afpineda/OpenSourceSimWheelESP32/doc/hardware/subsystems/BatteryMonitor/BatteryMonitor_en.md

# Battery monitor subsystem

This subsystem is for **battery-operated** systems, only.

> [!CAUTION]
> This subsystem is designed to work with batteries below 5 volts.
> Higher voltages may damage your DevKit board.

## Purpose

The purpose of this subsystem is to provide an estimation
of how much battery charge is left,
so the user knows when to plug the charging cable in.
The battery level is a percentage of charge left in the range 0% to 100%
(also known as "state of charge" or "SoC").
Battery level is known to the hosting PC through Bluetooth Low Energy.

There are several (exclusive) **alternate implementations** to choose from:

- *Simple voltage divider*: can be found in some ESP32 DevKit boards
  as a built-in feature.
- *Battery monitor*: avoids battery drainage
  thanks to additional on/off circuitry.
- *"Fuel gauge" chip*: provides state-of-the-art SoC estimation.

The firmware will read the battery level every few minutes
and it takes only a few milliseconds long.

## Simple voltage divider or battery monitor

### Limitations

**Accurate battery SoC cannot be achieved** in this project
(or in most home-made electronics) using these implementations.
SoC estimation is harder than you may think.
For SoC, consumer electronics use a combination of complex circuitry,
factory measurements and software (even Artificial Intelligence).
This is out of scope for a home-made project.

For further reading, look at this article:
[Battery Management System (BMS): Effective Ways to Measure State-of-Charge and State-of-Health](https://www.integrasources.com/blog/battery-management-system-bms-state-charge-and-state-health/)

### Working principles

A battery monitor needs to read the output voltage of the battery
(*not* the powerboost output voltage), this is,
the voltage at the positive terminal
(the negative terminal is wired to ground - `GND`).
As the battery gets discharged, that voltage will go down.
The output voltage of a LiPo battery is in this range (more or less):

- 4.0V to 5.0V when the powerboost module is charging the battery.
- 3.7V when the battery is fully charged.
- Over 2.4V or less when the battery is discharged.
  The powerboost module will cut power to avoid over discharge.

In some way, this output voltage should be read through an ADC pin,
however, there are two restrictions:

- The output voltage of the battery exceeds 3.3V
  and would damage the DevKit board,
  so that voltage has to drop down to a suitable range.
- Reading the output voltage could discharge the battery itself,
  so the battery monitor should not draw any relevant current.

### Battery monitor

This circuit is switched on and off by the means of an NPN-PNP pair.
It will not draw any relevant current
except for a few milliseconds every few minutes.

This circuit uses the following terminals:

- **Battery (+)** (battery positive terminal):
  a wire has to be soldered to that terminal at the powerboost module.
- **battEN** pin: enables or disables the circuit.
  Attached to an output-capable GPIO pin at the DevKit board.
- **battREAD** pin: provides the current battery level.
  Attached to an ADC-capable GPIO pin at the DevKit board.

`GND` pin is shared with the main circuit,
wired to `GND` at the powerboost module.

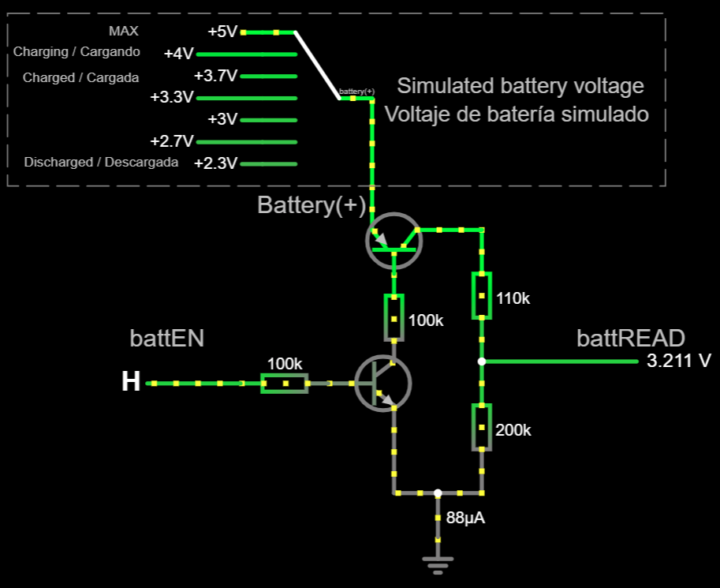
[picture p27: doc/hardware/subsystems/BatteryMonitor/BatteryMonitor_falstad.png]
Battery monitor circuit


[This simulation at falstad.com](https://falstad.com/circuit/circuitjs.html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)
shows how it works, but note that the rectangle is not part of the circuit.

Needed parts:

- 100K-ohms resistor (x2)
- 110K-ohms resistor (x1), **1% tolerance**.
- 200K-ohms resistors (x1), **1% tolerance**.
- A bipolar junction transistor (x1), NPN type: any kind should work
  (for example: [BC637](https://www.onsemi.com/pdf/datasheet/bc637-d.pdf)).
- A bipolar junction transistor (x1), PNP type: any kind should work
  (for example: [BC640](https://www.onsemi.com/pdf/datasheet/bc640-d.pdf)).

In fact, any impedance will work as long as `battREAD`
is below 3.3 volts at all times (assuming `battery(+)` is always below 5 volts).
However, the higher the voltage drop,
the less the accuracy in battery levels (state of charge).

Pay attention to the pin-out of your transistors.
It *may not match* the one shown here.

Look at this [layout design](./BatteryMonitor.diy) using
[DIY Layout Creator](https://github.com/bancika/diy-layout-creator).

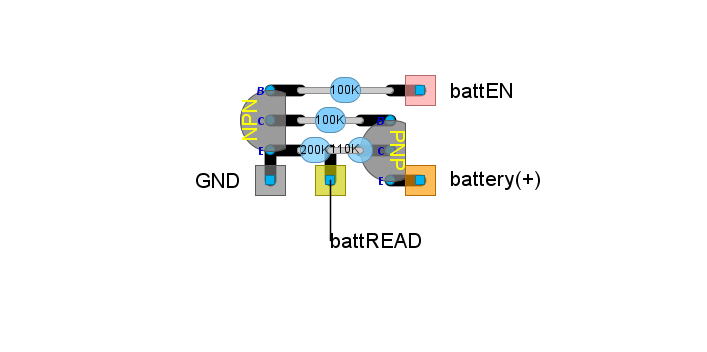
[picture p28: doc/hardware/subsystems/BatteryMonitor/BatteryMonitor_diy.png]
Board design


### Simple voltage divider

This kind of circuit is built into some ESP32 boards.
In such a case, there is no need to build this subsystem.
However, we also provide the design in case
you are short of available GPIO pins for the previous alternative.
The circuit uses the same terminals, except for `BattEN`, which is not needed.

- **Battery (+)** pin (battery positive terminal).
  Usually not exposed in the alluded boards.
- **battREAD** pin: provides the current battery voltage.
  May be exposed or not in the alluded boards.
  If not exposed, it will be wired internally to a certain GPIO.
  If exposed (with another tag, for sure),
  you must wire it externally to an ADC-capable GPIO. Check the datasheet.

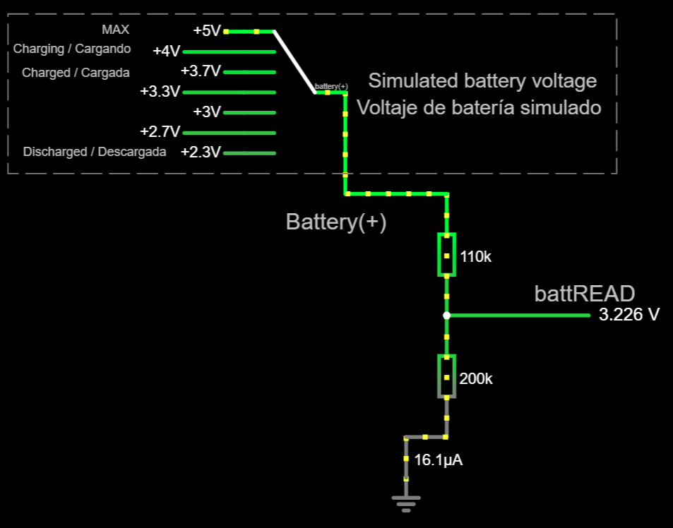
[picture p29: doc/hardware/subsystems/BatteryMonitor/BatteryDivider_falstad.png]
Voltage divider for the battery monitor


[This simulation at falstad.com](https://falstad.com/circuit/circuitjs.html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) shows how it works, but note that the rectangle is not part of the circuit.

Needed parts:

- 110K-ohms resistor (x1), 1% tolerance.
- 200K-ohms resistor (x1), 1% tolerance.

In fact, any impedance above 100K-ohms will work as long as `battREAD`
is below 3.3 volts at all times.
Do not use lower impedance or this circuit will drain your battery quicker
than the DevKit board itself.
The higher the voltage drop,
the less the accuracy in battery levels (state of charge).

This alternative will deplete your battery very slowly,
even when the system is in a deep sleep state or not powered.
An [external power latch circuit](../PowerLatch/PowerLatch_en.md)
will **not prevent** this.

An incomplete list of DevKits featuring a built-in voltage divider follows,
along with their internal wiring:

| DevKit | battREAD |
| --- | --- |
| [Tinypico](https://www.tinypico.com/) | GPIO #35 |
| [TinyS3](https://esp32s3.com/tinys3.html) | GPIO #10 |
| [Adafruit Feather 32u4 Bluefruit LE](https://www.adafruit.com/product/2829) | GPIO #9  |
| [Wemos D32](https://www.wemos.cc/en/latest/d32/d32.html) | GPIO #35 |
| [LilyGo T7S3](https://www.lilygo.cc/products/t7-s3) | GPIO #2  |

## Fuel gauge

A "fuel gauge" (not to be taken literally) is a specialized chip
for accurate state of charge measurement.

This project supports the popular
[MAX1704x](https://www.analog.com/en/search.html?query=max1704)
family of fuel gauges made by Maxim/Analog Devices.
As long as those chips accept the same set of commands over the I2C connection,
the firmware will work with them.

Note that those chips are not sold in through-hole packaging,
so **you should buy a pre-made module** instead,
or a DevKit featuring a compatible built-in fuel gauge.
Make sure the chosen module is **compatible with 3.3V boards**,
otherwise it will damage your board.

**There is no reverse polarity protection**.
Make sure the battery is properly wired.
Otherwise, the chip may get damaged.

The chip requires some time to start reporting meaningful battery levels,
especially if you plug a new battery.

There are, at least, two modules in the market and plenty of cheap clones.

### Sparkfun TOL-20680 and clones

Don`t get fooled by the scale of the picture. This module is very small.

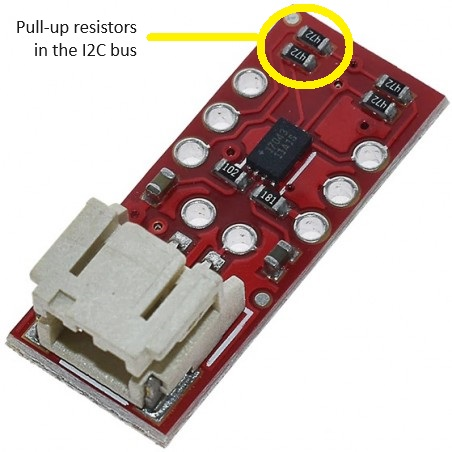
[picture p30: doc/hardware/subsystems/BatteryMonitor/TOL-20680_front.jpg]
TOL-20680 front side


There are two hardware revisions of this module: V1.1 and V1.2 (or later).
They share the same pinout:

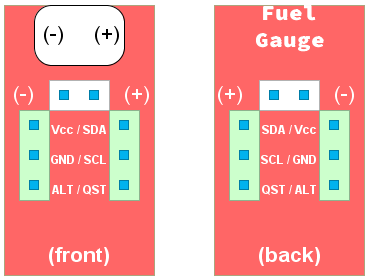
[picture p31: doc/hardware/subsystems/BatteryMonitor/TOL-20680_pinout.png]
TOL-20680 pinout


#### TOL-20680 V1.1

This version of the module is inappropriate and **will harm your board**.
There is a **workaround** to utilize them, though:
[take out](https://www.youtube.com/watch?v=8JM4oCpWnjU)
 the pull-up resistors shown in the image above.

Use a low-cost multimeter in short-circuit detection mode
to determine whether your module is V1.1.
You have version 1.1 if there is an electrical connection
between pins `(+)` and `Vcc`. Most low-cost copies are V1.1.

There is no circuit involved here, just wiring:

| Pin tag in "hacked" TOL-20680 V1.1 | Wired to |
| --- | --- |
| `SDA` | `SDA` (DevKit) |
| `SCL` | `SCL` (DevKit) |
| `GND` | `GND`(DevKit or satellite circuit) |
| `Vcc` | (**Not connected**) |
| `(-)` | Negative pole of the battery |
| `(+)` | Positive pole of the battery |
| `ALT` | (Not connected) |
| `QST` | (Not connected) |

Do not attach any other pin to your DevKit, or it will get damaged.
The module gets power from the battery itself. No need to wire a power source.

#### TOL-20680 V1.2

This version is safe. There is no circuit involved here, just wiring:

| Pin tag in TOL-20680 V1.2 | Wired to |
| --- | --- |
| `SDA` | `SDA` (DevKit) |
| `SCL` | `SCL` (DevKit) |
| `GND` | `GND` (DevKit or satellite circuit) |
| `Vcc` | `3V3` (DevKit or satellite circuit) |
| `(-)` | Negative pole of the battery |
| `(+)` | Positive pole of the battery |
| `ALT` | (Not connected) |
| `QST` | (Not connected) |

### Adafruit MAX17048 LiPoly / LiIon Fuel Gauge and Battery Monitor by Liz Clark (and clones)

Don`t get fooled by the scale of the picture. This module is small.

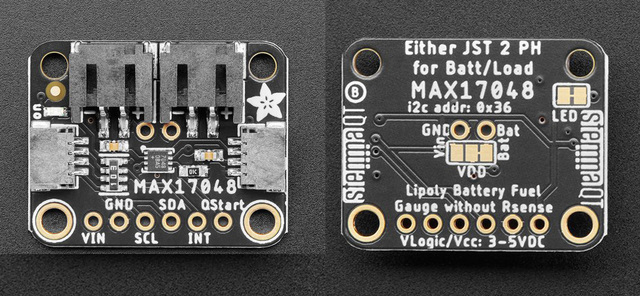
[picture p32: doc/hardware/subsystems/BatteryMonitor/Adafruit_MAX17048_module.jpg]
Sparkfun MAX17048


You can see the pin-out in the picture.
There is no circuit involved here, just wiring:

| Pin tag in Adafruit MAX17048 | Wired to |
| --- | --- |
| `SDA` | `SDA` (DevKit) |
| `SCL` | `SCL` (DevKit) |
| `GND` | `GND` (DevKit or satellite circuit) |
| `VIN` | `3V3` (DevKit or satellite circuit) |
| `(-)` or `GND` | Negative pole of the battery |
| `(+)` or `Bat` | Positive pole of the battery |
| `INT` | (Not connected) |
| `QStart` | (Not connected) |

You may use the StemmaQT and JST connectors instead.

### Other wiring

Wiring to a powerboost or DevKit board with built-in battery support:

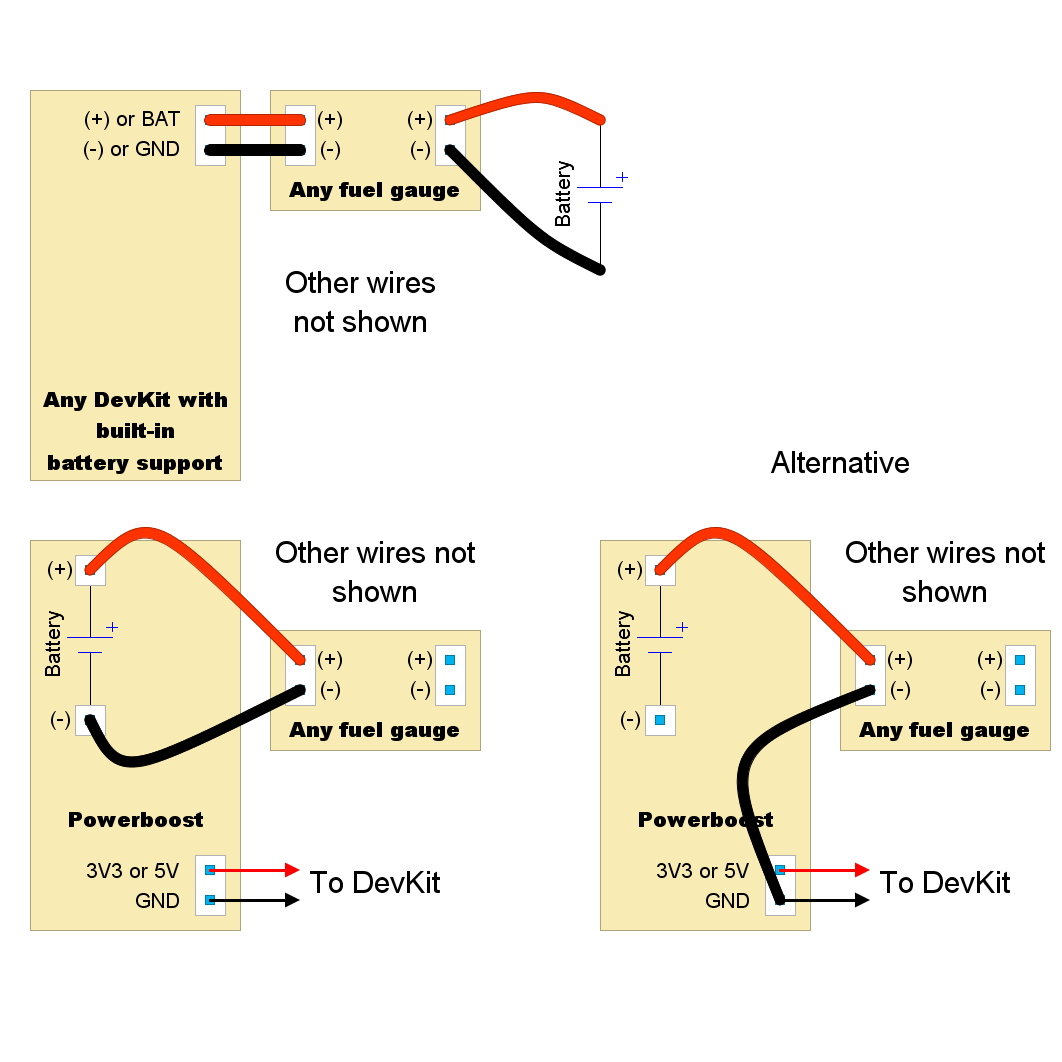
[picture p33: doc/hardware/subsystems/BatteryMonitor/FuelGauge_wiring.png]
Fuel gauge wiring


## Firmware customization (simple voltage divider or battery monitor)

Only a rough estimation of battery charge can be provided out of the box.
Battery level will be unreliable until the battery
is fully charged for the first time.

For better results, a battery calibration procedure must be followed,
which is extensively documented
[here](../../../../src/Firmware/BatteryTools/BatteryCalibration/README.md)
along with the required Arduino sketch.
**This is not mandatory but highly recommended**.

Customization takes place at file
[CustomSetup.ino](../../../../src/Firmware/CustomSetup/CustomSetup.ino).
Ensure the following line of code is in place:

```c
#define ENABLE_BATTERY_MONITOR
```

### Battery monitor (design 1)

Locate the line `#define BATTERY_ENABLE_READ_GPIO`
and write a GPIO number to the right,
where `battEN` is attached to. Locate the line `#define BATTERY_READ_GPIO`
and write a GPIO number to the right,
where `battREAD` is attached to. For example:

```c
#define BATTERY_ENABLE_READ_GPIO 0
#define BATTERY_READ_GPIO 36
```

### Simple voltage divider (design 2)

Locate the line `#define BATTERY_READ_GPIO`
and write a GPIO number to the right,
where `battREAD` is attached to. Set `BATTERY_ENABLE_READ_GPIO` as shown below:

```c
#define BATTERY_ENABLE_READ_GPIO -1
#define BATTERY_READ_GPIO 36
```

## Firmware customization (fuel gauge)

In file [CustomSetup.ino](../../../../src/Firmware/CustomSetup/CustomSetup.ino)
just uncomment the following line:

```c++
#define ENABLE_FUEL_GAUGE
```

Or just call `batteryMonitor::configure()` with no parameters.
However, if your chip uses a non-standard I2C address,
you must provide the proper 7-bit address as the first parameter.
The expected (standard) 7-bit address is 36 (hexadecimal).

Your chip/module will share the I2C bus with
[GPIO expanders](../Switches/Switches_en.md#gpio-expanders),
if any.

> [!NOTE]
> If the chip/module is not powered or not found in the I2C bus,
> the system will boot normally.

## Further firmware customization

Regardless of the implementation you choose,
you may set the following parameters (not mandatory).

### Polling interval

Place a call to `batteryMonitor::setPeriod()`.
The first parameter is a time interval in seconds.
By default, this is set to 180 seconds (3 minutes).
It sets the time interval between measurements.

### Shutdown on critical battery levels

Place a call to `batteryMonitor::setPowerOffSoC()`.
The first parameter is a percentage of battery charge (0% to 100%).
If the measured state of charge is below the given parameter,
the system will go into deep sleep or power off before it stops working.
This prevents the system from depleting the battery even
if there is not enough power to keep it working.
Do not set too high.

Call `batteryMonitor::setPowerOffSoC(0)` to disable this feature,
which is the default.

*Advice*:
Do not enable this feature if your battery monitor is not reasonably accurate.

### Charging witness

If your DevKit board features a battery charger and a charging witness signal,
the firmware can take advantage of it.
Place a call to `batteryMonitor::setChargingWitness()` with the following
parameters:

1. Input pin number where the witness signal is attached to.
2. `true` if the witness signal is low when charging
   and high when not charging (negative logic), `false` otherwise.
3. `true` to enable an internal pull resistor, `false` otherwise.

If the witness signal works in open drain mode,
you should call `batteryMonitor::setChargingWitness(<pin>,true,true);`.

## Unknown state of charge

The firmware will be unable to compute a proper
state of charge in the following situations:

- The battery is not properly wired to the battery monitor,
  voltage divider or fuel gauge.
- The actual I2C address of the fuel gauge is not what this firmware expects.
- The fuel gauge is not compatible with this firmware.
- **The battery is being charged**.

In those cases, you will get a constant state of charge at the host computer:

- 66% if the battery is being charged.
  The firmware is unable to get a reliable value in this case.
- 0% otherwise.
