afpineda/OpenSourceSimWheelESP32/doc/hardware/ui/PCF8574RevLights/PCF8574RevLights_en.md

# PCF8574-driven "rev lights"

This telemetry indicator consists of eight single-color LEDs
arranged from left to right.
It displays the current engine RPM and flashes when the RPM limiter is reached.

One I2C bus is required and the secondary bus is recommended.

## Hardware design

Edit [this design](./PCF8574RevLights.diy) using DIY Layout Creator.

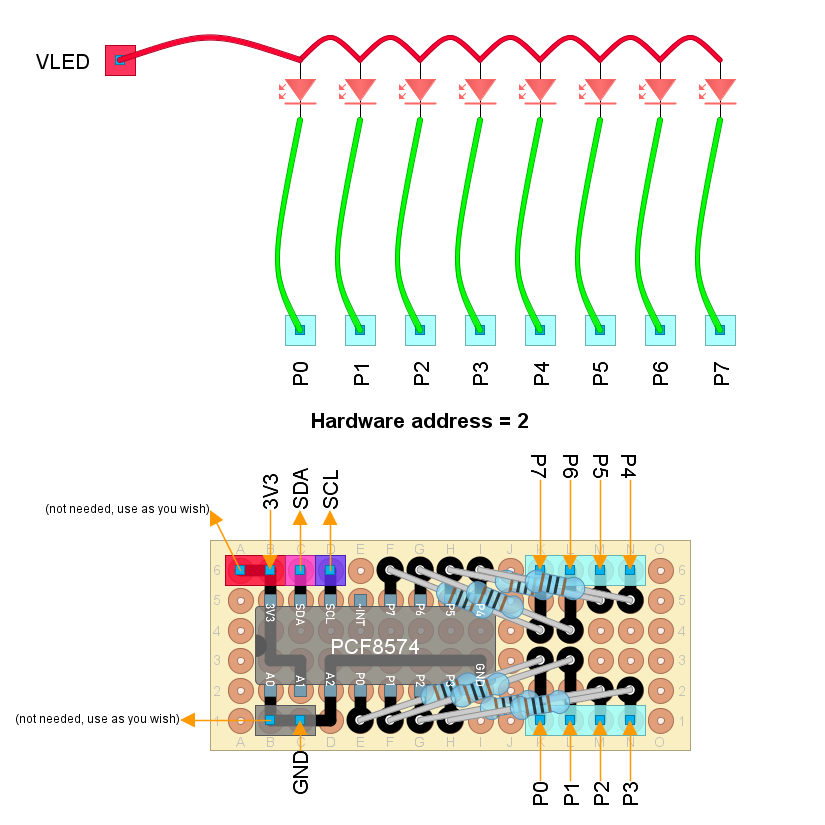
[picture p39: doc/hardware/ui/PCF8574RevLights/PCF8574RevLights.png]
Circuit design


Components required:

- Single color LEDs (x8).
  Forward voltage ( $V_F$ ) must not exceed 3.2 volts
  if you are wiring `VLED` to `3V3`.
  Red color is recommended ( $V_F=1.6$ ).
- 1 K-ohm resistors (x8).
- [PCF8574](../../esp32reference/PCF8574_datasheet.pdf) GPIO expander.
- Wires.

External wiring:

- `VLED` is wired to the power source.
  Both `3V3` and `5V` will work in this case.
- Attach `SCL` and `SCA` to the corresponding pins at the DevKit board.
  You may configure any output-capable pin as
  `SCL`/`SDA` to work as a secondary I2C bus.

## Firmware customization

The involved class is `PCF8574RevLights`.
Constructor parameters are:

1. I2C *hardware* address (3 bits),
   as configured using pins `A0`, `A1` and `A2`.
   Pass `2` (decimal) when using the above design.
2. I2C bus. Optional (default is `I2CBus::SECONDARY`).
3. *factory-defined* I2C address (7 bits).
   Defaults to `20` (hexadecimal) as stated in the data sheet.
   However, the data sheet does not seem to be respected.
   Use the [I2C probe](../../../../src/Firmware/I2C_probe/I2C_probe.ino) to learn
   the actual I2C address.
   I found some chips using address `38` (hexadecimal).
4. Display mode (left to right, right to left, center to edges, or edges to center).
   A constant in the `RevLightsMode` enumeration.
   Default is left to right.

For example:

```c++
 ui::add<PCF8574RevLights>(
    2,
    I2CBus::SECONDARY,
    0x38,
    RevLightsMode::LEFT_TO_RIGHT);
```

If you are using the secondary I2C bus,
you **must** first initialize it to the desired `SDA` and `SCL` pins.
See [Overview of telemetry](../../../telemetry_en.md).

See the corresponding
[integration test](../../../../src/QualityControl/IntegrationTests/TelemetryIntegrationTest/TelemetryIntegrationTest.ino)
for an example.

## Notifications

- On startup:

  The length of the LED bar will show the battery charge for one and a half seconds.
  If there is no battery all LEDs will light up.

- On connection:

  All LEDs will flash twice.

- On bite point:

  The length of the LED bar will show the bite point for a short moment.

- On low battery

  The LEDs will glow alternately in a momentary animation.

- On save settings

  Two lights will move from the ends to the centre.
