afpineda/OpenSourceSimWheelESP32/doc/skills_en.md

# Required skills and tools

## Software tools (and external dependencies)

Indispensable:

- [Arduino IDE](https://www.arduino.cc/en/software).
  Choose a stable release and follow instructions.
  This project has been successfully compiled with **version 2.3.10**.

- Official [Arduino-ESP32 support package](https://docs.espressif.com/projects/arduino-esp32/en/latest/getting_started.html).
  Follow
  [this link](https://docs.espressif.com/projects/arduino-esp32/en/latest/installing.html)
  for installation instructions.
  This project has been successfully tested with **version 3.3.12**.
  Any versión prior to 3.3.0 will not work.

May be needed:

- [Powershell](https://docs.microsoft.com/en-us/powershell/scripting/install/installing-powershell?view=powershell-7.2).
  Already installed in Windows. Not strictly needed in Linux or Mac.

- [ESP32 drivers](http://esp32.net/usb-uart/) on Windows.
  A tutorial: [Installing drivers for the ESP32](https://www.bromleysat.com/installing-drivers-for-the-esp32/).
  Depending on what DevKit board you choose, a different driver may be needed.
  Check all information available from the manufacturer.

- [Arduino libraries](https://docs.arduino.cc/software/ide-v1/tutorials/installing-libraries):

  - [h2zero/NimBLE-Arduino](https://www.arduino.cc/reference/en/libraries/nimble-arduino/).
    This project has been successfully tested with **version 2.5.2**.
    Any version prior to version 2.2.0 will not work.
    **Required only for "pure" ESP32 DevKit boards**.

  - [Adafruit GFX](https://docs.arduino.cc/libraries/adafruit-gfx-library/).
    This project has been successfully tested with **version 1.12.5**.
    **Required only for telemetry display via OLED hardware**.

> [!WARNING]
> This project is not guaranteed to work with untested versions
> of these dependencies.
> When troubleshooting, check this first.
>

Recommended:

- [DIY layout creator](https://bancika.github.io/diy-layout-creator/).
  [Alternate link](https://github.com/bancika/diy-layout-creator/releases).
  This is a design tool for the physical layout of hand made circuit boards.

- Any joystick test application able to display 128 buttons:

  - [Planet pointy's joystick test application](http://www.planetpointy.co.uk/joystick-test-application/)
    (for Windows 10). **Does not work in Windows 11**.

  - [pygame-joystick-test](https://github.com/denilsonsa/pygame-joystick-test).
    Works in any operating system, but requires Python.

  - [Multi-joystick tester](https://github.com/EDDiscovery/MultiJoyStickTest/releases/tag/Release_1_2_0).
    Works in Windows 11.
    Best choice for now, but be aware
    that this app may miss some rotation events from rotary encoders
    due to its own polling interval (not a firmware's fault).

- [Visual Studio Code](https://code.visualstudio.com/),
  as an alternative to Arduino IDE.
  Requires [Arduino Community Edition for VSCode](https://marketplace.visualstudio.com/items?itemName=vscode-arduino.vscode-arduino-community).
  Installable from VSCode itself.
  **Note**: The official Arduino extension was deprecated.

- SimpleHIDWrite.exe: available at
  [http://janaxelson.com/hidpage.htm](http://janaxelson.com/hidpage.htm).
  There is a modern clone here:
  [benbaker76/SimpleHIDWrite](https://github.com/benbaker76/SimpleHIDWrite/tree/master/BIN).
  This tool is used in this project to test custom HID reports.

- PCB design tools:

  - [EasyEDA Pro](https://pro.easyeda.com/editor).
    This is a free tool and very easy to learn.
    You can install it locally or run it online
    (a free account may be required).
    From this tool, you can order a PCB (and optional assembly)
    to [JLCPCB](https://jlcpcb.com/).

  - [KiCAD](https://www.kicad.org/).
    Free and open source.

## Hardware tools

Indispensable:

- [Soldering iron](https://en.wikipedia.org/wiki/Soldering_iron) for electronics
- Thin welding tin with flux
- Cutting pliers

Recommended:

- A ["third hand"](https://en.wikipedia.org/wiki/Helping_hand_(tool))
- A soldering stand
- A cheap [multimeter](https://en.wikipedia.org/wiki/Multimeter)
- A [protoboard](https://en.wikipedia.org/wiki/Breadboard)
- A kit of Dupond wires for protoboards

## Skills

There are lots of resources out in the Internet to learn those skills.
Just use your favorite search engine.

Indispensable:

- Basic soldering for electronics.
- Compile, upload and run Arduino's *sketches* using *Arduino IDE*.
- Run powershell scripts (for Windows users only).

Recommended:

- [Ohm's law](https://en.wikipedia.org/wiki/Ohm%27s_law).
- Basics of switches, resistors, diodes and transistors.
- Role of [pull-up](https://en.wikipedia.org/wiki/Pull-up_resistor)
  and pull-down resistors.
- Basics of C and C++ programming languages.
- [How to order a custom PCB](https://duckduckgo.com/?q=how+to+order+a+custom+pcb&ia=web)
