afpineda/OpenSourceSimWheelESP32/doc/firmware/HID_notes.md

# Notes on Human Interface Device (HID) implementation

This project implements a HID device (sorry for the redundancy)
which may be used both through the USB and Bluetooth GATT protocol stacks.
Most relevant implementation details can be found at file
[HID_definitions.h](../../src/include/HID_definitions.hpp)

This document does not intent to explain HID devices.
A good source is [Jan Axelson's Lakeview Research](http://www.janaxelson.com/hidpage.htm).

## License and copyright concerns

### USB

Any HID device requires a vendor identifier ("VID" from now on) in order to work.
Those identifiers are assigned to individual vendors through a license managed by
["The USB Implementers Forum"](https://www.usb.org/about), aka "USB-IF".
That license is not open-source-friendly and the $6000 fee discourages any home-made project attempt.

More information at [Open source Hardware Association](https://oshwa.org/resources/open-source-hardware-faq/).

This project features an USB implementation using the existing PID (product identifier)
and VID from your DevKit manufacturer, which you should not change.

As a result, you are not allowed to use this project outside of your personal sphere.
You are not allowed to exhibit the USB logo nor any other licensed material from the USB-IF.

### Bluetooth

When using the Bluetooth stack, HID devices may use VIDs from different "sources".
As seen at the
[Device Information Service Specification](https://www.bluetooth.org/docman/handlers/downloaddoc.ashx?doc_id=244369):

| Vendor ID source | Description |
| :---: | --- |
| 0x01 | Bluetooth SIG-assigned Device ID Vendor ID value from the Assigned Numbers document |
| 0x02 | USB Implementer’s Forum assigned Vendor ID value |
| other | Reserved for future use |

I don't know what is the legal situation when a reserved VID source is used.
At least, there is a way to avoid the USB-IF's licenses.

## HID reports

This project make use of a number of HID reports:

| Report ID |  Type | Purpose |
| :---: | :-----: | --- |
| 1 |  Input  | Buttons, clutch, POV and the like |
| 2 | Feature | Wheel capabilities |
| 3 | Feature | Wheel configuration |
| 4 | Feature | User-defined buttons map |
| 5 | Feature | Custom hardware ID |
| 20 | Output  | Telemetry data / Powertrain |
| 21 | Output  | Telemetry data / ECU |
| 22 | Output  | Telemetry data / Race control |
| 23 | Output  | Telemetry data / Gauges |
| 24 | Output  | Telemetry data / Wheels |
| 30 | Output  | Pixel control |

Note that feature reports are both read and write.

## Data format of report ID 1 (input)

| Field | Bits size | Byte index |
| --- | :---: | :---: |
| Buttons state | 128 | 0 |
| Rz axis | 8 | 16 |
| Ry axis | 8 | 17 |
| Rx axis | 8 | 18 |
| POV (D-PAD) | 4 | 19 |
| Feature notification | 4 | 19 |

- Buttons state: one bit per button (1=pressed, 0=non-pressed).
  The least significant bit is the first button.
- Axes: an unsigned byte in the range 0 to 254.
  - Rz: F1-Style clutch (combined input from left and right clutch paddles)
  - Ry: Left clutch paddle
  - Rx: Right clutch paddle
- POV (D-PAD): 4 least significant bits of byte index 19. Range: 0 to 8.
- Feature notification: 4 most significant bits of byte index 19.
  Valid values: 0 (nothing to notify) or 3 (wheel configuration has changed).

## Data format of report ID 2 (wheel capabilities)

Write attempts will be ignored, so this report is read-only.

| Byte index | Size (Bytes) | Purpose (field) | Note | Since data version |
| :---: | :---: | --- | --- | --- |
| 0 | 2 | Magic number | Always set to BF51 (hexadecimal) | 1.0 |
| 2 | 2 | Major Version | Version of this specification | 1.0 |
| 4 | 2 | Minor Version | Version of this specification | 1.0 |
| 6 | 2 | Flags | Device capabilities | 1.0 |
| 8 | 8 | ID | Chip identifier | 1.1 |
| 16 | 1 | Max FPS | Maximum frames per second | 1.3 |
| 17 | 1 | Pixel count | In the "telemetry leds" group | 1.4 |
| 18 | 1 | Pixel count | In the "Buttons lighting" group  | 1.4 |
| 19 | 1 | Pixel count | In the "Individual LEDs" group | 1.4 |

Report ID 1 (input) is not affected by versioning.

### Magic number

The purpose of such a field is to enable device detection and recognition,
without the need to rely on a particular VID or product ID.

### Major and minor version

Two different major versions means incompatible data formats.
A greater minor version means a backwards-compatible data format.
Host-side software should check for version compatibility.
Some examples:

| Device version | Supported version at host | Result |
| :---: | :---: | :---: |
| 1.5 | 2.0 | Incompatible |
| 2.0 | 1.1 | Incompatible |
| 1.6 | 1.1 | Incompatible |
| 2.3 | 2.7 |  Compatible  |

However, host-side software may support several data versions at the same time.

Current data version is 1.6.

### Flags

The "flags" field is a set of 1-bit flags.
Flags are indexed starting from the least significant bit.
Non indexed bits are reserved for future use.
Current flags are enumerated in `DeviceCapability` at file [SimWheelTypes.hpp][def]
This is a summary:

- Digital clutch paddles
- Analog clutch paddles
- "ALT" buttons
- DPAD
- Battery
- Calibration data for the battery
- Display for powertrain telemetry
- Display for ECU telemetry
- Display for race control telemetry
- Display for gauges telemetry
- Rotary encoders

### ID

This is the internal chip identifier as reported by
[esp_efuse_mac_get_default()](https://docs.espressif.com/projects/esp-idf/en/latest/esp32/api-reference/system/misc_system_api.html).
Useful to distinguish one device from another.

### Max FPS

This is the maximum display rate (in frames per second) supported by the device's user interface.
Zero will be read if there is no user interface.
When sending telemetry data (output reports),
the host computer should adapt its data rate to this display rate.

### Pixel count fields

The number of RGB pixels available for pixel control (see report ID 30).
There are three groups of pixels.
Zero means that pixel control is not available in that group.

## Data format of report ID 3 (wheel configuration)

While writing, any value outside of the valid range will be ignored,
so they me be used to mask which fields to modify or not.

| Byte index | Size (bytes) | Purpose (field) | Since data version |
| :---: | :---: | --- | --- |
| 0 | 1 | Working mode of clutch paddles | 1.0 |
| 1 | 1 | Working mode of ALT buttons | 1.0 |
| 2 | 1 | Current bite point | 1.0 |
| 3 | 1 | Simple command / Current battery level | 1.0 |
| 4 | 1 | Working mode of DPAD inputs | 1.1 |
| 5 | 1 | Security lock | 1.2 |
| 6 | 1 | Pulse width multiplier for rotary encoders | 1.5 |

### Working mode of clutch paddles

Read/write (unless locked).
Valid values are enumerated in `ClutchWorkingMode` at file [SimWheelTypes.hpp][def].
Write FF (hexadecimal) to ignore this field.

### Working mode of ALT buttons

Read/write (unless locked).
Non zero means "ALT mode". Zero means "regular buttons".
Write FF (hexadecimal) to ignore this field.

### Current bite point

Read/write (unless locked).
Write FF (hexadecimal) to ignore this field.

### Simple command / Current battery level

At read:

- Retrieve current battery level. Non meaningful if there is no battery. Check capabilities.

At write (unless locked):

- Send a simple command. Valid commands are enumerated in `SimpleCommand` at file [SimWheelTypes.hpp][def].
  This is a summary:

  | Simple command (decimal) | Description                                                                        |
  | ------------------------ | ---------------------------------------------------------------------------------- |
  | 1                        | Recalibrate analog clutch paddles (if any).                                        |
  | 2                        | Restart battery auto-calibration. Ignored if the battery was "factory-calibrated". |
  | 3                        | Reset user-defined button mapping to factory defaults.                             |
  | 4                        | Save all user settings at once (including button mapping).                         |
  | 5                        | Reverse left clutch paddle polarity (analog only if any).                          |
  | 6                        | Reverse right clutch paddle polarity (analog only if any).                         |
  | 7                        | Show all pixels in all groups at once                                              |
  | 8                        | Turn off all pixels in all groups                                                  |

- Write FF (hexadecimal) to ignore this field.

### Working mode of DPAD inputs

Read/write (unless locked).
Non zero means "navigation controls". Zero means "regular buttons".
Write FF (hexadecimal) to ignore this field.

### Security lock

**Read-only**.

When zero, write is allowed. Otherwise, write is forbidden.

For security concerns, the user can lock or unlock all writing attempts to HID reports by using just hardware inputs.
This is a security precaution to stop unauthorized configuration modifications caused by rogue programs.

### Pulse width multiplier for rotary encoders

Read/write (unless locked).
Write FF (hexadecimal) to ignore this field.

Valid values are in the range from `1` to `16` (inclusive).
Invalid values are ignored.
Valid values are saved to flash memory without delay.

## Data format of report ID 4 (user-defined buttons map)

| Byte index | Size (bytes) | Purpose (field) | Since data version |
| :---: | :---: | --- | --- |
| 0 | 1 | Selected firmware-defined button number | 1.1 |
| 1 | 1 | User-defined button number when ALT mode is disengaged | 1.1 |
| 2 | 1 | User-defined button number when ALT mode is engaged | 1.1 |

**Important note**: any change in the user-defined map is **not** automatically saved to flash memory.
In order to save, you must issue the corresponding *simple command* using report ID 3.

### Firmware-defined button number

At read:

- A selected button number in the range from 0 to 63, which identifies a firmware-defined button.
- Any value outside of the previous range may be read, which means no button number is selected.

In order to select another button number, write to this field first.

At write (unless locked):

- Select a firmware-defined button number. Any value outside the valid range will be ignored.
- You should read after a write in order to known the user-defined map for the selected button number.
  Note that another application may also write this field,
  so don't assume the button you select is the button you will read next.

### User-defined map (bytes at index 1 and 2)

At read:

- The current user-defined button number for the selected firmware-defined button number.
- A value of FF (hexadecimal) means the selected button is not available.

At write (unless locked):

- Any value in the range from 0 to 127:
  set a user-defined button number for the selected firmware-defined button number.
- Any value outside of the previous range: just select another firmware-defined button number,
  but do not overwrite current map.

Examples (pseudo-code):

- To list all available inputs and current map:

  ```c++
  for (uint8_t i = 0; i < 64; i++) {
     report4.write(i,0xFF,0xFF);
     report4.read(j,map,mapAlt);
     if (i != j)
        another_app_is_interfering();
     else if ((map > 127) || (mapAlt > 127))
        input_number_not_available(i);
     else
        show_map(i,map,mapAlt);
  }
  ```

- To map button number 13 to button numbers 16 (ALT disengaged) and 112 (ALT engaged):

  ```c++
  report4.write(13,16,112);
  ```

- To map button number 17 as it was in factory defaults:

  ```c++
  report4.write(17,17,17+64);
  ```

- To save current map to flash memory:

  ```c++
  report3.write(0xFF,0xFF,0xFF,4);
  ```

- To revert user-defined map to factory defaults (and save):

  ```c++
  report3.write(0xFF,0xFF,0xFF,3);
  report3.write(0xFF,0xFF,0xFF,4);
  ```

## Data format of report ID 5 (custom hardware ID)

| Byte index | Size (bytes) | Purpose (field) | Since data version |
| :---: | :---: | --- | --- |
| 0 | 2 | Custom vendor ID  | 1.2 |
| 2 | 2 | Custom product ID | 1.2 |
| 4 | 2 | Control code | 1.2 |

### Custom vendor ID (VID) and product ID (PID)

Those fields enable the user to set a custom VID and PID for BLE devices only.
Changes will be available after a reset or power-off.

At read:

The VID and PID configured for the subsequent reboot will be retrieved.
Note that the custom VID will be ignored in boards having USB-OTG,
unless BLE-only connectivity is hard coded.

At write (unless locked):

- If both VID and PID are set to 0000,
  the hardware ID will return to factory defaults after the next reboot.
- Otherwise, the device will save the given VID and PID in flash memory
  and use them after the next reboot.

### Control code

This field prevents accidental changes.

At read:

- No meaning

At write (unless locked):

- Ignored in USB devices.
- If either VID or PID (or both) is set to 0000, this field must match AA96 (hexadecimal).
- Otherwise, this field must match $(VID*PID)\mod{65536}$.

  For example, if $VID=7504$ and $PID=303$, then this control code must match
  $(7504*303)\mod{65536}=2273712\mod{65536}=45488$

**No changes are made if there is no match.**

[def]: ../../src/include/SimWheelTypes.hpp

## Telemetry (output) reports

The host computer should look at device capabilities first (report 2 - "flags"),
then it should avoid writing to non-used output reports,
thus reducing bandwidth usage.

The nature of telemetry data is near real-time.
So the device may be unable to keep the pace of the host computer.
For this reason, the host computer should match the output rate
to the value in the "Max FPS" field in report 2.

The display hardware is not synced with the reception of telemetry data.
Some data may go unnoticed.

### Data format of report ID 20 (Telemetry / Powertrain)

| Byte index | Size  | Field | Data type | Data version | Related SimHub property (DataCorePlugin.GameData) |
| :---: | :---: | --- | --- | --- | --- |
| 0 | 1 | Gear | char | 1.3 | Gear |
| 1 | 2 | RPM | uint16 | 1.3 | Rpms |
| 3 | 1 | RPM percent | uint8 | 1.3 | CarSettings_CurrentDisplayedRPMPercent |
| 4 | 1 | Shift light 1  | uint8 | 1.3 | CarSettings_RPMShiftLight1 |
| 5 | 1 | Shift light 2  | uint8 | 1.3 | CarSettings_RPMShiftLight2 |
| 6 | 1 | Rev limiter | boolean | 1.3 | CarSettings_RedLineRPM |
| 7 | 1 | Engine started | boolean | 1.3 | EngineStarted |
| 8 | 2 | Speed | uint16 | 1.3 | SpeedLocal |

- **Gear**: a single ASCII character, typically "R", "N", "1", "2", etc.
- **RPM**: absolute revolutions per minute.
- **RPM percent**: relative revolutions per minute as a percentage for display.
- **Shift light 1**: Non-zero when the engine has reached maximum torque.
- **Shift light 2**: Non-zero when the engine has reached maximum power.
- **Rev limiter**: true when the engine has reached maximum RPM.
- **Engine started**: true if the engine is running.
- **Speed**: car speed in user-selected units. Do not assume Kph nor Mph.

### Data format of report ID 21 (Telemetry / ECU)

| Byte index | Size  | Field | Data type | Data version | Related SimHub property (DataCorePlugin.GameData) |
| :---: | :---: | --- | --- | --- | --- |
| 0 | 1 | ABS engaged | boolean | 1.3 | ABSActive |
| 1 | 1 | TC engaged | boolean | 1.3 | TCActive |
| 2 | 1 | DRS engaged | boolean | 1.3 | DRSEnabled |
| 3 | 1 | Pit limiter | boolean | 1.3 | PitLimiterOn |
| 4 | 1 | Low fuel alert | boolean | 1.3 | CarSettings_FuelAlertActive |
| 5 | 1 | ABS level | uint8 | 1.3 | ABSLevel |
| 6 | 1 | TC Level | uint8 | 1.3 | TCLevel |
| 7 | 1 | TC Cut | uint8 | 1.3 | |
| 8 | 1 | Brake bias percent | uint8 | 1.3 | BrakeBias |

- **TC Level**: sometimes called "TC1".
- **TC Cut**: sometimes called "TC2".
- **Brake bias**: a percentage of braking force towards the front wheels, in the range 0-100.

### Data format of report ID 22 (Telemetry / Race control)

| Byte index | Size  | Field | Data type | Data version | Related SimHub property (DataCorePlugin.GameData) |
| :---: | :---: | --- | --- | --- | --- |
| 0 | 1 | Black flag | boolean | 1.3 | Flag_Black |
| 1 | 1 | Blue flag | boolean | 1.3 | Flag_Blue |
| 2 | 1 | Checkered flag | boolean | 1.3 | Flag_Checkered |
| 3 | 1 | Green flag | boolean | 1.3 | Flag_Green |
| 4 | 1 | Orange flag | boolean | 1.3 | Flag_Orange |
| 5 | 1 | White flag | boolean | 1.3 | Flag_White |
| 6 | 1 | Yellow flag | boolean | 1.3 | Flag_Yellow |
| 7 | 2 | Remaining session laps | uint16 | 1.3 | RemainingLaps |
| 9 | 2 | Remaining session time (minutes) | uint16 | 1.3 | SessionTimeLeft |

- *Remaining session laps* should be zero if the session is time-based.
- *Remaining session time* should be zero if the session is laps-based.

## Data format of report ID 23 (Telemetry / Gauges )

| Byte index | Size  | Field | Data type | Data version | Related SimHub property (DataCorePlugin.GameData) |
| :---: | :---: | --- | --- | --- | --- |
| 0 | 1 | Relative turbo pressure | uint8 | 1.3 | TurboPercent |
| 1 | 2 | Absolute turbo pressure | uint16 fixed point | 1.3 | Turbo |
| 3 | 2 | Water temperature | uint16 | 1.3 | WaterTemperature |
| 5 | 2 | Oil pressure | uint16 fixed point | 1.3 | OilPressure |
| 7 | 2 | Oil temperature | uint16 | 1.3 | OilTemperature |
| 9 | 1 | Relative remaining fuel | uint8 | 1.3 | FuelPercent |
| 10 | 2 | Absolute remaining fuel | uint16 | 1.3 | Fuel |

All absolute values are expressed in user-selected units.

The following fields should be in the range from 0 to 100:

- Relative turbo pressure.
- Relative remaining fuel.

The following fields will be interpreted as fixed-point numbers with two decimals:

- Absolute turbo pressure.
- Oil pressure.

For example, the value 113 in `oil pressure` means 1.13 pressure units.

## Data format of report ID 24 (Telemetry / Wheels )

| Byte index | Size  | Field | Data type | Data version | Related SimHub property (DataCorePlugin.GameData) |
| :---: | :---: | --- | --- | --- | --- |
| 0 | 2 | Front-left tire temp. | uint16 | 1.7 | TyreTemperatureFrontLeft |
| 2 | 2 | Front-right tire temp. | uint16 | 1.7 | TyreTemperatureFrontRight |
| 4 | 2 | Rear-left tire temp. | uint16 | 1.7 | TyreTemperatureRearLeft |
| 6 | 2 | Rear-right tire temp. | uint16 | 1.7 | TyreTemperatureRearRight |
| 8 | 2 | Front-left tire pressure | uint16 fixed point | 1.7 | TyrePressureFrontLeft |
| 10 | 2 | Front-right tire pressure | uint16 fixed point | 1.7 | TyrePressureFrontRight |
| 12 | 2 | Rear-left tire pressure | uint16 fixed point | 1.7 | TyrePressureRearLeft |
| 14 | 2 | Rear-right tire pressure | uint16 fixed point | 1.7 | TyrePressureRearRight |
| 16 | 2 | Front-left brake temp. | uint16 | 1.7 | BrakesTemperatureFrontLeft |
| 18 | 2 | Front-right brake temp. | uint16 | 1.7 | BrakesTemperatureFrontRight |
| 20 | 2 | Rear-left brake temp. | uint16 | 1.7 | BrakesTemperatureRearLeft |
| 22 | 2 | Rear-right brake temp. | uint16 | 1.7 | BrakesTemperatureRearRight |
| 24 | 1 | Front-left wear percentage  | uint8 | 1.7 | TyreWearFrontLeft |
| 25 | 1 | Front-right wear percentage | uint8 | 1.7 | TyreWearFrontRight |
| 26 | 1 | Rear-left wear percentage | uint8 | 1.7 | TyreWearRearLeft |
| 27 | 1 | Rear-right wear percentage  | uint8 | 1.7 | TyreWearRearRight |

All absolute values are expressed in user-selected units.
All percentages should be in the range [0,100].

Tire pressures will be interpreted as fixed-point numbers with two decimals.

> [!NOTE]
> This data is not time-critical.
> The host computer should send this data at a **very low rate**
> (less than 1 FPS) ignoring the "MaxFPS" parameter.
> For example, once each five seconds.

## Data format of report ID 30 (Pixel control)

| Byte index | Size  | Field | Data version |
| :---: | :---: | --- | --- |
| 0 | 1 | Pixel group / pixel command | 1.4 |
| 1 | 1 | Pixel index | 1.4 |
| 2 | 1 | Blue channel | 1.4 |
| 3 | 1 | Green channel | 1.4 |
| 4 | 1 | Red channel | 1.4 |
| 5 | 1 | Reserved | 1.4 |

This report will set the color of a single pixel,
but **does not display it immediately**.
You will need to issue the appropriate *simple command* (see report ID 3)
or a *pixel command* (see below) in order to display all the pixels at once.

Note: Invalid values will be ignored with no effect.

- *Pixel group*: the group in which the pixel is to be set or a *pixel command*
  (new in data version 1.6).
  One of the constants defined in the `PixelGroup` enumeration or one pixel command:
  - `0xFF`: show all pixels at once
  - `0xFE`: turn off all pixels in all groups

  If a pixel command is found, other fields are ignored.

- *Pixel index*: the index of the pixel to be set in the given group,
  starting with zero.
  The number of available pixels can be obtained from report ID 2.

- *Blue, Red and Green channels*: define the color of the given pixel.
- *Reserved*: this field is reserved for future use and is ignored for now.
  Any value is valid.

> [!TIP]
> "Pixel commands" overlap with "simple commands" for a reason.
> MS Window's
> [HidD_SetFeature()](https://learn.microsoft.com/en-us/windows-hardware/drivers/ddi/hidsdi/nf-hidsdi-hidd_setfeature)
> API call, used to send feature reports such as ID 3, has a big impact on performance.
> Output reports do not have this problem.
