afpineda/OpenSourceSimWheelESP32/doc/firmware/glossary_en.md

# Glossary of terms and definitions

- **ADC**: Analog to Digital Converter.

- **Alternate mode** (or "ALT mode"):
  a function for certain buttons and clutch paddles.
  When engaged, events associated with _firmware-defined input numbers_
  will be translated to _user-defined input numbers_ in an alternate way.
  Thus, the number of logical buttons can be greater than the number of
  physical buttons in the _system_.

- **Battery level**: a synonym of _state of charge_.

- **Bite point**:
  a certain value of the _clutch_ where the simulated car
  begins to transfer torque from the engine to the wheels.

- **BLE**: Bluetooth Low Energy.

- **BOM**: Bill of materials (for _PCB_ manufacturing orders).

- **Button**: a momentary switch.

- **Clutch**: a joystick/gamepad axis that simulates the position
  of a clutch pedal.

- **Daemon**: a perpetual task that runs an infinite loop
  in a background thread.

- **Detent**: haptic user feedback in a rotary encoder.

- **DPAD** (or **Directional pad**):
  any hardware able to send "up", "down", "left" and "right" _input events_.
  For example: 4 push buttons arranged in a cross
  or a single lever that can move in two axis.

- **Firmware-defined input number**:
  an _Input number_ in the range [0,127] assigned to input hardware.

- **Frame**: a graphic that fills the whole display.

- **Frame server**:
  a perpetual task that computes _frames_
  and then shows them in a display, in quick succession.

- **Fuel gauge**:
  a chip able to compute the _state of charge_ accurately.

- **GERBER**:
  an open file format for the manufacturing of a _PCB_.

- **HID**:
  Human Interface Device.

- **HID reports**:
  data sent to a computer (or received from) using the standard HID protocol.

- **I2C**:
  inter-integrated circuit, an standard serial bus.

- **Input**:
  any hardware able to generate _input events_ caused by user interactions.
  For example: momentary switches and rotary encoders.

- **Input bitmap**:
  a 128-bit word where each bit represents the state of an input.
  An input bitmap with a single bit set to 1 may be used
  to identify a single input.

- **Input bitmask**:
  a 128-bit word that represents ignored inputs in a bitmap.

- **Input event**:
  any user action that the _system_ must be aware of.
  For example: the press or release of a momentary switch
  or the rotation of a single _detent_ in a rotary encoder.

- **Input hub**:
  a _subsystem_ that knows the state of every input at all times.

- **Input map**:
  The relationship between _firmware-defined input numbers_ and
  _user-defined input numbers_.

- **Input number**:
  a non-negative number assigned to a physical or logical button.

- **LED strip**:
  a circuit composed by _pixel drivers_ connected in series
  and having a single control wire.

- **LiPo** (battery):
  Lithium-polymer battery.

- **Notification**:
  a condition or state change the user should be aware of,
  thanks to the _UI_ (if available).

- **Paddle**:
  a momentary switch or a potentiometer shaped as a lever.

- **PCB**:
  printed circuit board.

- **PISO**:
  Parallel-In Serial-Out (shift register).

- **Pixel**:
  a small dot that emits light of any color.

- **Pixel control**:
  the ability to adjust the color of individual pixels and
  display them all at once.

- **Pixel driver**:
  a very small device having a control chip and three LEDs
  (red, green and blue).

- **Pixel format**:
  the way pixel color data is organized for serial transmission.

- **Polling loop**:
  a perpetual task that reads the state of some inputs
  and generates input events from state changes.

- **Power latch**:
  a circuit able to turn the _system_ on or off automatically.

- **Quantum**:
  talking about battery charge,
  a counter of voltage samples that falls into a certain range.

- **Routed input number**:
  A _firmware-defined input number_ consumed by the _system_ itself,
  so it can not be translated to a _user-defined input number_.

- **Subsystem**:
  a piece of the _system_ that provides a certain behavior
  by grouping related functions.

- **System**:
  the combination of hardware and software subject of this project.

- **State of charge (SOC)**:
  an estimation of available battery charge in the range from 0% to 100%.

- **Telemetry data**:
  collection of measurements or other data
  from a simulated vehicle on the host computer.

- **UI**: User Interface.

- **User-defined input number**:
  an _Input number_ in the range [0,127] assigned to a logical button
  (in a HID gamepad).
