afpineda/OpenSourceSimWheelESP32/doc/hardware/esp32reference/LilyGo T-QT pinout.jpg

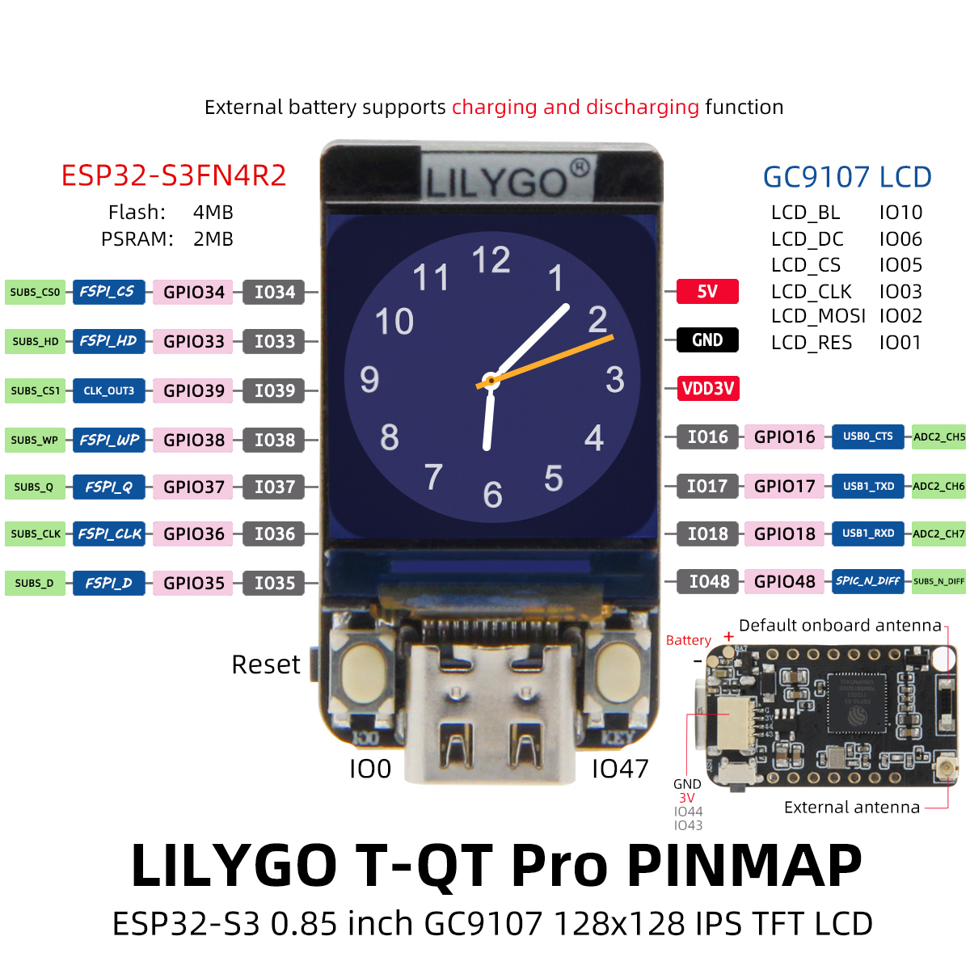
doc/hardware/esp32reference/LilyGo T-QT pinout.jpg
