afpineda/OpenSourceSimWheelESP32/doc/hardware/esp32reference/tinypico-pinout.jpg

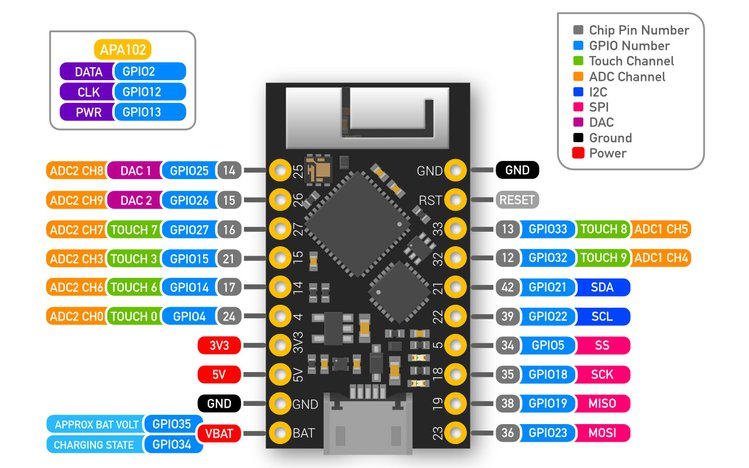
doc/hardware/esp32reference/tinypico-pinout.jpg
