afpineda/OpenSourceSimWheelESP32/doc/hardware/esp32reference/TOL-20680_v1_1_schema.png

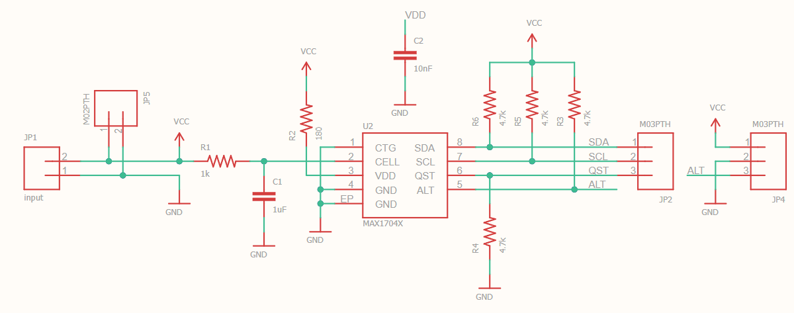
doc/hardware/esp32reference/TOL-20680_v1_1_schema.png
