afpineda/OpenSourceSimWheelESP32/doc/hardware/esp32reference/Wemos S3 Mini dimmensions.png

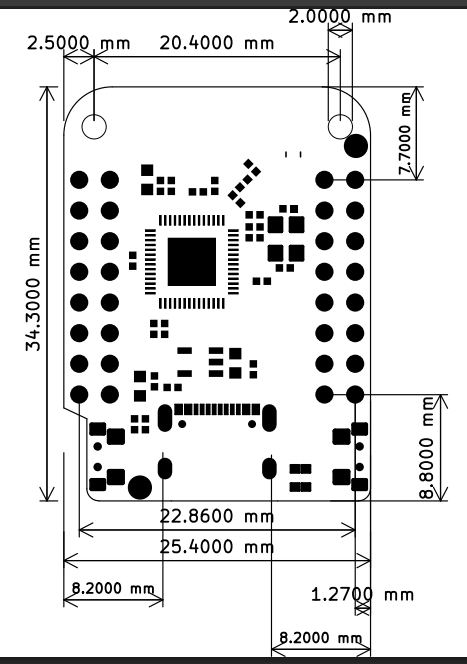
doc/hardware/esp32reference/Wemos S3 Mini dimmensions.png
