afpineda/OpenSourceSimWheelESP32/doc/hardware/esp32reference/Wemos S3 Mini pinout (v1_0_0_4).jpg

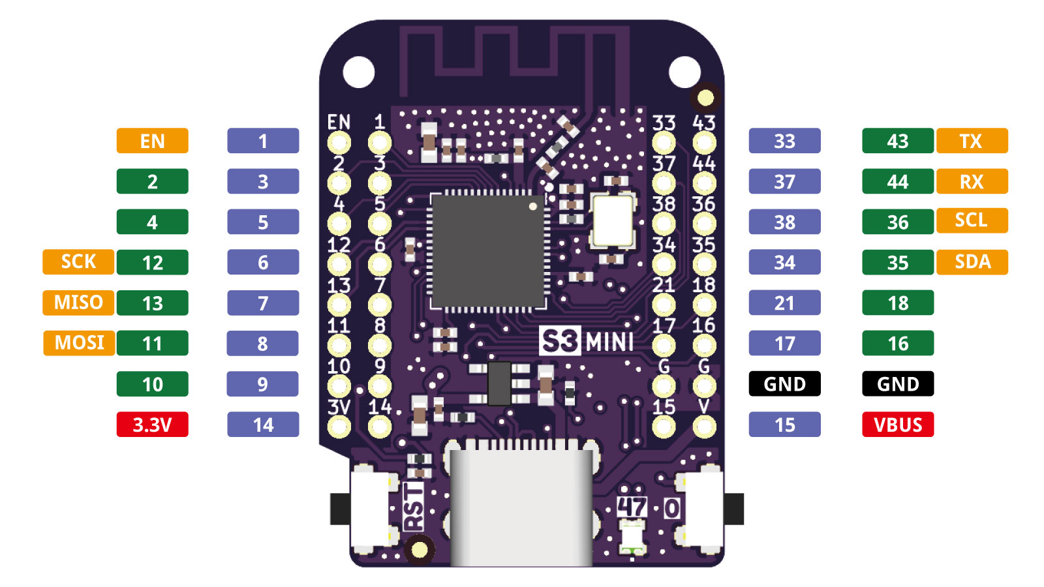
doc/hardware/esp32reference/Wemos S3 Mini pinout (v1_0_0_4).jpg
