afpineda/OpenSourceSimWheelESP32/doc/hardware/pictures/LevelShifterTransistors.png

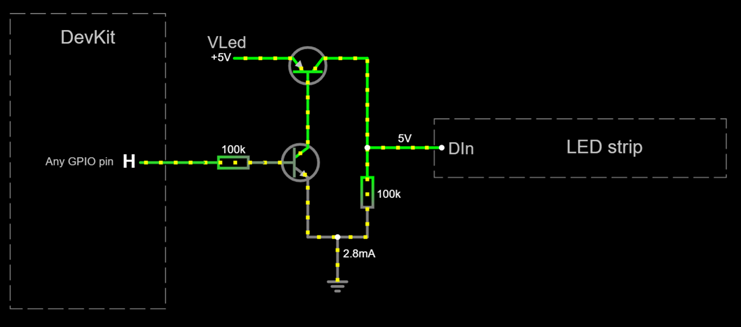
doc/hardware/pictures/LevelShifterTransistors.png
