afpineda/OpenSourceSimWheelESP32/doc/hardware/pictures/RKJXT1F4_mounting.png

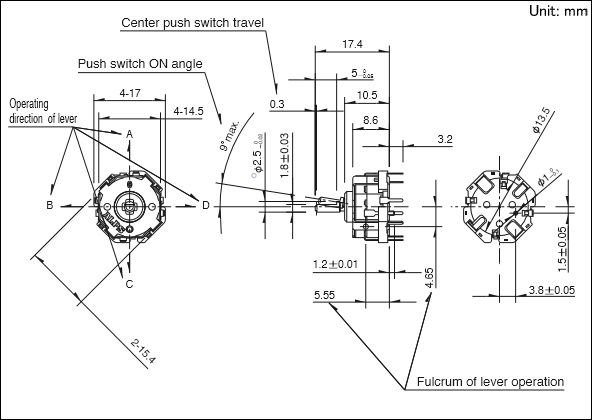
doc/hardware/pictures/RKJXT1F4_mounting.png
