afpineda/OpenSourceSimWheelESP32/doc/hardware/pictures/RKJXT1F4_terminals.png

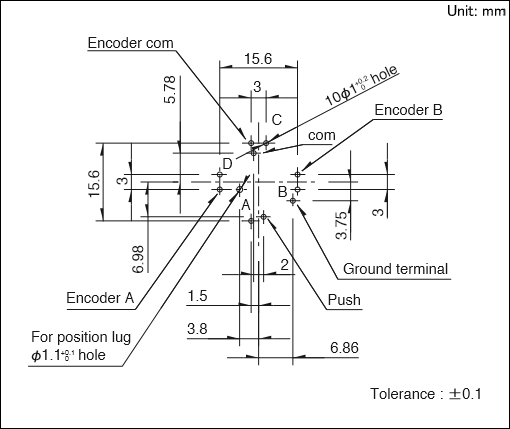
doc/hardware/pictures/RKJXT1F4_terminals.png
