afpineda/OpenSourceSimWheelESP32/doc/hardware/pictures/VDivider3buttons.png

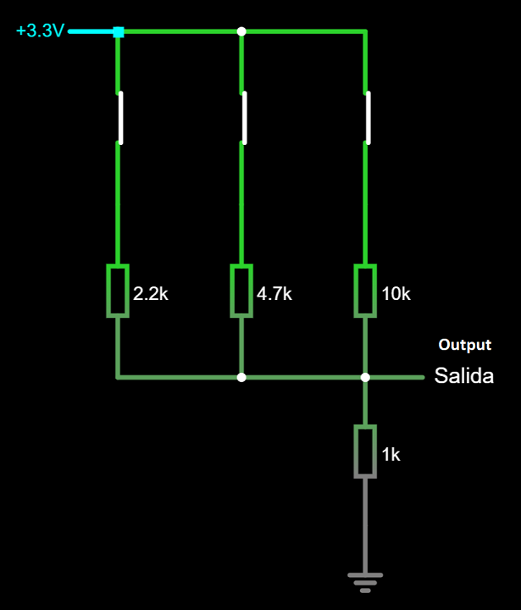
doc/hardware/pictures/VDivider3buttons.png
