afpineda/OpenSourceSimWheelESP32/doc/hardware/subsystems/PowerLatch/PowerLatch_circuit.png

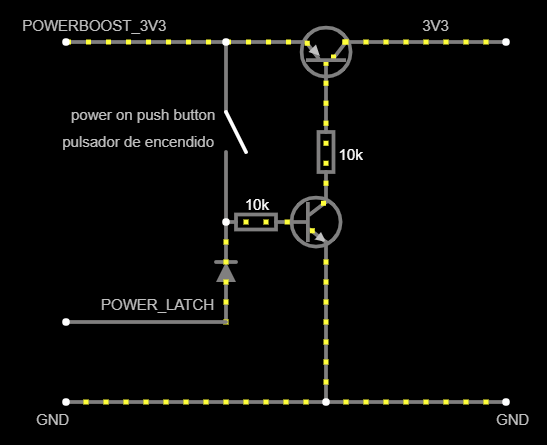
doc/hardware/subsystems/PowerLatch/PowerLatch_circuit.png
