afpineda/OpenSourceSimWheelESP32/doc/hardware/subsystems/PowerLatch/PowerLatch_diy.png

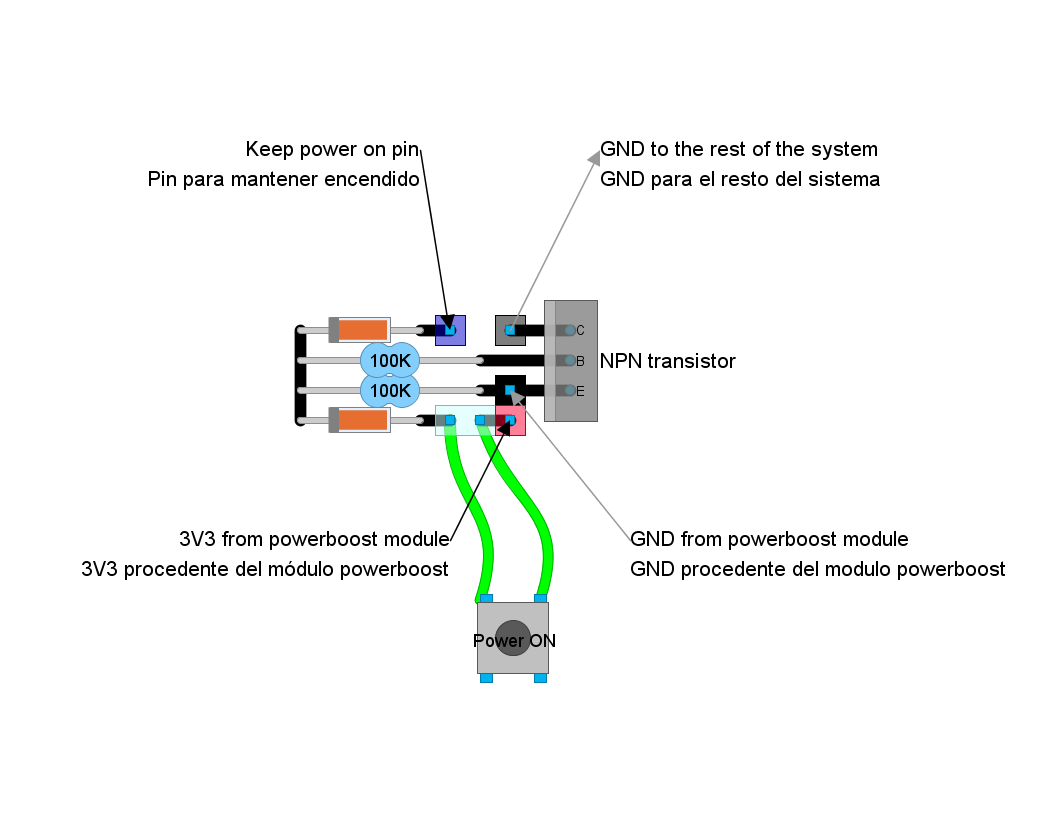
doc/hardware/subsystems/PowerLatch/PowerLatch_diy.png
