afpineda/OpenSourceSimWheelESP32/doc/hardware/subsystems/Switches/ShiftRegisterSimplified.png

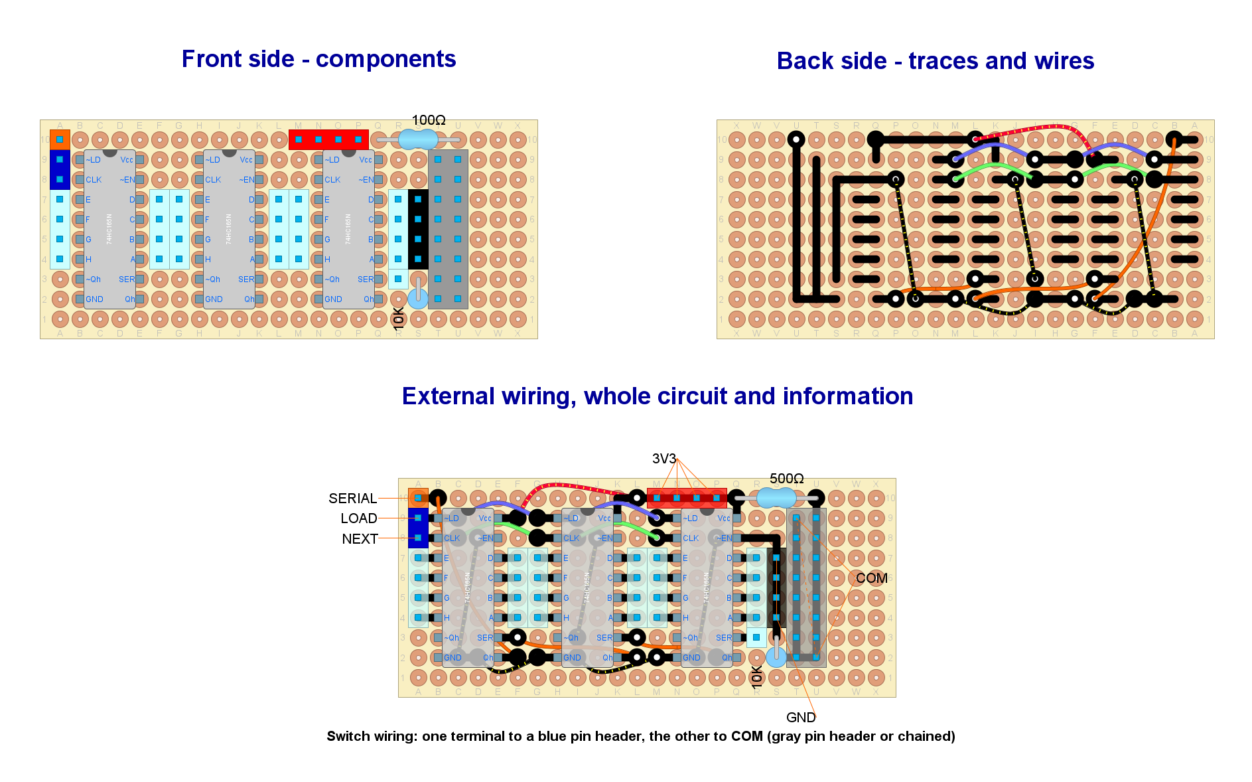
doc/hardware/subsystems/Switches/ShiftRegisterSimplified.png
