afpineda/OpenSourceSimWheelESP32/doc/pcb/CustomDevKit/CustomDevKit_3D.png

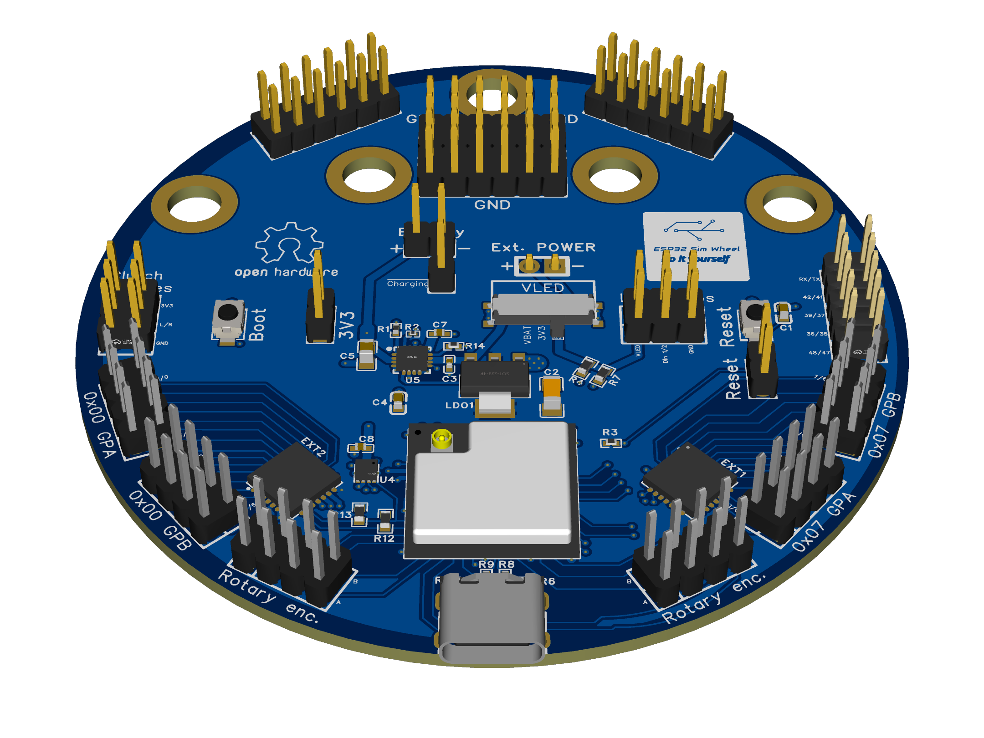
doc/pcb/CustomDevKit/CustomDevKit_3D.png
