afpineda/OpenSourceSimWheelESP32/doc/pcb/CustomDevKit/CustomDevKit_front.png

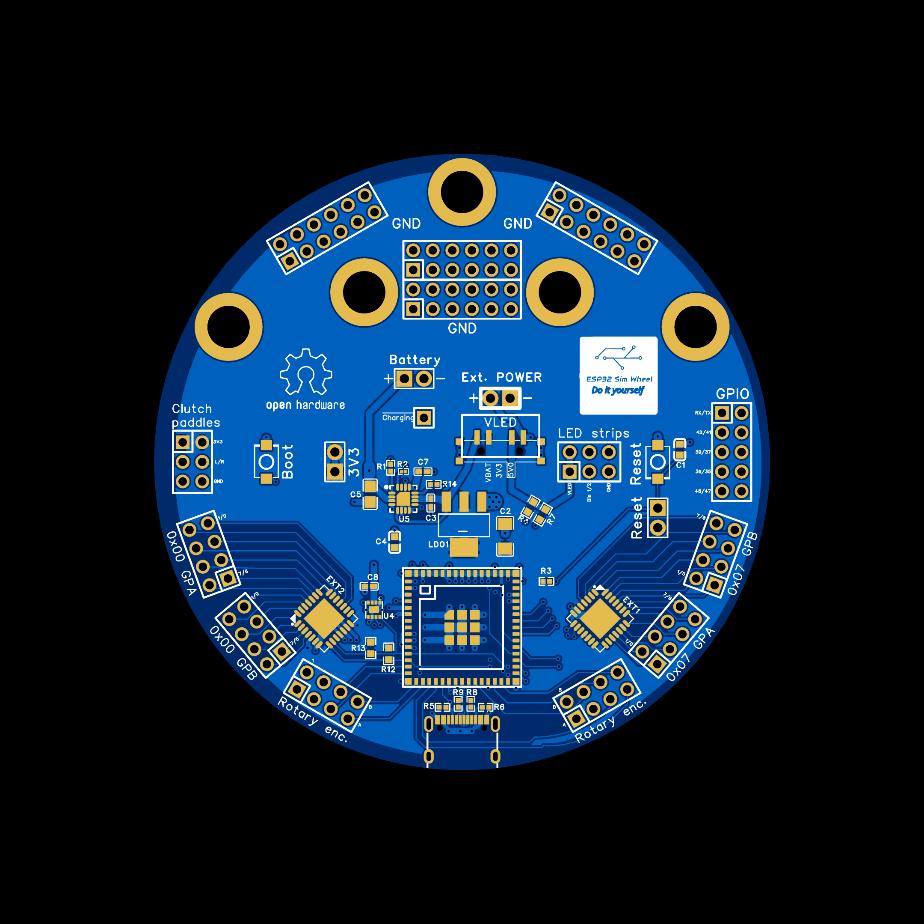
doc/pcb/CustomDevKit/CustomDevKit_front.png
