afpineda/OpenSourceSimWheelESP32/doc/pcb/Module24sw_TH/Module24Switches_TH_2025-front.png

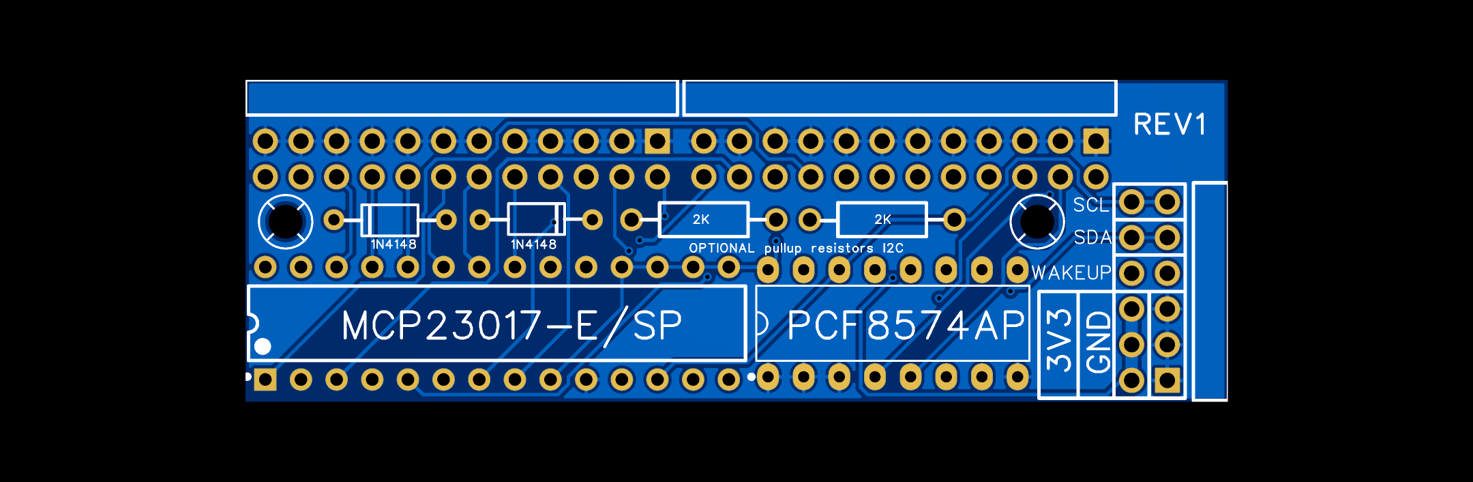
doc/pcb/Module24sw_TH/Module24Switches_TH_2025-front.png
