afpineda/OpenSourceSimWheelESP32/doc/pcb/ModuleBtnMatrix25sw/ModuleBtnMatrix25sw.jpg

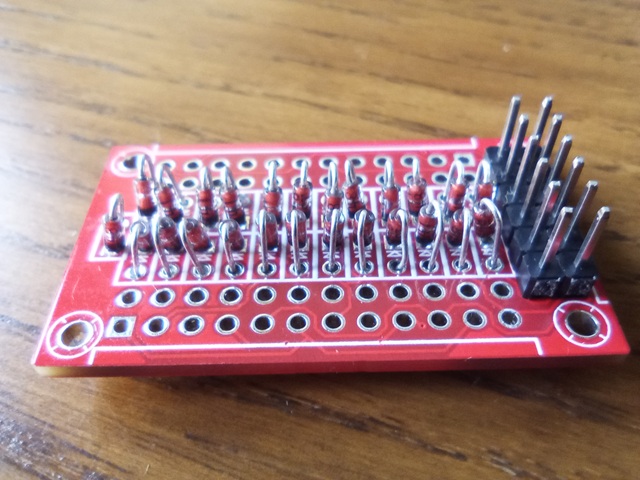
doc/pcb/ModuleBtnMatrix25sw/ModuleBtnMatrix25sw.jpg
