afpineda/OpenSourceSimWheelESP32/doc/pcb/CustomDevKit/CustomDevKit_BOM.csv

No. | Quantity | Comment | Designator | Footprint | Value | Manufacturer Part | Manufacturer | Supplier Part | Supplier | Primary Category | Secondary Category | Pin Count | Device | Name | Unique ID | Add into BOM
1 | 4 | PZ254V-11-02P | BATTH1,PWRH1,PWRH2,RESETH1 | HDR-TH_2P-P2.54-V-M |  | PZ254V-11-02P | XFCN(兴飞) | C492401 | LCSC |  |  | 2 | PZ254V-11-02P | PZ254V-11-02P | gge37,gge55,gge56,gge69_1 | no,yes
2 | 2 | 100nF | C1,C4 | C0603 | 100nF | CC0603KRX7R9BB104 | YAGEO(国巨) | C14663 | LCSC |  |  | 2 | CC0603KRX7R9BB104 | 100nF | gge7,gge26 | yes
3 | 1 | 10uF | C2 | C1206 | 10uF | CL31A106KBHNNNE | SAMSUNG(三星) | C13585 | LCSC |  |  | 2 | CL31A106KBHNNNE | 10uF | gge25 | yes
4 | 1 | 10uF | C3 | C0402 | 10uF | CL05A106MQ5NUNC | SAMSUNG(三星) | C15525 | LCSC |  |  | 2 | CL05A106MQ5NUNC | 10uF | gge24 | yes
5 | 1 | 4.7uF | C5 | C0805 | 4.7uF | CL21A475KAQNNNE | SAMSUNG(三星) | C1779 | LCSC |  |  | 2 | CL21A475KAQNNNE | 4.7uF | gge62_1 | yes
6 | 1 | 1uF | C7 | C0402 | 1uF | CL05A105KA5NQNC | SAMSUNG(三星) | C52923 | LCSC |  |  | 2 | CL05A105KA5NQNC | 1uF | gge64_4 | yes
7 | 1 | 100nF | C8 | C0402 | 100nF | CL05B104KO5NNNC | SAMSUNG(三星) | C1525 | LCSC |  |  | 2 | CL05B104KO5NNNC | 100nF | gge51_1 | yes
8 | 1 | PZ254V-11-01P | CHRGH1 | HDR-TH_1P-P2.54-V-M |  | PZ254V-11-01P | XFCN(兴飞) | C492400 | LCSC |  |  | 1 | PZ254V-11-01P | PZ254V-11-01P | gge68 | yes
9 | 2 | PZ254V-12-6P | CLH1,LEDH1 | HDR-TH_6P-P2.54-V-M-R2-C3-S2.54 |  | PZ254V-12-6P | XFCN(兴飞) | C492420 | LCSC |  |  | 6 | PZ254V-12-6P | PZ254V-12-6P | gge62,gge62_2 | no
10 | 2 | MCP23017T-E/ML | EXT1,EXT2 | QFN-28_L6.0-W6.0-P0.65-BL-EP3.7 |  | MCP23017T-E/ML | MICROCHIP(美国微芯) | C629439 | LCSC |  |  | 29 | MCP23017T-E/ML | MCP23017T-E/ML | gge1,gge1_1 | yes
11 | 4 | PZ254V-12-12P | GNDH1,GNDH2,GNDH3,GNDH4 | HDR-TH_12P-P2.54-V-M-R2-C6-S2.54 |  | PZ254V-12-12P | XFCN(兴飞) | C492423 | LCSC |  |  | 12 | PZ254V-12-12P | PZ254V-12-12P | gge64,gge64_1,gge64_2,gge64_3 | no
12 | 1 | PZ254V-12-10P | GPIOH1 | HDR-TH_10P-P2.54-V-M-R2-C5-S2.54 |  | PZ254V-12-10P | XFCN(兴飞) | C492422 | LCSC |  |  | 10 | PZ254V-12-10P | PZ254V-12-10P | gge63 | no
13 | 1 | AMS1117-3.3 | LDO1 | SOT-223-3_L6.5-W3.4-P2.30-LS7.0-BR |  | AMS1117-3.3 | AMS | C6186 | LCSC | Power Management (PMIC) | Voltage Regulators - Linear, Low Drop Out (LDO) Regulators | 4 | AMS1117-3.3_C6186 | AMS1117-3.3 | gge61_1 | yes
14 | 2 | 10kΩ | R1,R3 | R0402 | 10kΩ | 0402WGF1002TCE | UNI-ROYAL(厚声) | C25744 | LCSC |  |  | 2 | 0402WGF1002TCE | 10kΩ | gge6,gge66 | yes
15 | 1 | 3kΩ | R2 | R0201 | 3kΩ | 0201WMF3001TEE | UNI-ROYAL(厚声) | C473468 | LCSC |  |  | 2 | 0201WMF3001TEE | 3kΩ | gge67 | yes
16 | 2 | 1kΩ | R4,R7 | R0603 | 1kΩ | RC0603FR-071KL | YAGEO(国巨) | C22548 | LCSC |  |  | 2 | RC0603FR-071KL | 1kΩ | gge21,gge22 | yes
17 | 2 | 5.1kΩ | R5,R6 | R0402 | 5.1kΩ | 0402WGF5101TCE | UNI-ROYAL(厚声) | C25905 | LCSC |  |  | 2 | 0402WGF5101TCE | 5.1kΩ | gge12,gge13 | yes
18 | 2 | 23.2Ω | R8,R9 | R0402 | 23.2Ω | RC0402FR-0723R2L | YAGEO(国巨) | C477676 | LCSC | Resistors | Chip Resistor - Surface Mount | 2 | RC0402FR-0723R2L | 23.2Ω | gge59,gge60 | yes
19 | 2 | 3kΩ | R12,R13 | R0603 | 3kΩ | 0603WAF3001T5E | UNI-ROYAL(厚声) | C4211 | LCSC |  |  | 2 | 0603WAF3001T5E | 3kΩ | gge35_1,gge36_1 | yes
20 | 1 | 1.5kΩ | R14 | R0402 | 1.5kΩ | 0402WGF1501TCE | UNI-ROYAL(厚声) | C25867 | LCSC | Resistors | Chip Resistor - Surface Mount | 2 | 0402WGF1501TCE | 1.5kΩ | gge70 | yes
21 | 6 | PZ254V-12-8P | ROTH1,ROTH2,SWH1,SWH2,SWH3,SWH4 | HDR-TH_8P-P2.54-V-M-R2-C4-S2.54 |  | PZ254V-12-8P | XFCN(兴飞) | C492421 | LCSC |  |  | 8 | PZ254V-12-8P | PZ254V-12-8P | gge49,gge50,gge61,gge61_2,gge61_3,gge61_4 | no
22 | 2 | TS-1088-AR02016 | SW1,SW2 | SW-SMD_L3.9-W3.0-P4.45 |  | TS-1088-AR02016 | XUNPU(讯普) | C720477 | LCSC |  |  | 2 | TS-1088-AR02016 | TS-1088-AR02016 | gge10,gge10_1 | yes
23 | 1 | MSK13C02-SZ | SW3 | SW-SMD_MSK13C02-SZ |  | MSK13C02-SZ | SHOU HAN(首韩) | C2681569 | LCSC | Switches | Slide Switches | 8 | MSK13C02-SZ | MSK13C02-SZ | gge69 | yes
24 | 1 | 2.4GHz | U1 | BULETM-SMD_ESPRESSIF_ESP32-S3-MINI-1U-N8 | 2.4GHz | ESP32-S3-MINI-1U-N8 | ESPRESSIF(乐鑫) | C2980299 | LCSC | IoT/Communication Modules | WiFi Modules | 73 | ESP32-S3-MINI-1U-N8 | 2.4GHz | gge46 | yes
25 | 1 | MAX17048G+T10 | U4 | TDFN-8_L2.0-W2.0-P0.50-BL-EP1.2 |  | MAX17048G+T10 | ADI(亚德诺)/MAXIM(美信) | C2682616 | LCSC | Power Management (PMIC) | Battery Management | 9 | MAX17048G+T10 | MAX17048G+T10 | gge50_1 | yes
26 | 1 | BQ24074RGTR | U5 | QFN-16_L3.0-W3.0-P0.50-TL-EP1.7 |  | BQ24074RGTR | TI(德州仪器) | C54313 | LCSC | Power Management (PMIC) | Battery Management | 17 | BQ24074RGTR | BQ24074RGTR | gge65 | yes
27 | 1 | TYPE-C 16PIN 2MD(073) | USB1 | USB-C-SMD_TYPE-C-6PIN-2MD-073 |  | TYPE-C 16PIN 2MD(073) | SHOU HAN(首韩) | C2765186 | LCSC | Connectors | USB Connectors | 16 | TYPE-C 16PIN 2MD(073) | TYPE-C 16PIN 2MD(073) | gge11 | yes
