afpineda/OpenSourceSimWheelESP32/doc/pcb/Module24sw_TH/Module24Switches_TH_2025-BOM.csv

No. | Quantity | Comment | Designator | Footprint | Value | Manufacturer Part | Manufacturer | Supplier Part | Supplier | Primary Category | Secondary Category | Pin Count | Device | Name | Unique ID | Add into BOM
1 | 2 | 1N4148_C18195411 | D1,D2 | DO-35_BD2.2-L4.0-D0.50_1N4148 |  | 1N4148 | LJ(朗捷) | C18195411 | LCSC |  |  | 2 | 1N4148_C18195411 | 1N4148_C18195411 | gge2de22a2364db194e,gge2de22a2364db194e_1 | no
2 | 1 | 2541WR-2x06P | DEVKIT1 | HDR-TH_12P-P2.54-H-M-R2-C6-S2.54-N |  | 2541WR-2x06P | HanElectricity(瀚源) | C5383091 | LCSC | Connectors | Pin Headers | 12 | 2541WR-2x06P | 2541WR-2x06P | gge1 | yes
3 | 1 | MCP23017-E/SP | EXP1 | DIP-28_L34.6-W7.3-P2.54-LS10.2-BL |  | MCP23017-E/SP | MICROCHIP(美国微芯) | C647352 | LCSC |  |  | 28 | MCP23017-E/SP | MCP23017-E/SP | ggec41076a9bb7abb43 | no
4 | 1 | PCF8574AP | EXP2 | DIP-16_L19.2-W6.6-P2.54-LS7.6-BL |  | PCF8574AP | HGSEMI(华冠) | C398072 | LCSC |  |  | 16 | PCF8574AP | PCF8574AP | ggee06c0f04a39fd841 | no
5 | 2 | 2kΩ | PU1,PU2 | RES-TH_BD2.4-L6.3-P10.30-D0.6 | 2kΩ | RN1/4W2KFT/BA1 | Tyohm(幸亚电阻) | C410663 | LCSC |  |  | 2 | RN1/4W2KFT/BA1 | 2kΩ | ggefb3de6183458ea3f,ggefb3de6183458ea3f_1 | no
6 | 2 | Screw-Hole-M2 | SCREW1,SCREW2 | Screw-Hole-M2 |  |  |  |  |  |  |  | 1 | Screw-Hole-M2 |  | gge2,gge3 | no
7 | 2 | 2541WR-2x12P | SWHEADER1,SWHEADER2 | HDR-TH_24P-P2.54-H-M-R2-C12-S2.54-N |  | 2541WR-2x12P | HanElectricity(瀚源) | C5383094 | LCSC |  |  | 24 | 2541WR-2x12P | 2541WR-2x12P | ggee4a535c9ad6d6393,ggeefbeed70cd13a93e | no
