afpineda/OpenSourceSimWheelESP32/doc/pcb/ModulePlayAndCharge/ModulePlayAndCharge_BOM.csv

No. | Quantity | Comment | Designator | Footprint | Value | Manufacturer Part | Manufacturer | Supplier Part | Supplier | Primary Category | Secondary Category | Pin Count | Device | Name | Unique ID | Add into BOM
1 | 2 | PZ254R-11-02P | BATTH1,PWRH1 | HDR-TH_2P-P2.54-H-M-W10.4 |  | PZ254R-11-02P | XFCN(兴飞) | C492410 | LCSC | Connectors | Pin Headers | 2 | PZ254R-11-02P | PZ254R-11-02P | gge15,gge15_1 | no
2 | 2 | 10uF | C1,C3 | C0603 | 10uF | CL10A106MQ8NNNC | SAMSUNG(三星) | C1691 | LCSC |  |  | 2 | CL10A106MQ8NNNC | 10uF | gge44,gge47 | yes
3 | 1 | 4.7uF | C2 | C0402 | 4.7uF | CL05A475MP5NRNC | SAMSUNG(三星) | C23733 | LCSC |  |  | 2 | CL05A475MP5NRNC | 4.7uF | gge46 | yes
4 | 2 | 1uF | C4,C5 | C0603 | 1uF | CL10A105KB8NNNC | SAMSUNG(三星) | C15849 | LCSC |  |  | 2 | CL10A105KB8NNNC | 1uF | gge40,gge41 | yes
5 | 1 | 100nF | C7 | C0603 | 100nF | CC0603KRX7R9BB104 | YAGEO(国巨) | C14663 | LCSC |  |  | 2 | CC0603KRX7R9BB104 | 100nF | gge51_1 | yes
6 | 6 | PZ254R-12-8P | COMH1,IOH1,XH1,XH2,YH1,YH2 | HDR-TH_8P-P2.54-H-M-R2-C4-S2.54 |  | PZ254R-12-8P | XFCN(兴飞) | C492432 | LCSC | Connectors | Pin Headers | 8 | PZ254R-12-8P | PZ254R-12-8P | gge4,gge4_1,gge4_2,gge4_3,gge32_1,gge32_2 | yes
7 | 1 | BAT54A | D1 | SOT-23-3_L2.9-W1.3-P1.90-LS2.4-BR |  | BAT54A | TWGMC(台湾迪嘉) | C727124 | LCSC | Diodes | Schottky Diodes | 3 | BAT54A_C727124 | BAT54A | gge49 | yes
8 | 1 | MSK4010 | D2 | SOD-523_L1.2-W0.8-LS1.6-RD |  | MSK4010 | SHIKUES(时科) | C345958 | LCSC | Diodes | Schottky Diodes | 2 | MSK4010_C345958 | MSK4010 | gge45 | yes
9 | 2 | MCP23017T-E/ML | EXT1,EXT2 | QFN-28_L6.0-W6.0-P0.65-BL-EP3.7 |  | MCP23017T-E/ML | MICROCHIP(美国微芯) | C629439 | LCSC |  |  | 29 | MCP23017T-E/ML | MCP23017T-E/ML | gge1,gge1_1 | yes
10 | 1 | CJ3139K | Q1 | SOT-723_L1.2-W0.8-P0.40-LS1.2-BR |  | CJ3139K | CJ(江苏长电/长晶) | C70022 | LCSC | Transistors/Thyristors | MOSFETs | 3 | CJ3139K_C70022 | CJ3139K | gge42 | yes
11 | 2 | 100kΩ | R1,R3 | R0402 | 100kΩ | 0402WGF1003TCE | UNI-ROYAL(厚声) | C25741 | LCSC |  |  | 2 | 0402WGF1003TCE | 100kΩ | gge39,gge43 | yes
12 | 1 | 3kΩ | R2 | R0402 | 3kΩ | FRC0402F3001TS | FOJAN(富捷) | C2909355 | LCSC |  |  | 2 | FRC0402F3001TS | 3kΩ | gge48 | yes
13 | 2 | 10kΩ | R4,R5 | R0402 | 10kΩ | 0402WGF1002TCE | UNI-ROYAL(厚声) | C25744 | LCSC | Resistors | Chip Resistor - Surface Mount | 2 | 0402WGF1002TCE | 10kΩ | gge50,gge51 | yes
14 | 4 | Screw-Hole-M2 | SCREW1,SCREW2,SCREW3,SCREW4 | Screw-Hole-M2 |  |  |  |  |  |  |  | 1 | Screw-Hole-M2 |  | gge52,gge53,gge54,gge55 | no
15 | 1 | TP4054 | U2 | SOT-23-5_L2.9-W1.6-P0.95-LS2.8-BR |  | TP4054 | JSMSEMI(杰盛微) | C5381776 | LCSC | Power Management (PMIC) | Battery Management | 5 | TP4054_C5381776 | TP4054 | gge37 | yes
16 | 1 | NCP167BMX330TBG | U3 | XDFN-4_L1.0-W1.0-P0.65-BL-EP |  | NCP167BMX330TBG | onsemi(安森美) | C892227 | LCSC | Power Management (PMIC) | Voltage Regulators - Linear, Low Drop Out (LDO) Regulators | 5 | NCP167BMX330TBG | NCP167BMX330TBG | gge38 | yes
17 | 1 | MAX17048G+T10 | U4 | TDFN-8_L2.0-W2.0-P0.50-BL-EP1.2 |  | MAX17048G+T10 | ADI(亚德诺)/MAXIM(美信) | C2682616 | LCSC | Power Management (PMIC) | Battery Management | 9 | MAX17048G+T10 | MAX17048G+T10 | gge50_1 | yes
