afpineda/OpenSourceSimWheelESP32/doc/pcb/ModuleBtnMatrix25sw/ModuleBtnMatrix25sw_BOM.csv

No. | Quantity | Comment | Designator | Footprint | Value | Manufacturer Part | Manufacturer | Supplier Part | Supplier | Primary Category | Secondary Category | Pin Count | Device | Name | Unique ID | Add into BOM
1 | 25 | 1N4148 | D1,D14,D15,D16,D17,D18,D19,D20,D21,D22,D23,D24,D25,D26,D27,D28,D29,D30,D31,D32,D33,D34,D35,D36,D37 | DIODE_TH_2P |  | 1N4148 | LGE(鲁光) | C402212 | LCSC | Diodes | Switching Diodes | 2 | 1N4148_C402212 | 1N4148 | gge1,gge1_1,gge1_2,gge1_3,gge1_4,gge1_5,gge1_6,gge1_7,gge1_8,gge1_9,gge1_10,gge1_11,gge1_12,gge1_13,gge1_14,gge1_15,gge1_16,gge1_17,gge1_18,gge1_19,gge1_20,gge1_21,gge1_22,gge1_23,gge1_24 | no
2 | 4 | Screw-Hole-M2 | SCREW1,SCREW2,SCREW3,SCREW4 | Screw-Hole-M2 |  |  |  |  |  |  |  | 1 | Screw-Hole-M2 |  | gge5,gge6,gge6_1,gge7 | no
3 | 2 | 2541WR-2x12P | U1,U2 | HDR-TH_24P-P2.54-H-M-R2-C12-S2.54-N |  | 2541WR-2x12P | HanElectricity(瀚源) | C5383094 | LCSC | Connectors | Pin Headers | 24 | 2541WR-2x12P | 2541WR-2x12P | gge2,gge2_1 | no
4 | 1 | 2541WR-2x06P | U4 | HDR-TH_12P-P2.54-H-M-R2-C6-S2.54-N |  | 2541WR-2x06P | HanElectricity(瀚源) | C5383091 | LCSC | Connectors | Pin Headers | 12 | 2541WR-2x06P | 2541WR-2x06P | gge4 | no
