afpineda/OpenSourceSimWheelESP32/doc/pcb/Module32sw_TH/Module32Switches_TH_BOM.csv

No. | Quantity | Comment | Designator | Footprint | Value | Manufacturer Part | Manufacturer | Supplier Part | Supplier | Primary Category | Secondary Category | Pin Count | Device | Name | Unique ID | Add into BOM
1 | 2 | 1N4148_C18195411 | D1,D2 | DO-35_BD2.2-L4.0-D0.50_1N4148 |  | 1N4148 | LJ(朗捷) | C18195411 | LCSC |  |  | 2 | 1N4148_C18195411 | 1N4148_C18195411 | gge2de22a2364db194e,gge2de22a2364db194e_1 | no
2 | 2 | MCP23017-E/SP | EXP1,EXP2 | DIP-28_L34.6-W7.3-P2.54-LS10.2-BL |  | MCP23017-E/SP | MICROCHIP(美国微芯) | C647352 | LCSC |  |  | 28 | MCP23017-E/SP | MCP23017-E/SP | ggec41076a9bb7abb43,ggec41076a9bb7abb43_1 | no
3 | 6 | PZ254R-11-08P | H1,H2,H3,H4,H5,H6 | HDR-TH_8P-P2.54-H-M-W10.4 |  | PZ254R-11-08P | XFCN(兴飞) | C492416 | LCSC | Connectors | Pin Headers | 8 | PZ254R-11-08P | PZ254R-11-08P | gge1,gge1_1,gge1_2,gge1_3,gge1_4,gge1_5 | no
4 | 2 | Screw-Hole-M2 | SCREW1,SCREW2 | Screw-Hole-M2 |  |  |  |  |  |  |  | 1 | Screw-Hole-M2 |  | gge2,gge3 | no
