afpineda/OpenSourceSimWheelESP32/CD_CI/UnitTests/VoltageDividerMonitorTest/build.txt

VoltageDividerMonitorTest.cpp
batteryMonitor.cpp
BatteryMonitorHardware.cpp
HAL_dummy.cpp
