afpineda/OpenSourceSimWheelESP32/CD_CI/IntegrationTests/BatteryMonitorIntgTest/build.txt

BatteryMonitorIntgTest.cpp
BatteryMonitorHardware.cpp
batteryMonitor.cpp
HAL_dummy.cpp
