afpineda/OpenSourceSimWheelESP32/CD_CI/UnitTests/BatteryCalibrationTest/build.txt

BatteryCalibrationTest.cpp
batteryCalibration.cpp
