afpineda/OpenSourceSimWheelESP32/CD_CI/UnitTests/HidServiceTest/build.txt

HidServiceTest.cpp
hidCommon.cpp
hid_dummy.cpp
pixels_dummy.cpp
telemetry.cpp
