afpineda/OpenSourceSimWheelESP32/CD_CI/IntegrationTests/Report2Test/build.txt

Report2Test.cpp
hidCommon.cpp
hid_dummy.cpp
telemetry.cpp
pixels_dummy.cpp
