afpineda/OpenSourceSimWheelESP32/CD_CI/IntegrationTests/Report3Test/build.txt

Report3Test.cpp
hidCommon.cpp
hid_dummy.cpp
telemetry.cpp
pixels_dummy.cpp
