afpineda/OpenSourceSimWheelESP32/CD_CI/IntegrationTests/Report4Test/build.txt

Report4Test.cpp
hidCommon.cpp
hid_dummy.cpp
telemetry.cpp
pixels_dummy.cpp
