afpineda/OpenSourceSimWheelESP32/CD_CI/IntegrationTests/Report5Test/build.txt

Report5Test.cpp
hidCommon.cpp
hid_dummy.cpp
telemetry.cpp
pixels_dummy.cpp
