afpineda/OpenSourceSimWheelESP32/CD_CI/IntegrationTests/ReportPixelControlTest/build.txt

ReportPixelControlTest.cpp
pixels_fake.cpp
hidCommon.cpp
hid_dummy.cpp
telemetry.cpp
