afpineda/OpenSourceSimWheelESP32/CD_CI/IntegrationTests/ReportTelemetryTest/build.txt

ReportTelemetryTest.cpp
hidCommon.cpp
hid_dummy.cpp
telemetry.cpp
pixels_dummy.cpp
