afpineda/OpenSourceSimWheelESP32/CD_CI/IntegrationTests/StorageIntgTest/build.txt

StorageIntgTest.cpp
storage.cpp
Preferences_fake.cpp
