afpineda/OpenSourceSimWheelESP32/CD_CI/UnitTests/FakePreferencesTest/build.txt

FakePreferencesTest.cpp
Preferences_fake.cpp
