afpineda/OpenSourceSimWheelESP32/CD_CI/UnitTests/InputSubsystemUnitTest/build.txt

InputSubsystemUnitTest.cpp
inputs.cpp
HAL_dummy.cpp
