afpineda/OpenSourceSimWheelESP32/src/QualityControl/IntegrationTests/README.md

# Manual integration test strategy

Ensure that all unit test have failed before proceeding to integration testing
(*YES, they have to fail, since their purpose is to reveal bugs, but they don't*).

- This is an incremental, bottom-up strategy.
- Just the subsystems being integrated are listed.
  In **bold text** we highlight the subsystems being added
  to the previous tests.
- Since there are automated integration tests in the CD/CI chain,
  this integration strategy is not a step-by-step incremental one.

Run order:

```mermaid
flowchart LR
    DigitalInputsTest --> InputHubTest
    DigitalInputsTest --> GenericCodedSwitchTest
    PixelControlTest --> Proto2
    InputHubTest --> Proto1
    GenericCodedSwitchTest --> Proto1
    Proto1 --> Proto2
    TelemetryIntegrationTest --> Proto2
```

Render this graph at
[mermaid.live](https://mermaid.live/view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)

## *Test name*: [TelemetryIntegrationTest](./TelemetryIntegrationTest/README.md)

- hid (NimBLE)
- telemetry
- ui:
  - SimpleShiftLight
  - PCF8574RevLights
  - OledTelemetry128x64

## *Test name*: [DigitalInputsTest](./DigitalInputsTest/README.md)

- DigitalInput:
  - RotaryEncoderInput
  - ButtonMatrixInput
  - DigitalButton
- inputs

## *Test name*: [PixelControlTest](./PixelControlTest/PixelControlTest.ino)

- hid (NimBLE)
- pixels
- ui:
  - PixelControlNotification

## *Test name*: [InputHubTest](./InputHubTest/README.md)

- DigitalInput
- **AnalogInput**
- inputs
- **inputMap**
- **inputHub**

## *Test name*: [GenericCodedSwitchTest](./GenericCodedSwitchTest/README.md)

- inputs
- **inputHub**
  (only binary coded switches)

## *Test name*: [Proto1](./Proto1/README.md)

- DigitalInput:
  - RotaryEncoderInput
  - ButtonMatrixInput
  - DigitalButton
- AnalogInput:
  - AnalogClutchInput
- inputs
- inputHub
- **storage**
- **firmware**
- **hid (NimBLE)**

> [!NOTE]
> This is a working prototype

## *Test name*: [Proto2](./Proto2/README.md)

- DigitalPolledInput:
  - RotaryEncoderInput
  - ButtonMatrixInput
  - DigitalButton
- inputs
- storage
- inputHub
- inputMap
- hid (NimBLE)
- firmware
- **power**
- **batteryMonitor**
- **batteryCalibration**
- **telemetry**
- **ui**
- **pixels**

> [!NOTE]
> This is a system test
