afpineda/OpenSourceSimWheelESP32/src/QualityControl/UnitTests/InputHardware/AnalogMultiplexerTest/README.md

# Unit test: Input from analog multiplexers

## Purpose and summary

To test correct identification of events caused by analog multiplexers.

## Hardware setup

Use this [test circuit](../../../Protoboards/MainTestBoard.diy):

Test circuit image

- We are using the multiplexed switches only.
- We are using "buttons" numbered 20 to 24.
  Since there are no physical buttons,
  drive each pin to `GND` to simulate a closed switch.
  For later reference, "buttons" are named "D1" to "D4",
  no matter which bitmap is assigned to them.

## Procedure and expected output

### Part 1: mask

1. Reset. Ignore output from the operating system itself.

2. Output must match:

   ```text
   -- READY --
   -- GO --
   ```

3. Wait for 30 seconds or so. There must be no further output.

### Part 2: single button identification

1. Press and release each button one at a time.
   A single bit should be set for each pair of output lines.
   For example (not to be taken literally):

   ```text
   0000000000000000000000000000000000000000000100000000000000000000
   0000000000000000000000000000000000000000000000000000000000000000
   ```

2. Check that a different bit was set for every button press.
   For example (not to be taken literally):

   ```text
   0000000000000000000000000000000000000000000100000000000000000000
   0000000000000000000000000000000000000000000000000000000000000000
   0000000000000000000000000000000000000000001000000000000000000000
   0000000000000000000000000000000000000000000000000000000000000000
   0000000000000000000000000000000000000000010000000000000000000000
   0000000000000000000000000000000000000000000000000000000000000000
   0000000000000000000000000000000000000000100000000000000000000000
   0000000000000000000000000000000000000000000000000000000000000000
   ```

3. Repeat for each button:

   - hit and release the button in quick succession, many times.
   - Check that one bit and only one bit is set each time. This is ok.
   - Check that the same bit is set in all button presses. This is ok.

### Part 2: input identification from many buttons

1. Press and hold every button one at a time, from "D1" to "D4".
   At each step, check that the number of bits set to 1 equals the number of pressed buttons.
   Last output line must match:

   ```text
   0000000000000000000000000000000000000000111100000000000000000000
   ```

2. Release every button one at a time, from "D1" to "D4".
   At each step, check that the number of bits set to 1 equals the number of pressed buttons.
   Last output line must match:

   ```text
   0000000000000000000000000000000000000000000000000000000000000000
   ```
