afpineda/OpenSourceSimWheelESP32/src/QualityControl/UnitTests/InputHardware/I2CExpanderTest/README.md

# Unit test: Input from GPIO expanders

## Purpose and summary

To test correct identification of events caused by GPIO expanders.

## Hardware setup

Use the following [test circuit](../../../Protoboards/MainTestBoard.diy).
Just the GPIO expanders are used.

Test circuit image

This test circuit does not have micro-switches
attached to the GPIO expanders due to its excessive number.
Two wires will replace them.
For future reference, those wires are called "probe1" and "probe2".
You have to manually wire/unwire them to/from the requested pin to close/open the circuit.

## Procedure and expected output

### Part 1: mask

1. Reset. Ignore output from the operating system itself.

2. The latest line of output must match:

   ```text
   -- GO --
   ```

3. Wait for 30 seconds or so. There must be no further output.

### Part 2: single button identification

1. One at a time, wire and unwire "probe1" to one *PCF8574's* GPIO, in the following order:
   P0, P1, P2, P3, P4, P5, P6, P7. Output must match:

   ```text
   0000000000000000000000000000000001000000000000000000000000000000
   0000000000000000000000000000000000000000000000000000000000000000
   0000000000000000000000000000000010000000000000000000000000000000
   0000000000000000000000000000000000000000000000000000000000000000
   0000000000000000000000000000000100000000000000000000000000000000
   0000000000000000000000000000000000000000000000000000000000000000
   0000000000000000000000000000001000000000000000000000000000000000
   0000000000000000000000000000000000000000000000000000000000000000
   0000000000000000000000000000010000000000000000000000000000000000
   0000000000000000000000000000000000000000000000000000000000000000
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
   0000000000000000000000000010000001000000000000000000000000000000
   ```

4. Unwire both "probe1" and "probe2". Ignore output.
5. Wire "probe1" to P1 and "probe2" to GPA1. Last output line must show:

   ```text
   0000000000000000000000000000000010000000000000000000100000000000
   ```
