afpineda/OpenSourceSimWheelESP32/src/QualityControl/UnitTests/InputHardware/ShiftRegistersTest/README.md

# Unit test: Input from PISO shift registers

## Purpose and summary

To test correct identification of events caused by shift registers.

## Hardware setup

Use the following [satellite circuit](../../../Protoboards/SRTestBoard.diy):

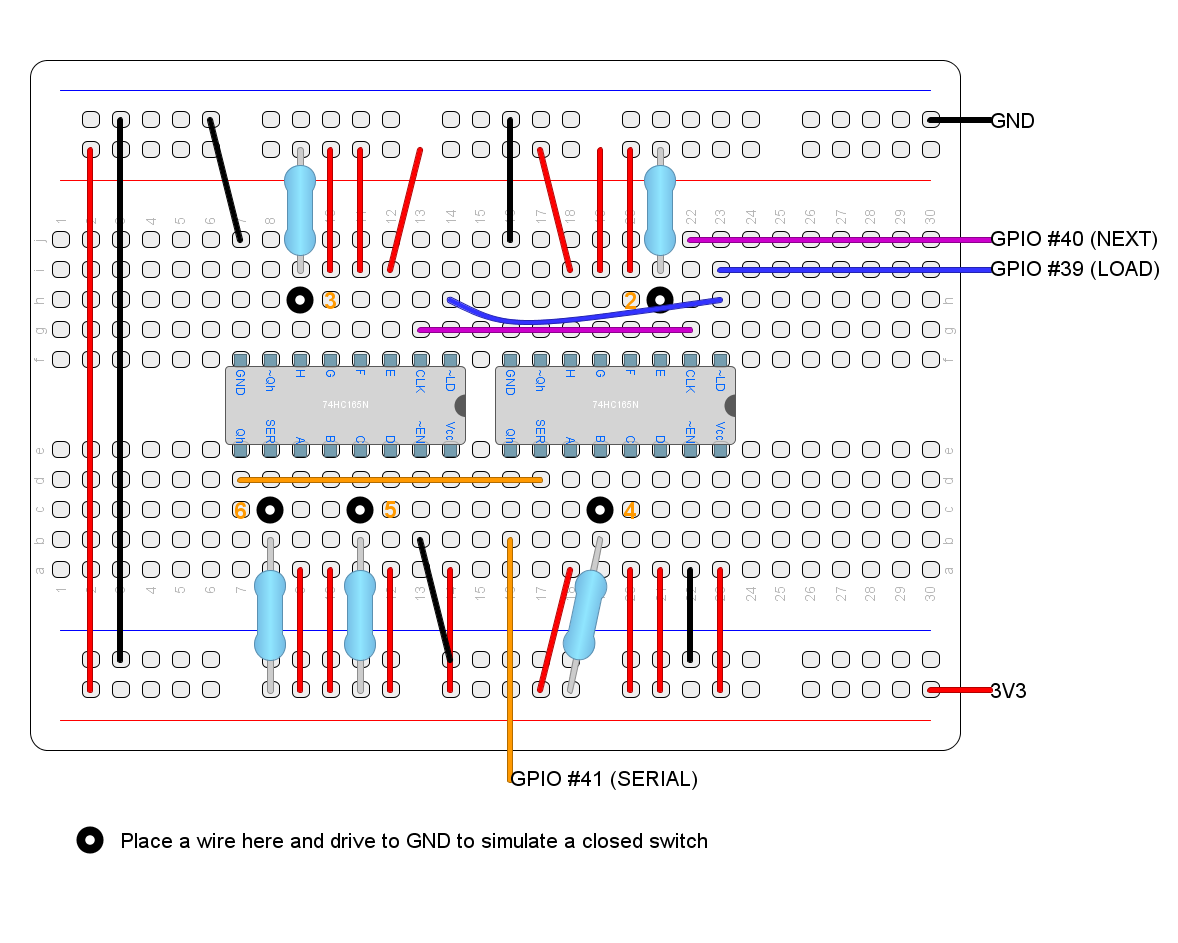
[picture p89: src/QualityControl/Protoboards/SRTestBoard.png]
Satellite circuit image


There are no physical buttons.
Just drive a wire to `GND` to simulate a closed switch.
For later reference, "buttons" are named "D1" to "D5",
no matter which bitmap is assigned to them.

## Procedure and expected output

### Part 1: mask

1. Reset. Ignore output from the operating system itself.

2. Output must match:

   ```text
   -- READY --
   -- GO --
   ```

3. Wait for 30 seconds or so. There must be no further output.

### Part 2: single button identification

1. Press and release each button one at a time.
   A single bit should be set for each pair of output lines.
   For example (not to be taken literally):

   ```text
   0000000000000000000000000000000000000000000000000000000000001000
   0000000000000000000000000000000000000000000000000000000000000000
   ```

2. Check that a different bit was set for every button press.
   For example (not to be taken literally):

   ```text
   0000000000000000000000000000000000000000000000000000000000000100
   0000000000000000000000000000000000000000000000000000000000000000
   0000000000000000000000000000000000000000000000000000000000001000
   0000000000000000000000000000000000000000000000000000000000000000
   0000000000000000000000000000000000000000000000000000000000010000
   0000000000000000000000000000000000000000000000000000000000000000
   0000000000000000000000000000000000000000000000000000000000100000
   0000000000000000000000000000000000000000000000000000000000000000
   0000000000000000000000000000000000000000000000000000000001000000
   0000000000000000000000000000000000000000000000000000000000000000
   ```

3. Repeat for each button:

   - Hit and release the button in quick succession, many times.
   - Check that one bit and only one bit is set each time. This is ok.
   - Check that the same bit is set in all button presses. This is ok.

### Part 2: input identification from many buttons

1. Press and hold every button one at a time, from "D1" to "D5".
   At each step, check that the number of bits set to 1 equals the number of pressed buttons.
   Last output line must match:

   ```text
   0000000000000000000000000000000000000000000000000000000001111100
   ```

2. Release every button one at a time, from "D1" to "D4".
   At each step, check that the number of bits set to 1 equals the number of pressed buttons.
   Last output line must match:

   ```text
   0000000000000000000000000000000000000000000000000000000000000000
   ```
