afpineda/OpenSourceSimWheelESP32/src/QualityControl/Protoboards/BatteryCalibrationData.txt

// ESP32
{ 0, 0, 0, 0, 0, 0, 0, 0, 0, 0, 0, 0, 0, 0, 3, 5, 35, 122, 103, 0, 0, 0, 0, 0, 0, 0, 0, 0, 0, 0, 0, 0 };
// ESP32-S3
{ 0, 0, 0, 0, 0, 0, 0, 0, 0, 0, 0, 0, 0, 1, 4, 9, 34, 117, 65, 0, 0, 0, 0, 0, 0, 0, 0, 0, 0, 0, 0, 0 };
// ESP32, 9600 mAh, 100K - 100K divider
{ 0, 0, 0, 0, 0, 0, 0, 0, 0, 0, 0, 0, 0, 0, 0, 152, 847, 2208, 1037, 0, 0, 0, 0, 0, 0, 0, 0, 0, 0, 0, 0, 0 };
