afpineda/OpenSourceSimWheelESP32/doc/firmware/LiPoBatteryCharacterization.ods

Sheet: Notes
Based on: Lipo Voltage Chart: Show the Relationship of Voltage and Capacity
https://blog.ampow.com/lipo-voltage-chart/

Sheet: 1S
Voltage chart |  | Theroetical reading | Approximation formula
milliVolts | Charge % | ADC 3.3V | Computed SOC | Error
4200 | 100 | 5213 | 100 | 0
4150 | 95 | 5151 | 94 | 1
4110 | 90 | 5101 | 89 | 1
4080 | 85 | 5064 | 85 | 0
4020 | 80 | 4990 | 78 | 2
3980 | 75 | 4940 | 73 | 2
3950 | 70 | 4903 | 70 | 0
3910 | 65 | 4853 | 65 | 0
3870 | 60 | 4803 | 60 | 0
3850 | 55 | 4779 | 55 | 0
3840 | 50 | 4766 | 52 | -2
3820 | 45 | 4741 | 46 | -1
3800 | 40 | 4717 | 41 | -1
3790 | 35 | 4704 | 38 | -3
3770 | 30 | 4679 | 32 | -2
3750 | 25 | 4655 | 27 | -2
3730 | 20 | 4630 | 21 | -1
3710 | 15 | 4605 | 16 | -1
3690 | 10 | 4580 | 10 | 0
3610 | 5 | 4481 | 8 | -3
3270 | 0 | 4059 | 0 | 0
Max ADC reading through voltage divider |  | 2600
Min ADC reading (computed) |  | 2024
Simulated ADC reading |  | 2440 | OK
 |  |  | SOC
Mapped ADC reading |  | 4892 | 69 |  | long map(long x, long in_min, long in_max, long out_min, long out_max) { return (x - in_min) * (out_max - out_min) / (in_max - in_min) + out_min; }
