afpineda/OpenSourceSimWheelESP32/(threads)

Thread 1 (2022-12-11):

None of the circuit designs will work with an external +5V power source (as of version 1.1.2)

afpineda, 2022-12-11:
**Describe the bug**

All circuit designs takes `GPIO #11` for `GND`, which is a mistake.
As a result, none of the circuits will work with an external +5V power source.

There is another related mistake: a capacitor is missing between `GND` and `5V` (or maybe `3V3`). This is required due to a current peak when turning radios on, which causes a reboot.

**To Reproduce**

This is a hardware design issue. Firmware is not affected.

**Expected behavior**

The board should boot up when powered from an external +5V power source.

**DevKit board:**

 - Manufacturer: Unknown, probably an Expressif's clone.
 - Model: ESP32-DevKitC-32UE
 - Revision (if any): Version 4

**Additional context**

A misleading printed tag in the devkit board led to this hardware bug.
Project version: 1.1.2

afpineda, 2022-12-11:
[**Workarround** (link to falstad.com)](https://falstad.com/circuit/circuitjs.html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)

Closed 2022-12-30.

Thread 2 (2023-09-08):

Power sleep states not supported by ESP32-C3

stuartlt, 2023-09-08:
**Describe the bug**
When using an ESP32-C3 (which works fine for setup1) the power states are not supported. This is similar to this issue (https://github.com/esphome/issues/issues/2575)

**To Reproduce**
Steps to reproduce the behavior:
1. Compile project (example Setup1) when using an ESP32-C3.

**Expected behavior**
Expect the code to support the C3 sleep states when selecting that as a target.

**Screenshots**
power.cpp: In function 'void power::begin(const gpio_num_t*, uint8_t, bool)':
power.cpp:62:7: error: 'rtc_gpio_deinit' was not declared in this scope
       rtc_gpio_deinit((gpio_num_t)p);
       ^~~~~~~~~~~~~~~
power.cpp:62:7: note: suggested alternative: 'rtc_gpio_mode_t'
       rtc_gpio_deinit((gpio_num_t)p);
       ^~~~~~~~~~~~~~~
       rtc_gpio_mode_t
power.cpp: In function 'void power::begin(gpio_num_t, bool)':
power.cpp:78:7: error: 'rtc_gpio_deinit' was not declared in this scope
       rtc_gpio_deinit((gpio_num_t)p);
       ^~~~~~~~~~~~~~~
power.cpp:78:7: note: suggested alternative: 'rtc_gpio_mode_t'
       rtc_gpio_deinit((gpio_num_t)p);
       ^~~~~~~~~~~~~~~
       rtc_gpio_mode_t
power.cpp: In function 'void enterDeepSleep()':
power.cpp:166:21: error: 'esp_sleep_enable_ext1_wakeup' was not declared in this scope
     ESP_ERROR_CHECK(esp_sleep_enable_ext1_wakeup(ext1_wakeup_sources, ext1_wakeup_mode));
esp_err.h:116:30: note: in definition of macro 'ESP_ERROR_CHECK'
         esp_err_t err_rc_ = (x);                                        \
                              ^
power.cpp:166:21: note: suggested alternative: 'esp_sleep_enable_wifi_wakeup'
     ESP_ERROR_CHECK(esp_sleep_enable_ext1_wakeup(ext1_wakeup_sources, ext1_wakeup_mode));
                     ^~~~~~~~~~~~~~~~~~~~~~~~~~~~
esp32\hardware\esp32\2.0.11/tools/sdk/esp32c3/include/esp_common/include/esp_err.h:116:30: note: in definition of macro 'ESP_ERROR_CHECK'
         esp_err_t err_rc_ = (x);                                        \

**DevKit board:**
 - Manufacturer: N/A
 - Model: ESP32-C3
 - Revision (if any): Super Mini

**Additional context**
I commented out the power sleep functions to bypass this, as I was hardwiring using USB. However anyone using battery or worried about power consumption will need to swap the sleep states to match those of the C3.

afpineda, 2023-09-24:
Sorry for the delay. I've been on holidays.
Will look into it, however, the issue seems related to the underlying ESP32 API. Maybe, I can provide a workaround, but not a complete solution.
Will take some time.

afpineda, 2023-09-26:
The file "power.cpp" has been updated (version 2.3.3) to make use of the different power management API that ESP32C3 boards exposes. However, I don't own an ESP32C3 devKit, so **the code can not be tested** right now.

The relevant test unit is "deepSleep.ino", but an slightly different test unit is needed, since the originial ESP32 devKit used for testing have a different pin-out.

If someone do the testing, please, leave a comment.

stuartlt, 2023-09-26:
Awesome thank you. I will test once my next esp32 c3 arrives, got 2 in the mail so should be within next week or so. Thanks for your help and great project.

afpineda, 2023-10-01:
If you switch to the _develpment_ branch, there is a new test unit for this: "DeepSleepTestESP32C3".

Note that you should not build your own firmware from this branch (except for that test unit). It won't work. I'm waiting for a bug fix in the [NimBLE-Arduino library](https://github.com/h2zero/NimBLE-Arduino).

Closed 2023-09-26.

Thread 3 (2023-11-05):

ESP32-Arduino BLE stack does not work after first pairing

afpineda, 2023-11-05:
**Describe the bug**
`BLECharacteristic::setValue()` and `notify()` does not seem to work except just after pairing. After reset or power-off, the hosting PC is not receiving any input report. This happens with the *ESP32-Arduino* BLE stack. *NimBLE* stack seems to work ok.

**To Reproduce**
Steps to reproduce the behavior:
1. Upload "ESPBLEImplTest.ino" to the ESP32 board.
2. Ensure the device is not paired nor connected.
3. Pair the device. Ensure it is connected.
4. Reset the device.

**Expected behavior**
Input should be shown at the joystick test app, as described in the test unit, but nothing happens.

**DevKit board:**
 - Manufacturer: Wemos
 - Model: Lolin 32 Lite

**Additional context**
Tested with ESP32 board package versions 2.0.6 and 2.0.11. Same behavior.

afpineda, 2023-11-05:
Everything points to a bug in the ESP32 package. **Workarrounds**:

1. Switch to the *NimBLE* stack, or
2. Unpair and pair every time (this is not very reasonable).

A regression test is being added to next project version.

afpineda, 2023-11-10:
This issue has been moved to the Arduino-ESP32 project:
[https://github.com/espressif/arduino-esp32/issues/8838](https://github.com/espressif/arduino-esp32/issues/8838)

Closed 2023-12-21.

Thread 4 (2023-12-15):

HELP: Funky Problem - Push buttom

FRS78, 2023-12-15:
Hi all,

I have implemented Setup1 in my steering wheel project and everything works correctly except for the funky switch (RKJXT1F).

The problem is that when I connect the push button pin it generates a conflict and the funky stops working and only the push function works (and that function activates two things, the push and the crosshead up).
If I don't connect the push button pin, the funky works correctly (except the push button).

I have checked everything and it is correct (same way that the original project), but it does not work on my PCB or on my PROTOBOARD.

Please, has anyone had this problem and knows how to solve it?

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

FRS78, 2023-12-15:
Added full screenshoot
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

janc18, 2023-12-16:
Hi @FRS78, What is your test circuit?
I just see an issue with the S1-AZUL, at the datasheet say that is  the common push pin, but you are taking like another switch.

FRS78, 2023-12-16:
Hi @janc18

I do not understand what you mean...

I have made a summary of how I have it connected. I think it is the same as the original project defines it.

If you see something strange, tell me because that may be the error and I won't see it.

Hope to solve this, because i expend so much time with this issue, jrjrjrjrjrjr

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

afpineda, 2023-12-19:
Hi, Fernando.

I will look into this issue as soon as I can, but it can take some time.
I have an ALPS enconder over here, so I can do some testing.

Don't discard a faulty hardware design, since *setup1* was not built for a full system test (just the firmware was tested).

afpineda, 2023-12-19:
Hello again, Fernando.

> I have been studying the topic and I already understand what you were referring to. It seems that the configuration in this funky switch the push button cannot be connected in any way that is an independent button... Can you confirm that this is the case???

I think there is a **big mistake** in the ALPS datasheet you posted before that is misleading you.

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

Try to swap `COM`  and `Push` terminals and tell us what happens.

janc18, 2023-12-19:
> I have been studying the topic and I already understand what you were referring to. It seems that the configuration in this funky switch the push button cannot be connected in any way that is an independent button... Can you confirm that this is the case???
>

Hi @FRS78, yeah, that was exactly what I was trying to explain.
I will give the documentation a read to find an alternative.

FRS78, 2023-12-20:
Hi @janc18 and @afpineda

Confirmed, if you connect the push pin to gpio22 and the com pin to gpio4 everything works correctly. What's more, I have verified that the rest of the buttons work correctly, including the ALT buttons.

What remains pending is:
Option 1: Document this change in the original schematic
Option 2: edit the code

FRS78, 2023-12-20:
Post-data (spanish)

Muchas gracias por vuestra colaboración @janc18 / @afpineda
Estaba atascado con esto y no veía la luz

Aprovecho para felicitaros por este proyecto porque es Super chulo, muy flexible y funcional
Una verdadera lástima no poder usar estas preciosas PCB´s que ya tengo hechas:

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

Lo que voy a hacer es editar mi PBC para tener la funcionalidad TOTAL del proyecto, por eso si se cambia el código por favor haced un post para reactualizar las PCB´s si hiciera falta (aunque lo más práctico es modificar el esquemático original del proyecto y fin del problema)

Saludos y muchas gracias por vuestra atención

janc18, 2023-12-20:
Hi @FRS78 and @afpineda.

If anyone has a problem in the future or needs help or feedback, don't hesitate to contact me. We have somewhat similar projects in the achievement of DIY equipment for simracing.

afpineda, 2023-12-21:
Hi.

> What remains pending is: Option 1: Document this change in the original schematic Option 2: edit the code

The mistake is at the ALPS datasheet. The code and the circuit design is not faulty, nor your printed PCB is. I feel sorry for you.
This is the second time a misleading tag is causing an issue.

Closed 2023-12-20.

Thread 7 (2024-03-11):

It is working with funky switch??

artayasa, 2024-03-11:
This is working with funky switch sir?? Because i have wheel with , 9 button, 3 encorder, 2 funkyswitch(RKJXT1F42001), 2 sifter, and 2 clutch with hall sensor sir, it posible to using ypur frimeware??

artayasa, 2024-03-12:
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

Thabk u, but i have 2 fubky switch sir, it posible when change the frinewarw?

Thread 9 (2024-07-12):

Rebooting with error GPIO isr service already installed

WallK, 2024-07-12:
I'm trying to flash unmodified Setup 3 to test stuff out
My devboard is rebooting constantly with the message in the serial console (see below)

**STR**
Upload Setup3.ino
Reboot devboard
Observe serial monitor

**ER**
Board boots

**AR**
Board reboots with an error

**DevKit board:**
 - Manufacturer: ¯\\_(ツ)_/¯
 - Model: ESP-WROOM-32

**Additional context**
```
Rebooting...
ets Jul 29 2019 12:21:46

rst:0xc (SW_CPU_RESET),boot:0x13 (SPI_FAST_FLASH_BOOT)
configsip: 0, SPIWP:0xee
clk_drv:0x00,q_drv:0x00,d_drv:0x00,cs0_drv:0x00,hd_drv:0x00,wp_drv:0x00
mode:DIO, clock div:1
load:0x3fff0030,len:1448
load:0x40078000,len:14844
ho 0 tail 12 room 4
load:0x40080400,len:4
load:0x40080404,len:3356
entry 0x4008059c
E (15) gpio: gpio_install_isr_service(500): GPIO isr service already installed

abort() was called at PC 0x400d4a9a on core 1

Backtrace: 0x400827f5:0x3ffcab60 0x40094af5:0x3ffcab80 0x4009a3a1:0x3ffcaba0 0x400d4a9a:0x3ffcac20 0x400d4b73:0x3ffcac60 0x400d3b99:0x3ffcac90 0x400e6fff:0x3ffcacf0 0x4009754a:0x3ffcad10

ELF file SHA256: 0fef65b79bfd720a

Rebooting...

```

WallK, 2024-07-12:
I had debug set to error, but yeah, should've been on verbose, sorry

I'm not trying to use it as is with my dev board, I wanted to flash something known working to play with my buttons, see how bluetooth works and what is the current consumption
I plan to build my version with the building blocks you provided as you've described in documentation
Ideally, I would get some T7 S3 lilygo board or similar, with battery management onboard

Thanks!

Thread 11 (2024-08-04):

NimBLEDevice.h Missing

darkgeggio, 2024-08-04:
**Describe the bug**

Running the "Verify" of the Arduino IDE (after running MakeSymLinks.ps1 with administrator permissions), returns the following error:

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

**To Reproduce**
Steps to reproduce the behavior:
1. Go to 'Arduino IDE'
2. Click on 'any *.ino'
3. Run "Verify"
4. See error

**Expected behavior**
Verification performed successfully

**DevKit board:**
 - Manufacturer: NA
 - Model: ESP32-C3; ESP32WROOM32
 - Revision (if any):

**Additional context**
I ran MakeSymLinks.ps1 with administrator permissions and I didn't make any changes to the setups in the "MAIN" branch. I tried to put the file in "includes.txt" and searched both through Windows Explorer and through github for the name of the file but it seems to be not present.

Closed 2024-08-05.

Thread 22 (2025-01-02):

Shifter Register implementation doesn't work with esp32-wroom-32

AyrtonRicardo, 2025-01-02:
## Description

Trying to compile the firmware using shifter register with esp32-wroom, unfortunately I get boot loop with the error below.

Side note: Where can I get a "buy me a coffee" link to contribute to your amazing work in this project, REALLY incredible.

### Context

*Note: this information is very relevant.*

- **Project version**: *(version [master](https://github.com/afpineda/OpenSourceSimWheelESP32/commit/38890f5c218a7e084119e02f8a389fb4e572e33a)
  of this project where the bug was found, for example, 5.0.0).*

- **Host operating system/version**: *Windows 11*
- **Arduino IDE version**: *2.3.4*
- **ESP-Arduino version**: *3.0.7* > also tried *2.0.17*
- **h2zero/NimBLE version**: *2.1.0*

### DevKit board

- **Manufacturer**: *AZ Delivery*
- **Model**: *esp32-wroom-32*
- **Hardware Revision**: *(if any)*

## Behavior

### Expected

esp32 boots up

### Actual

* Boot loop without starting.
* I already tried many others sketch and they work, handling the shifter register 74HC165N with 32 buttons.

## Sample code

```c++
#include <Arduino.h>
#include "SimWheel.h"

std::string DEVICE_NAME = "ButtonBox OpenSimWheelESP32";
std::string DEVICE_MANUFACTURER = "Mamandurrio";

void simWheelSetup()
{
    //const gpio_num_t serialPin, -> SERIAL
    //const gpio_num_t loadPin, -> DATA
    //const gpio_num_t nextPin, -> CLK
    //const uint8_t switchCount) -> count
    inputs::addShiftRegisters(GPIO_NUM_25, GPIO_NUM_33, GPIO_NUM_34, 32)
        //
        .inputNumber(0, sr8_pin_t::A, 9)
        .inputNumber(0, sr8_pin_t::B, 10)
        .inputNumber(0, sr8_pin_t::C, 15)
        .inputNumber(0, sr8_pin_t::D, 16)
        .inputNumber(0, sr8_pin_t::E, JOY_RB)
        .inputNumber(0, sr8_pin_t::F, 8)
        .inputNumber(0, sr8_pin_t::G, JOY_A)
        .inputNumber(0, sr8_pin_t::H, JOY_LB)
        //
        .inputNumber(1, sr8_pin_t::A, 11)
        .inputNumber(1, sr8_pin_t::B, 12)
        .inputNumber(1, sr8_pin_t::C, 13)
        .inputNumber(1, sr8_pin_t::D, 14)
        .inputNumber(1, sr8_pin_t::E, JOY_BACK)
        .inputNumber(1, sr8_pin_t::F, JOY_Y)
        .inputNumber(1, sr8_pin_t::G, JOY_X)
        .inputNumber(1, sr8_pin_t::H, JOY_B)
        //
        .inputNumber(2, sr8_pin_t::A, 17)
        .inputNumber(2, sr8_pin_t::B, 18)
        .inputNumber(2, sr8_pin_t::C, 24)
        .inputNumber(2, sr8_pin_t::D, JOY_START)
        .inputNumber(2, sr8_pin_t::E, 22)
        .inputNumber(2, sr8_pin_t::F, 21)
        .inputNumber(2, sr8_pin_t::G, 20)
        .inputNumber(2, sr8_pin_t::H, 19)
        //
        .inputNumber(3, sr8_pin_t::A, 23)
        .inputNumber(3, sr8_pin_t::B, 25)
        .inputNumber(3, sr8_pin_t::C, 26)
        .inputNumber(3, sr8_pin_t::D, 27)
        .inputNumber(3, sr8_pin_t::E, 28)
        .inputNumber(3, sr8_pin_t::F, 29)
        .inputNumber(3, sr8_pin_t::G, 30)
        .inputNumber(3, sr8_pin_t::H, 31)
        .inputNumber(3, sr8_pin_t::SER, 32);
}

void setup()
{
    esp_log_level_set("*", ESP_LOG_VERBOSE);
    simWheelSetup();
    //userSettings::begin();
    hidImplementation::begin(
        DEVICE_NAME,
        DEVICE_MANUFACTURER,
        false);
    inputs::start();
}

void loop()
{
    vTaskDelay(portMAX_DELAY);
}
```

Error
```
17:01:03.716 -> ELF file SHA256: f78d5d918653f872
17:01:03.716 ->
17:01:03.795 -> Rebooting...
17:01:03.795 -> ets Jul 29 2019 12:21:46
17:01:03.795 ->
17:01:03.795 -> rst:0xc (SW_CPU_RESET),boot:0x13 (SPI_FAST_FLASH_BOOT)
17:01:03.839 -> configsip: 0, SPIWP:0xee
17:01:03.839 -> clk_drv:0x00,q_drv:0x00,d_drv:0x00,cs0_drv:0x00,hd_drv:0x00,wp_drv:0x00
17:01:03.839 -> mode:DIO, clock div:1
17:01:03.839 -> load:0x3fff0030,len:4832
17:01:03.839 -> load:0x40078000,len:16460
17:01:03.839 -> load:0x40080400,len:4
17:01:03.839 -> load:0x40080404,len:3504
17:01:03.839 -> entry 0x400805cc
17:01:04.055 ->
17:01:04.055 -> abort() was called at PC 0x400d30a8 on core 1
17:01:04.055 ->
17:01:04.055 ->
17:01:04.055 -> Backtrace: 0x40082469:0x3ffc86c0 0x40093b55:0x3ffc86e0 0x40098e21:0x3ffc8700 0x400d30a8:0x3ffc8780 0x400d3332:0x3ffc87c0 0x400d2ec2:0x3ffc87f0 0x400d20ff:0x3ffc8830 0x400d2337:0x3ffc8850 0x400e63ba:0x3ffc88b0 0x4009622e:0x3ffc88d0
17:01:04.100 ->
```

AyrtonRicardo, 2025-01-02:
Found out that Arduino IDE now has option to add verbose output, I found the reason was "sr8_pin_t::SER" could not be used, therefore I had to use `sr8_pin_t::H` instead.

However no matter which sketch I run from this project, I'm not able to connect via bluetooth, it always leads to "try connecting your device again" error on windows, and there is no error at all in the serial port, nor I could find any way to investigate errors on this sort of authentication via callback.

AyrtonRicardo, 2025-01-05:
@afpineda thank you for fixing the bug, the fix I did was the same as you, I was going to create a PR after working for me, but thanks for being quicker :D

Sorry to waste soooo much time, I found the reason.... The box for my mobo, the website I ordered it, everything was telling me I had a "intel" wifi/bt card, but in reality, I have Realtek 🤦 🤦 🤦 🤦 🤦 , so my driver in windows was completely broken, using default windows. After installing the driver, I also had to tweak and remove some stuff that was conflicting too.

I was able to connect after fix my drivers and the fixes done by you, also  worked completely fine.

> This project works with the same NimBLE-Arduino version as BLE-Gamepad.

Yep, I was also no able to identify any difference, just mentioned that to see if you had another idea why one worked and the other didn't. Even tho the problem was my driver, I have absolutely no clue how gamepad worked.

Current setup:
- NimBLE
- 32 buttons via shifter register
- ESP32-wroom-32

I will submit my setup after I finish the assemble and try out in some games.

Current issue: After I power off the device, I'm not able to connect it again with any device(android nor win nor mac), it seems the device gets "locked" somehow, after recompiling the firmware it's able to reconnect.

Steps:
- compile the firmware
- connect to windows
- power off
- power on
- nothing happens not even serial port displays anything

Serial port has no output at all, no lights blinking.
Pressing reset, does only output weird characters in the serial port, but nothing really works.

While writing this I found out that holding reset long enough makes the device reset and reconnect. Should I consider this a issue? Or was it already known by you?

AyrtonRicardo, 2025-01-05:
> Try a USB charger as power supply (since the computer is not involved in that case).

I did, and it was the same, but after some minutes of power off, I cannot reproduce it anymore. So I consider as working now, I bet my coins in what you mentioned, somehow the gpio0 was pulled down.

So far so great.

Once again, thanks for the support and many thanks for the project, it's really what I wanted to do, and incredible docs as well.

Mustafsjamal, 2025-01-12:
Sent from my iPhoneOn 5 Jan 2025, at 17:17, Ayrton Ricardo ***@***.***> wrote:
@afpineda thank you for fixing the bug, the fix I did was the same as you, I was going to create a PR after working for me, but thanks for being quicker :D
Sorry to waste soooo much time, I found the reason.... The box for my mobo, the website I ordered it, everything was telling me I had a "intel" wifi/bt card, but in reality, I have Realtek 🤦 🤦 🤦 🤦 🤦 , so my driver in windows was completely broken, using default windows. After installing the driver, I also had to tweak and remove some stuff that was conflicting too.
I was able to connect after fix my drivers and the fixes done by you, also  worked completely fine.

This project works with the same NimBLE-Arduino version as BLE-Gamepad.

Yep, I was also no able to identify any difference, just mentioned that to see if you had another idea why one worked and the other didn't. Even tho the problem was my driver, I have absolutely no clue how gamepad worked.
Current setup:

NimBLE
32 buttons via shifter register
ESP32-wroom-32

I will submit my setup after I finish the assemble and try out in some games.
Current issue: After I power off the device, I'm not able to connect it again with any device(android nor win nor mac), it seems the device gets "locked" somehow, after recompiling the firmware it's able to reconnect.
Steps:

compile the firmware
connect to windows
power off
power on
nothing happens not even serial port displays anything

Serial port has no output at all, no lights blinking.
Pressing reset, does only output weird characters in the serial port, but nothing really works.
While writing this I found out that holding reset long enough makes the device reset and reconnect. Should I consider this a issue? Or was it already known by you?

—Reply to this email directly, view it on GitHub, or unsubscribe.You are receiving this because you are subscribed to this thread.Message ID: ***@***.***>

Thread 23 (2025-01-31):

ESP32C3 - adcTools compile error with

stuartlt, 2025-01-31:
## Description

Compiling with ESP32C3 results in the following compilation errors:

adcTools.cpp:34:47: error: 'ADC_RTC_CLK_SRC_DEFAULT' is not a member of 'adc_oneshot_clk_src_t' {aka 'soc_periph_adc_digi_clk_src_t'}
   34 |             .clk_src = adc_oneshot_clk_src_t::ADC_RTC_CLK_SRC_DEFAULT,
      |                                               ^~~~~~~~~~~~~~~~~~~~~~~

### Context

*Note: this information is very relevant.*

- **Project version**: [6.11.1](https://github.com/afpineda/OpenSourceSimWheelESP32/tree/6.11.1)

- **Host operating system/version**: Windows 11
- **Arduino IDE version**: Version: 2.2.1
Date: 2023-08-31T14:35:44.802Z
CLI Version: 0.34.0
- **ESP-Arduino version**: 3.1.1
- **h2zero/NimBLE version**: 2.2.0

### DevKit board

ESP32C3

## Behavior

### Expected

Expect successful compilation based on the DevBoard being selected in the compiler.

### Actual

Error as described above.

## Sample code

Currently testing with the following changes:

    adc_oneshot_unit_init_cfg_t unitCfg =
        {
            .unit_id = adc_unit,
            #ifndef CONFIG_IDF_TARGET_ESP32C3
              .clk_src = adc_oneshot_clk_src_t::ADC_RTC_CLK_SRC_DEFAULT,
            #endif
            .ulp_mode = ADC_ULP_MODE_DISABLE,
        };

stuartlt, 2025-01-31:
Can confirm it works. Thanks for super quick application & great work on the project overall.
