afpineda/OpenSourceSimWheelESP32/doc/pcb/CustomDevKit/CustomDevKit_schematic.pdf

IO36 32 IO37 33 IO38 34 IO39 35 IO40 36 IO41 37 IO42 38 TXD0 39 RXD0 40 IO45 41 GND 42 GND 43 IO46 44 EN 45 GND 46 GND 47 GND 48 GND 49 GND 50 GND 51 GND 52 GND 53 GND 54 GND 55 GND 56 GND 57 GND 58 GND 59 GND 60 GND 61 GND 62 GND 63 GND 64 GND 65

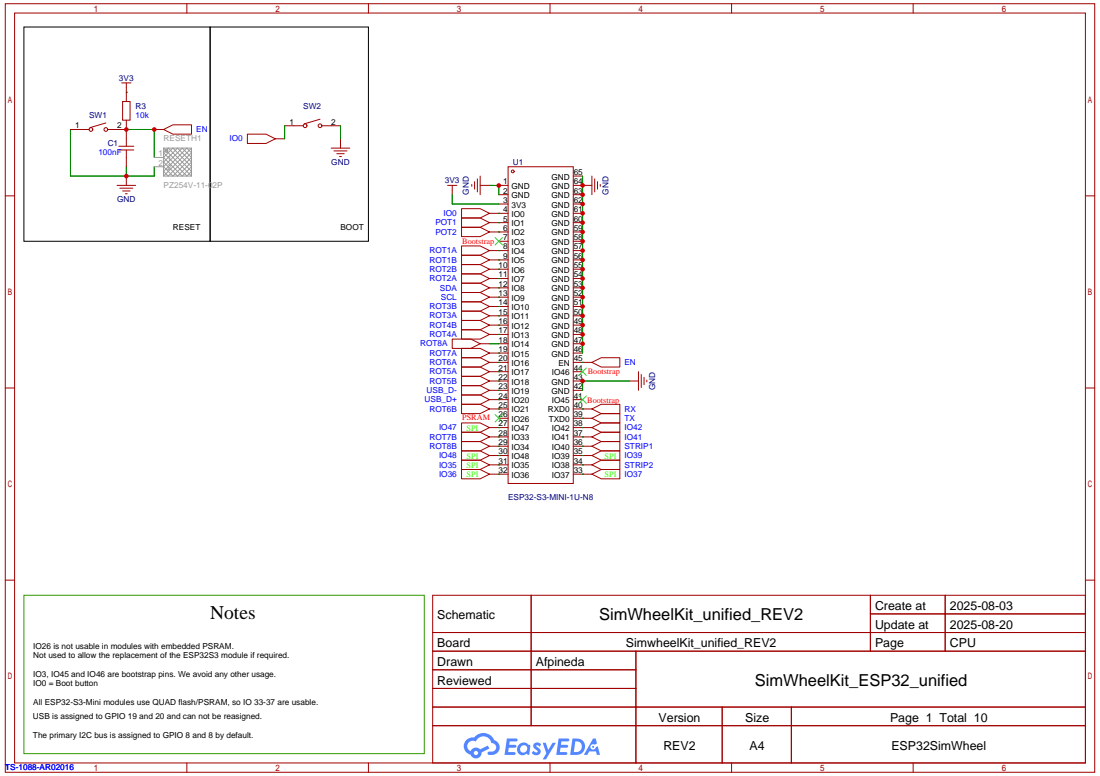
[picture p90: page 1]

Schematic | SimWheelKit_unified_REV2 | Create at | 2025-08-03

Update at | 2025-08-20

IO26 is not usable in modules with embedded PSRAM.
Not used to allow the replacement of the ESP32S3 module if required.
IO3, IO45 and IO46 are bootstrap pins. We avoid any other usage.
IO0 = Boot button
All ESP32-S3-Mini modules use QUAD flash/PSRAM, so IO 33-37 are usable.
USB is assigned to GPIO 19 and 20 and can not be reasigned.
The primary I2C bus is assigned to GPIO 8 and 8 by default.

Board | SimwheelKit_unified_REV2 | Page | CPU
Drawn | Afpineda | SimWheelKit_ESP32_unified
Reviewed

Version | Size | Page 1 Total 10
REV2 | A4 | ESP32SimWheel

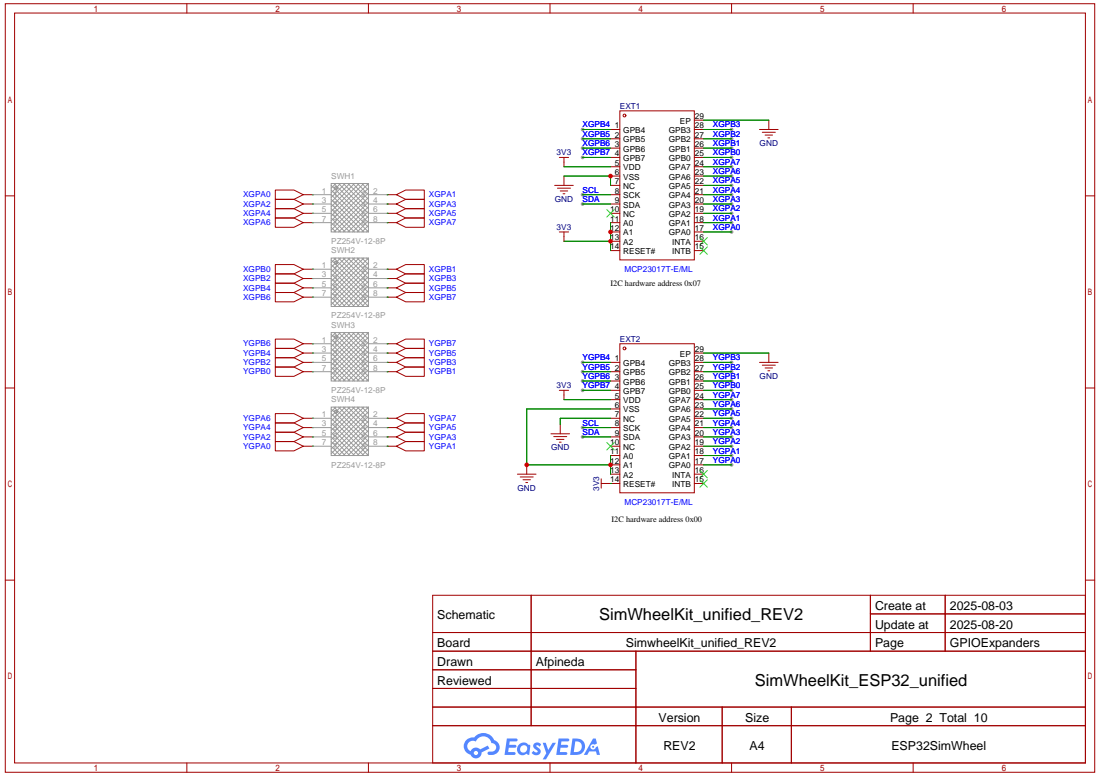
[picture p91: page 2]

Schematic | SimWheelKit_unified_REV2 | Create at | 2025-08-03

Update at | 2025-08-20

Board | SimwheelKit_unified_REV2 | Page | GPIOExpanders
Drawn | Afpineda | SimWheelKit_ESP32_unified
Reviewed

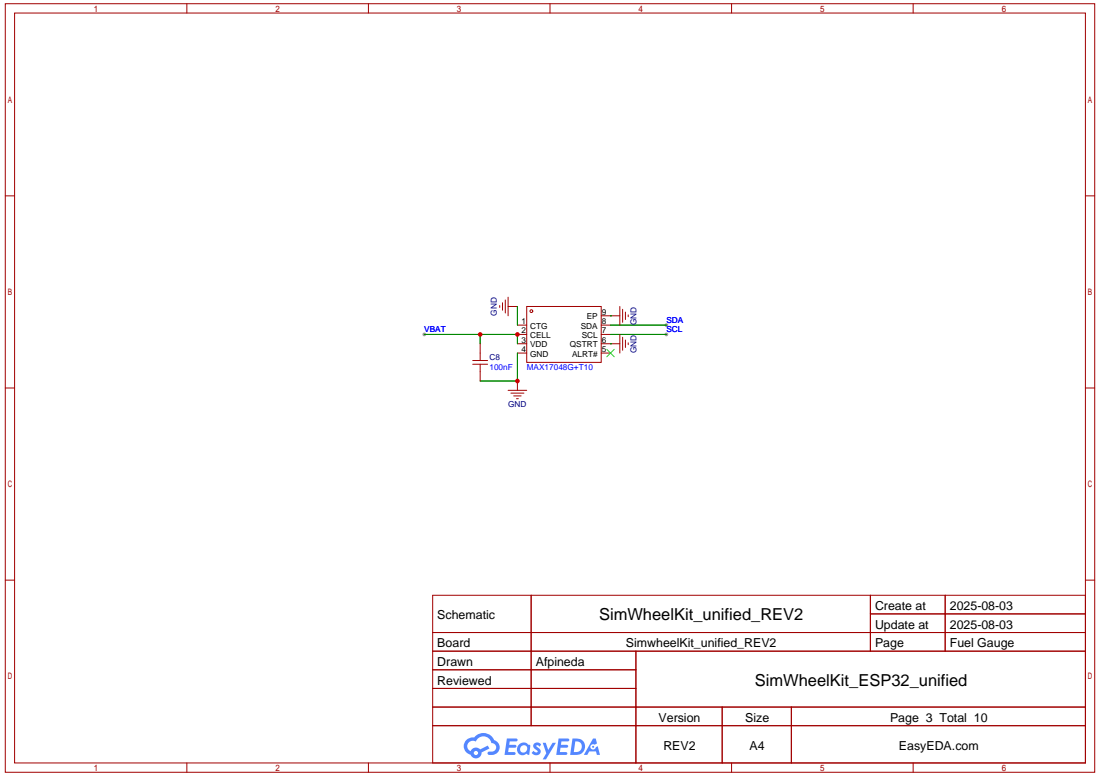
[picture p92: page 3]

Schematic | SimWheelKit_unified_REV2 | Create at | 2025-08-03

Update at | 2025-08-03

Board | SimwheelKit_unified_REV2 | Page | Fuel Gauge
Drawn | Afpineda | SimWheelKit_ESP32_unified
Reviewed

Version | Size | Page 3 Total 10
REV2 | A4 | EasyEDA.com

Parameter | Symbol | Value | Source

# I2C calculations

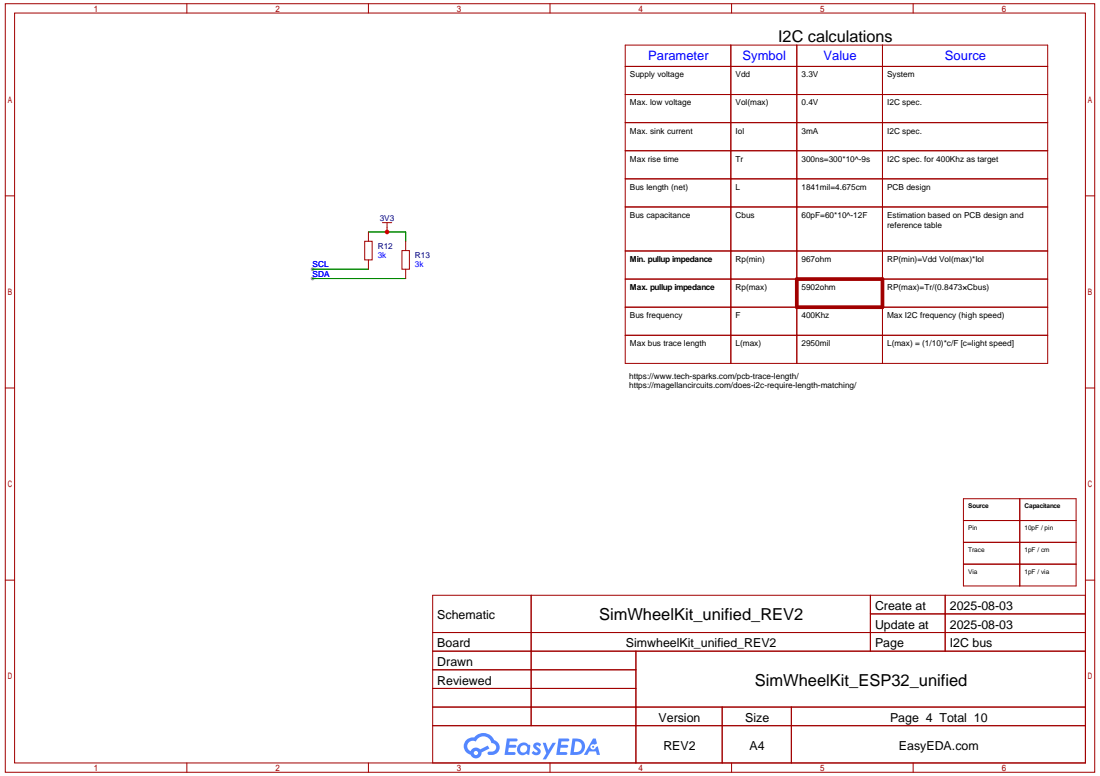
[picture p93: page 4]

Supply voltage | Vdd | 3.3V | System

Max. low voltage | Vol(max) | 0.4V | I2C spec.

Max. sink current | Iol | 3mA | I2C spec.

Max rise time | Tr | 300ns=300*10^-9s | I2C spec. for 400Khz as target

Bus length (net) | L | 1841mil=4.675cm | PCB design

Bus capacitance | Cbus | 60pF=60*10^-12F | Estimation based on PCB design and reference table

Min. pullup impedance | Rp(min) | 967ohm | RP(min)=Vdd Vol(max)*Iol

Max. pullup impedance | Rp(max) | 5902ohm | RP(max)=Tr/(0.8473×Cbus)

Bus frequency | F | 400Khz | Max I2C frequency (high speed)

Max bus trace length | L(max) | 2950mil | L(max) = (1/10)*c/F [c=light speed]

https://www.tech-sparks.com/pcb-trace-length/
https://magellancircuits.com/does-i2c-require-length-matching/

Source | Capacitance

Pin | 10pF / pin

Trace | 1pF / cm

Via | 1pF / via

Schematic | SimWheelKit_unified_REV2 | Create at | 2025-08-03

Update at | 2025-08-03

Board | SimwheelKit_unified_REV2 | Page | I2C bus
Drawn | | SimWheelKit_ESP32_unified
Reviewed

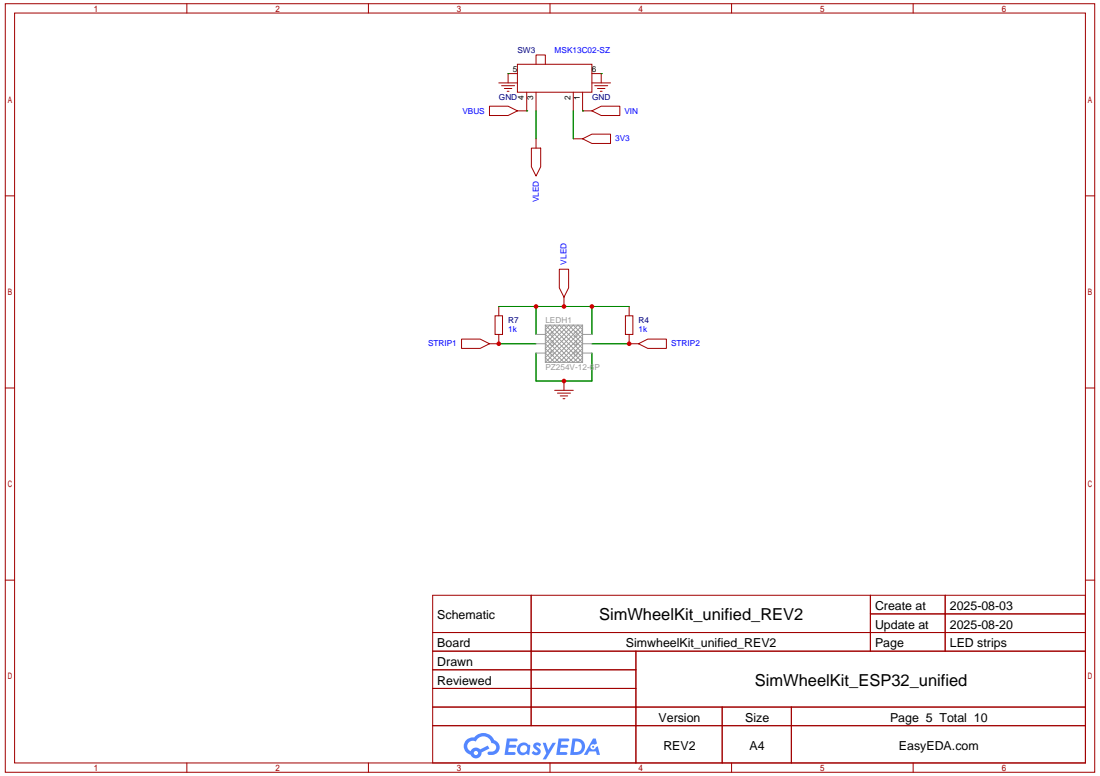
[picture p94: page 5]

Schematic | SimWheelKit_unified_REV2 | Create at | 2025-08-03

Update at | 2025-08-20

Board | SimwheelKit_unified_REV2 | Page | LED strips
Drawn | | SimWheelKit_ESP32_unified
Reviewed

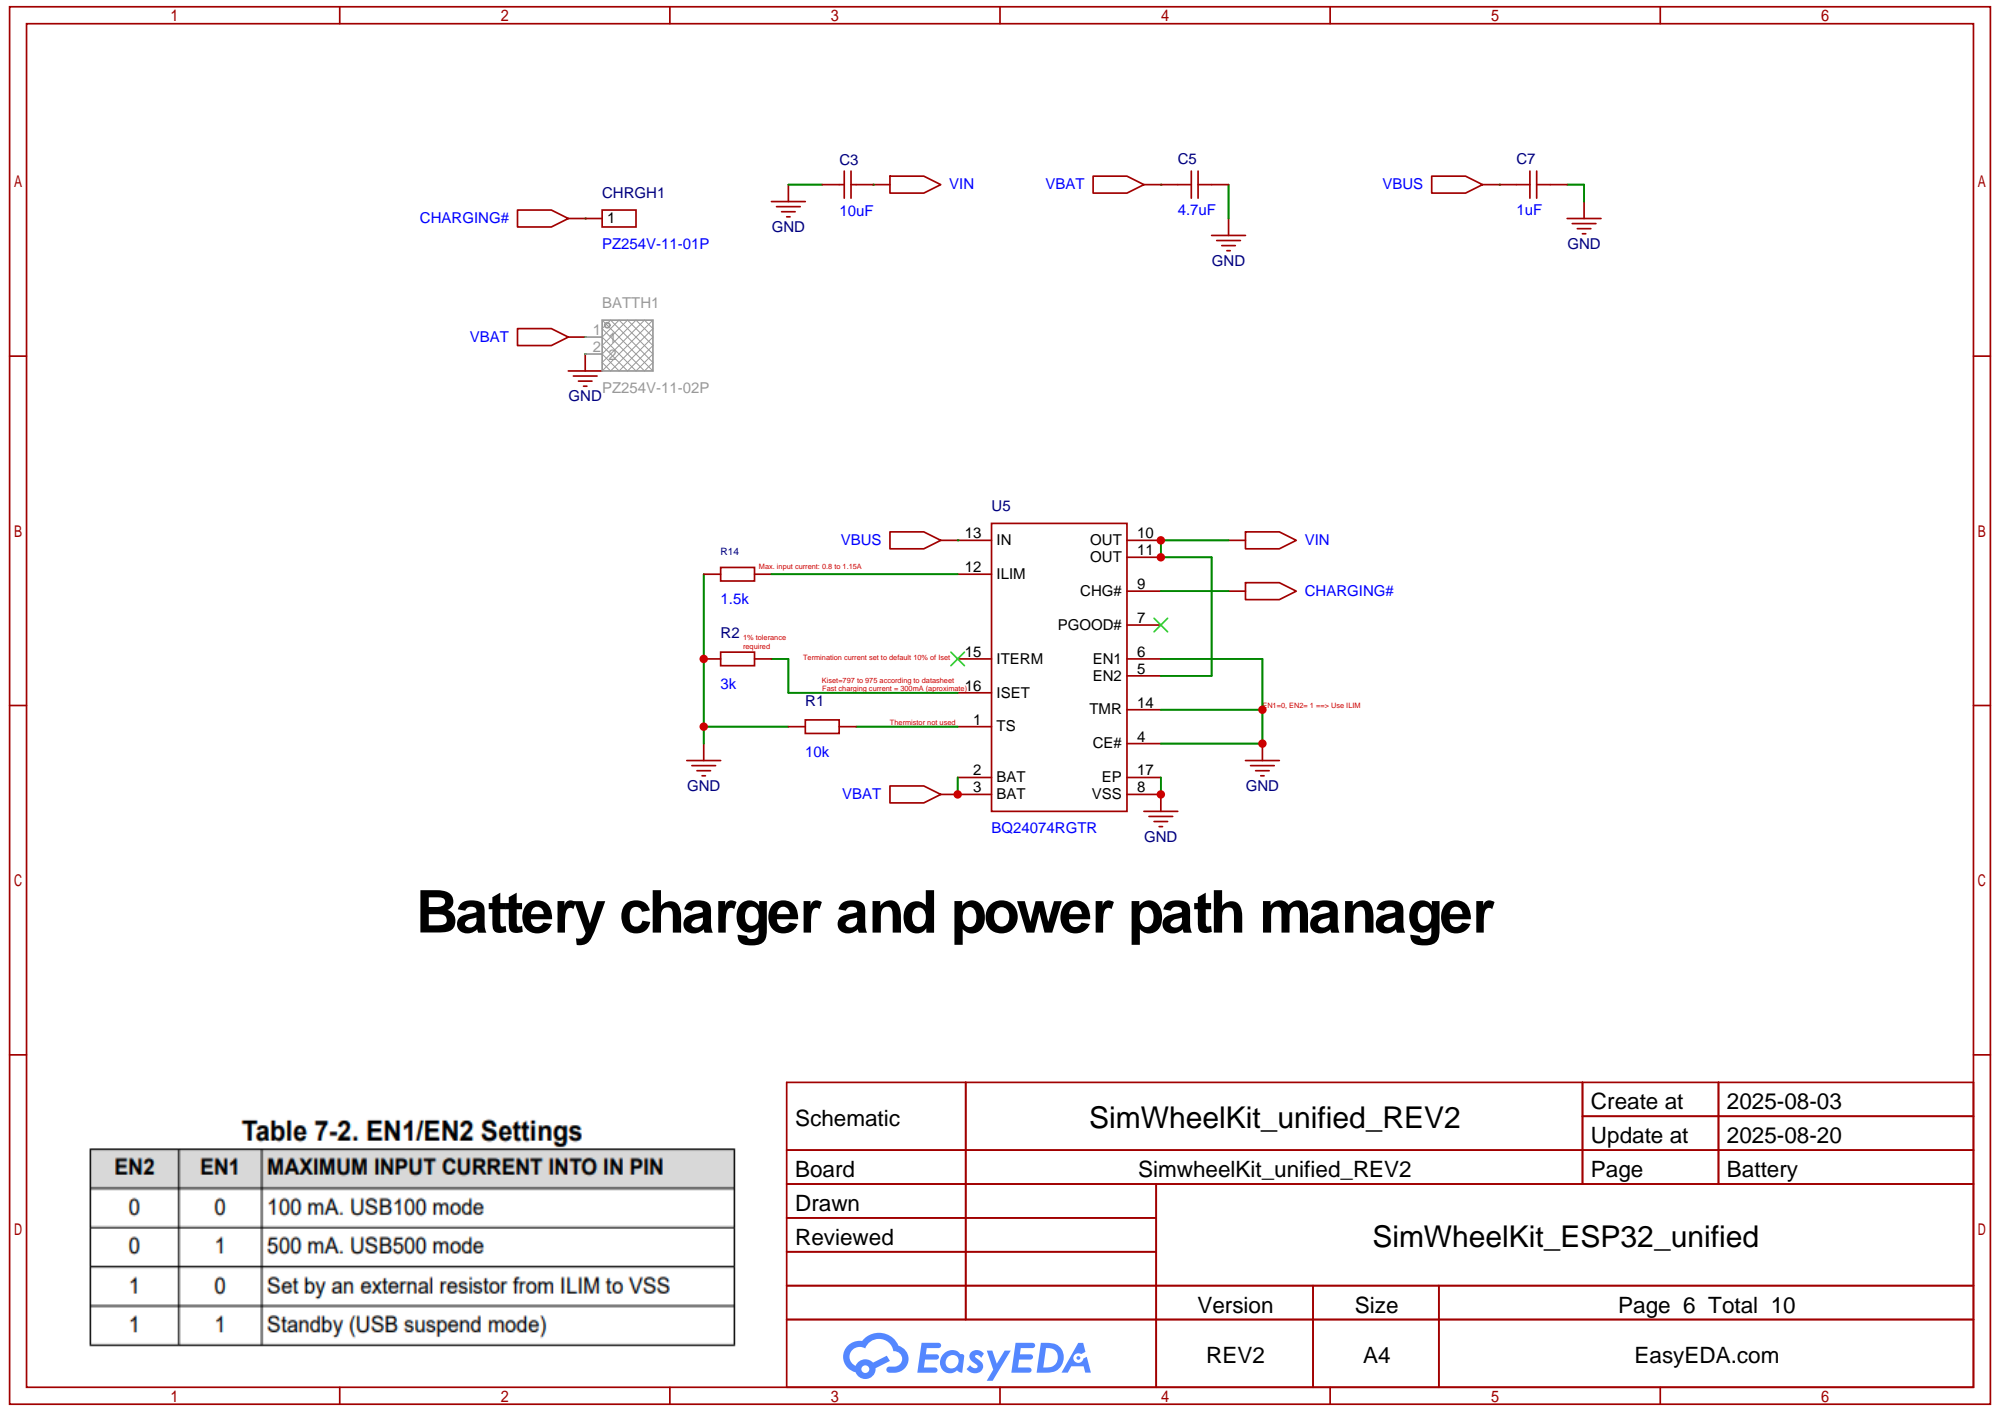
[picture p95: page 6]

Termination current set to default 10% of Iset

Kiset=797 to 975 according to datasheet
Fast charging current = 300mA (aproximate)

Battery charger and power path manager

Schematic | SimWheelKit_unified_REV2 | Create at | 2025-08-03

Update at | 2025-08-20

Board | SimwheelKit_unified_REV2 | Page | Battery
Drawn | | SimWheelKit_ESP32_unified
Reviewed

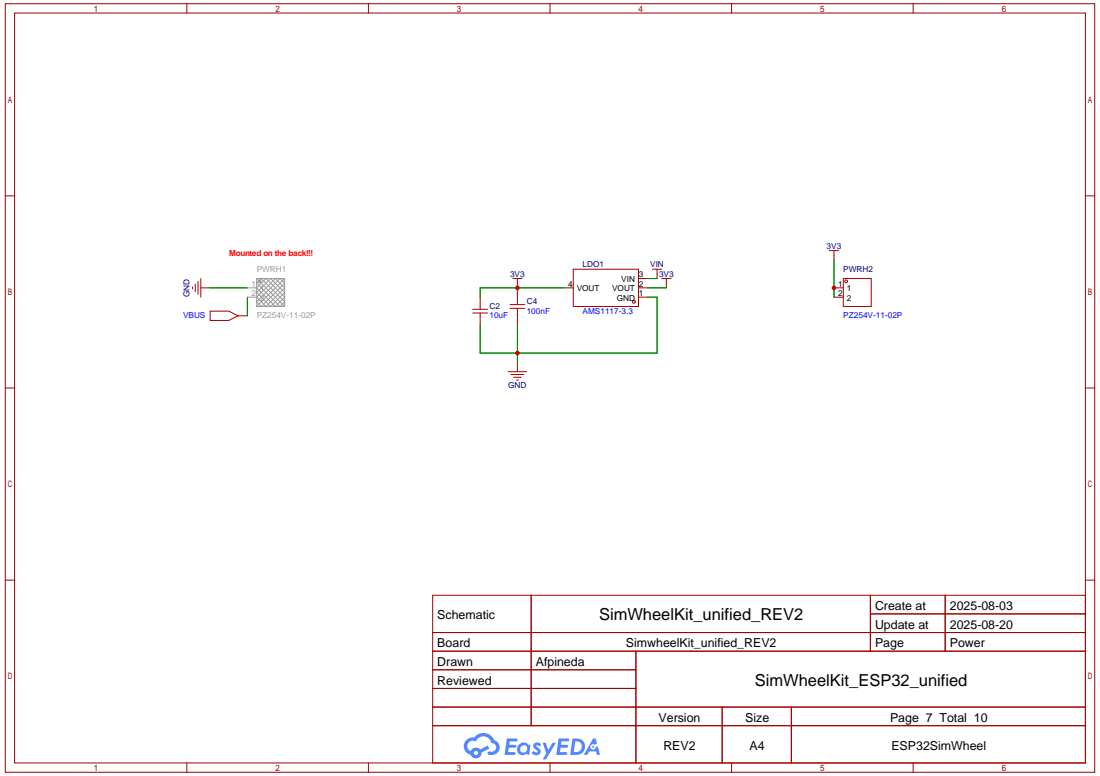
[picture p96: page 7]

Schematic | SimWheelKit_unified_REV2 | Create at | 2025-08-03

Update at | 2025-08-20

Board | SimwheelKit_unified_REV2 | Page | Power
Drawn | Afpineda | SimWheelKit_ESP32_unified
Reviewed

# Clutch

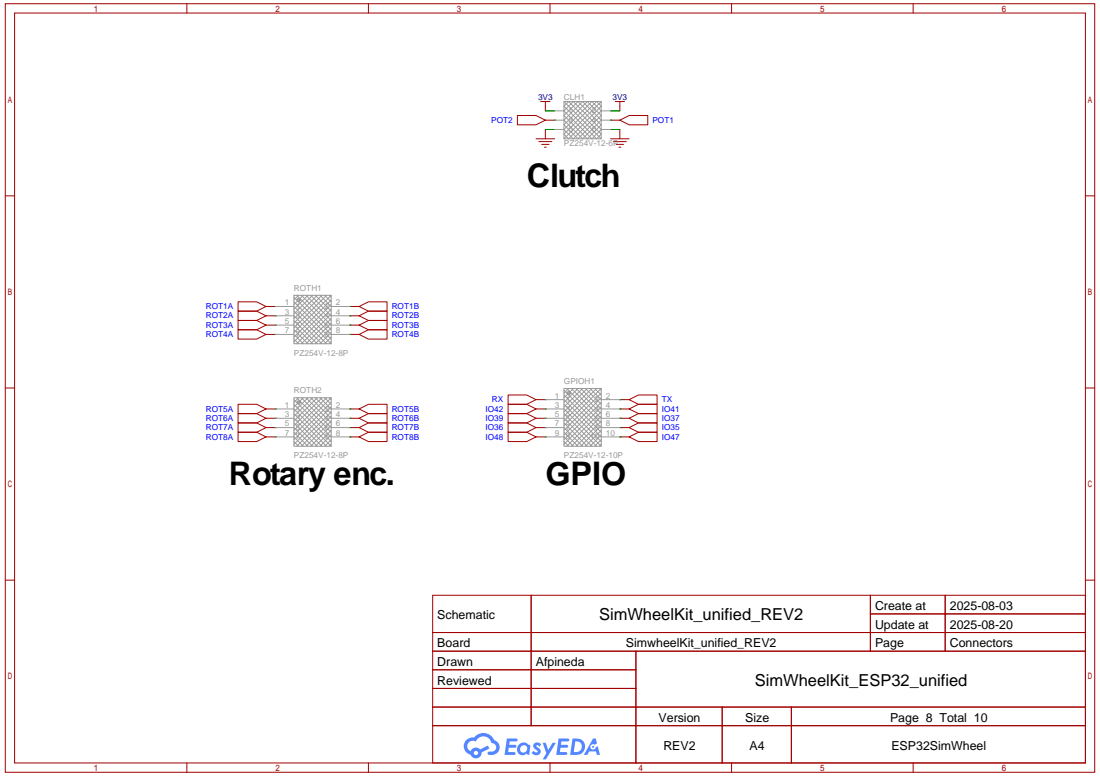
[picture p97: page 8]

Schematic | SimWheelKit_unified_REV2 | Create at | 2025-08-03

Update at | 2025-08-20

Board | SimwheelKit_unified_REV2 | Page | Connectors
Drawn | Afpineda | SimWheelKit_ESP32_unified
Reviewed

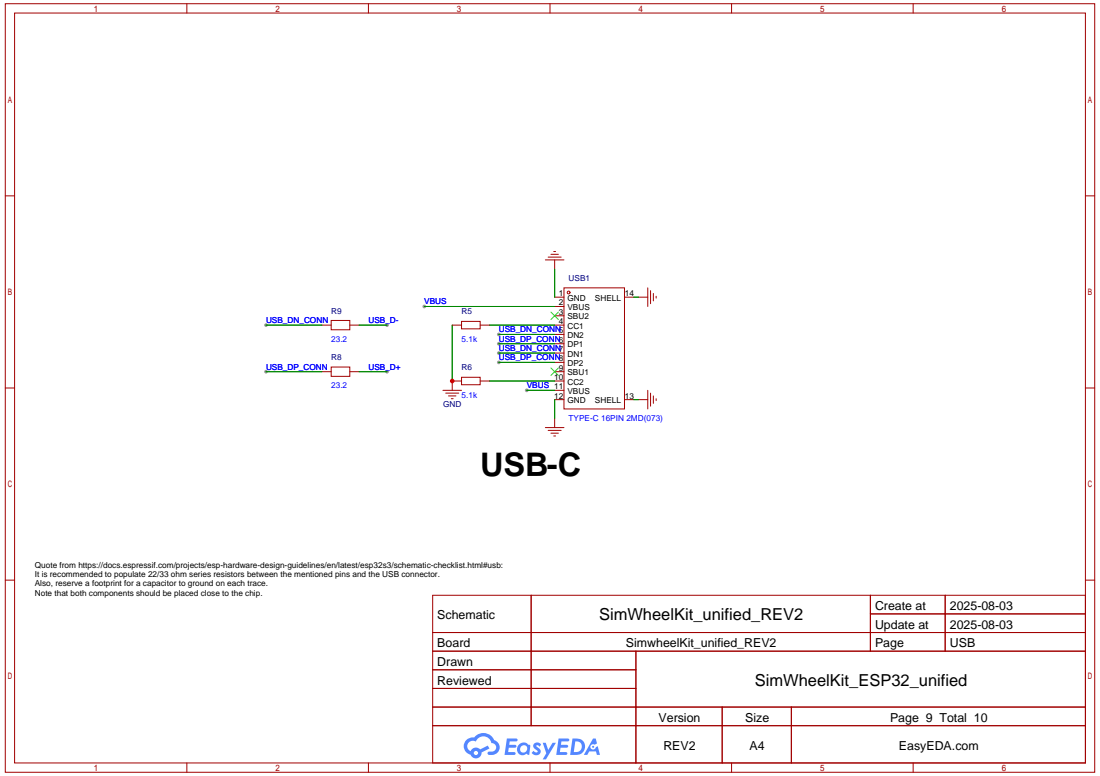
[picture p98: page 9]

Quote from https://docs.espressif.com/projects/esp-hardware-design-guidelines/en/latest/esp32s3/schematic-checklist.html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:
It is recommended to populate 22/33 ohm series resistors between the mentioned pins and the USB connector.
Also, reserve a footprint for a capacitor to ground on each trace.
Note that both components should be placed close to the chip.

Schematic | SimWheelKit_unified_REV2 | Create at | 2025-08-03

Update at | 2025-08-03

Board | SimwheelKit_unified_REV2 | Page | USB
Drawn | | SimWheelKit_ESP32_unified
Reviewed

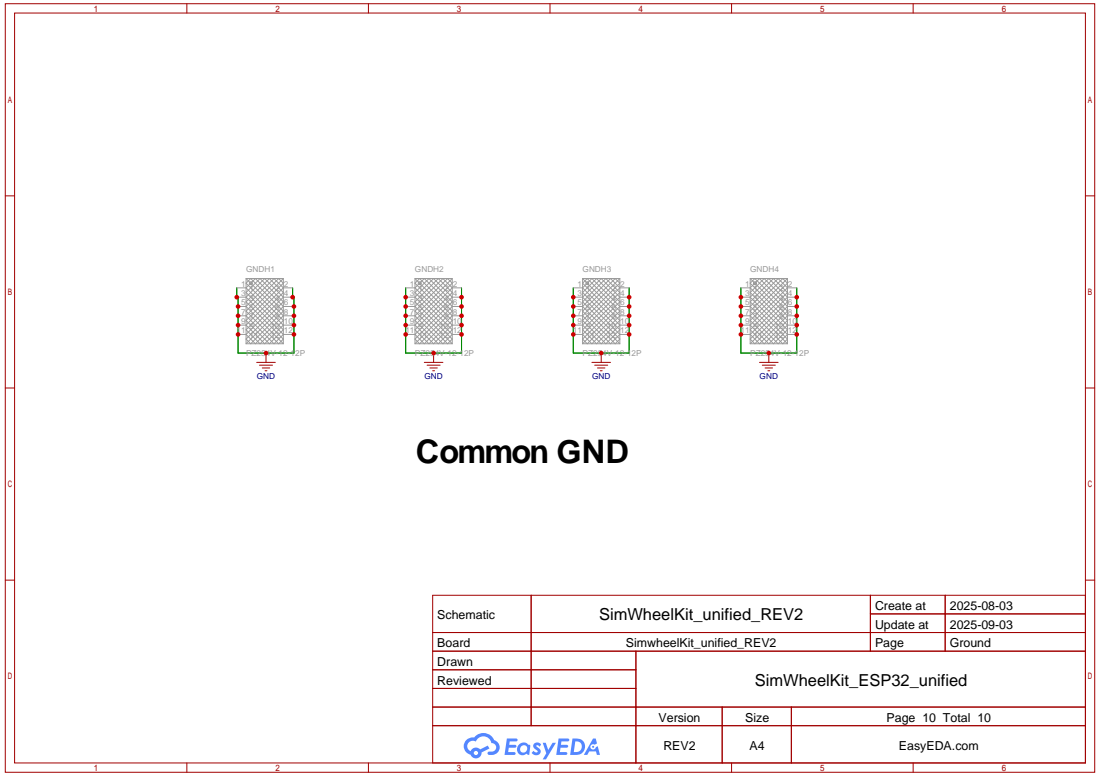
[picture p99: page 10]

Schematic | SimWheelKit_unified_REV2 | Create at | 2025-08-03

Update at | 2025-09-03

Board | SimwheelKit_unified_REV2 | Page | Ground
Drawn | | SimWheelKit_ESP32_unified
Reviewed
