afpineda/OpenSourceSimWheelESP32/doc/pcb/ModulePlayAndCharge/ModulePlayAndCharge_schematic.pdf

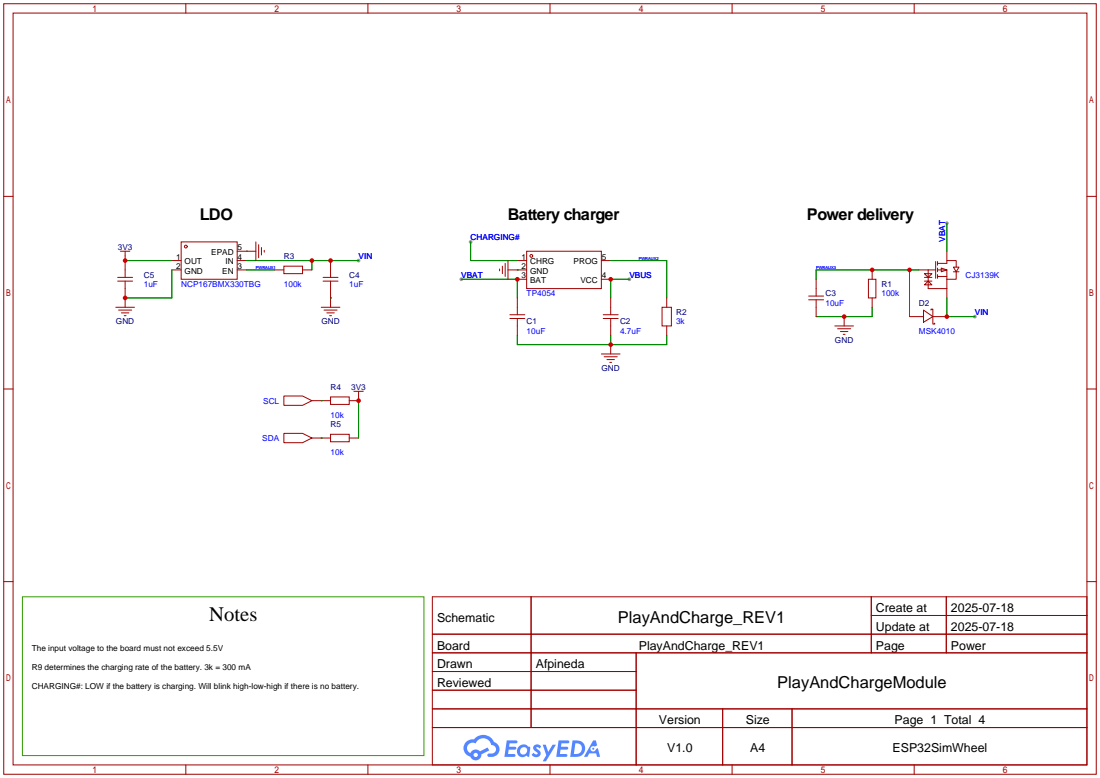
[picture p100: page 1]

Schematic | PlayAndCharge_REV1 | Create at | 2025-07-18

Update at | 2025-07-18

Board | PlayAndCharge_REV1 | Page | Power
Drawn | Afpineda | PlayAndChargeModule
Reviewed

The input voltage to the board must not exceed 5.5V
R9 determines the charging rate of the battery. 3k = 300 mA
CHARGING#: LOW if the battery is charging. Will blink high-low-high if there is no battery.

Version | Size | Page 1 Total 4
V1.0 | A4 | ESP32SimWheel

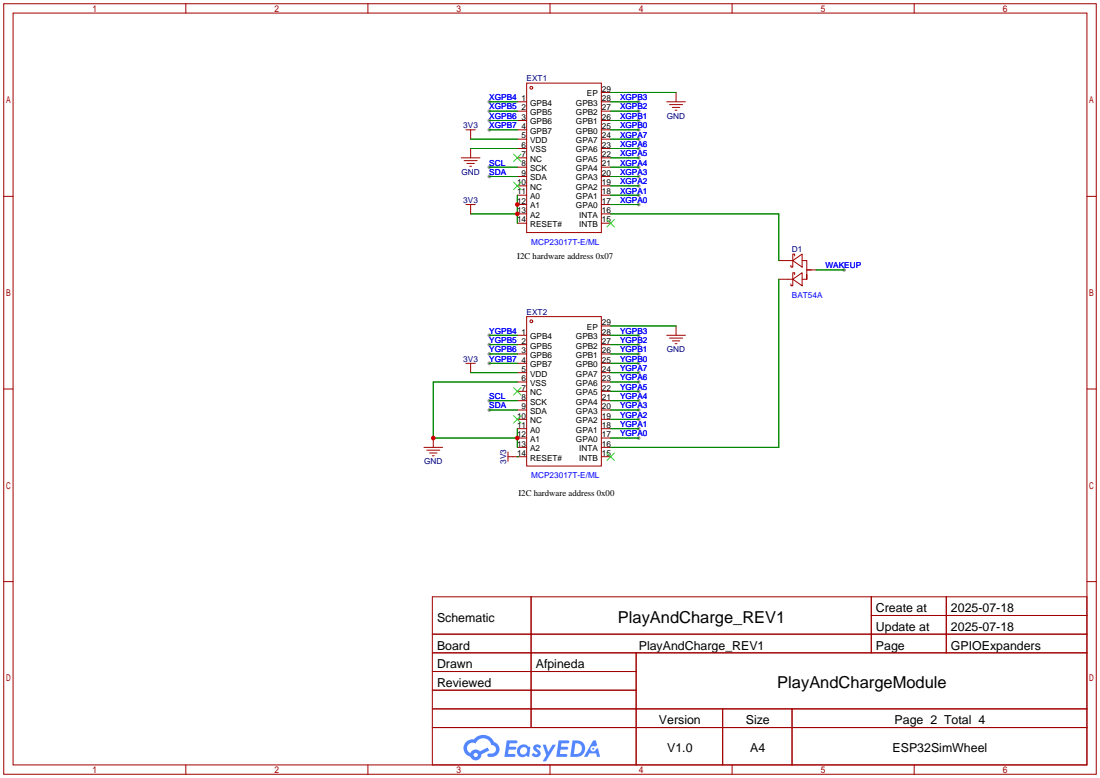
[picture p101: page 2]

Schematic | PlayAndCharge_REV1 | Create at | 2025-07-18

Update at | 2025-07-18

Board | PlayAndCharge_REV1 | Page | GPIOExpanders
Drawn | Afpineda | PlayAndChargeModule
Reviewed

Version | Size | Page 2 Total 4
V1.0 | A4 | ESP32SimWheel

# External 5V0 Battery

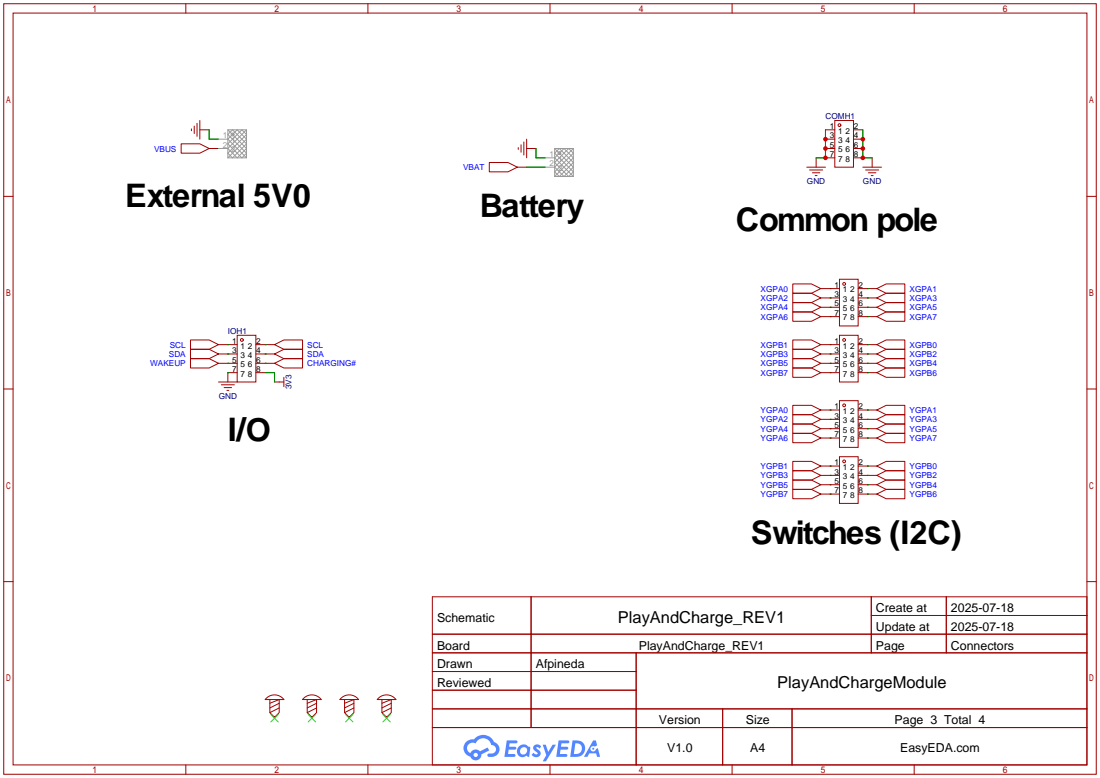
[picture p102: page 3]

Schematic | PlayAndCharge_REV1 | Create at | 2025-07-18

Update at | 2025-07-18

Board | PlayAndCharge_REV1 | Page | Connectors
Drawn | Afpineda | PlayAndChargeModule
Reviewed

Version | Size | Page 3 Total 4
V1.0 | A4 | EasyEDA.com

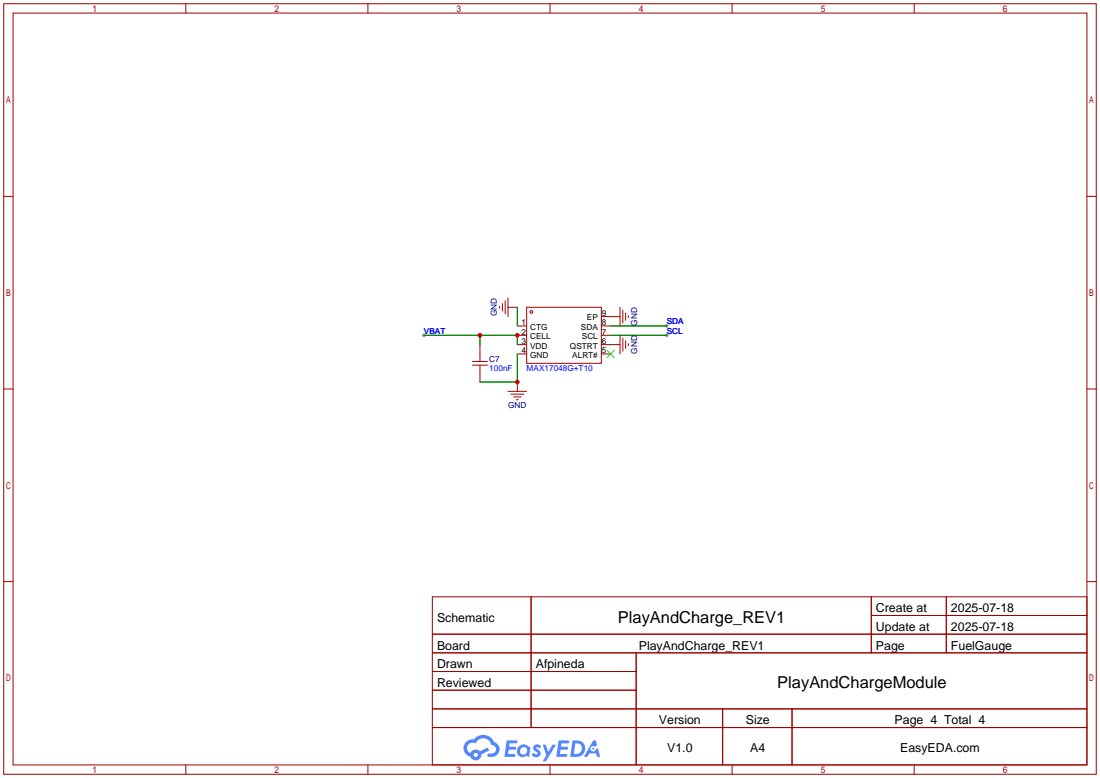
[picture p103: page 4]

Schematic | PlayAndCharge_REV1 | Create at | 2025-07-18

Update at | 2025-07-18

Board | PlayAndCharge_REV1 | Page | FuelGauge
Drawn | Afpineda | PlayAndChargeModule
Reviewed

Version | Size | Page 4 Total 4
V1.0 | A4 | EasyEDA.com
