afpineda/OpenSourceSimWheelESP32/doc/pcb/Module24sw_TH/Module24Switches_TH_2025.pdf

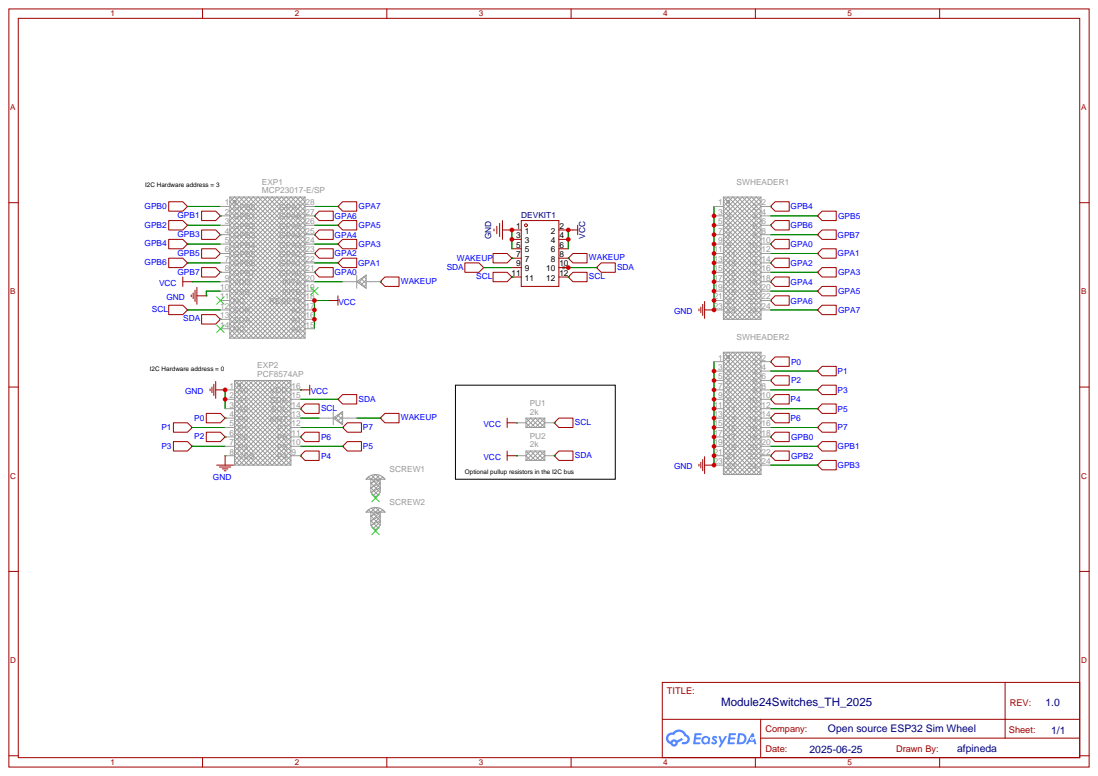
[picture p104: page 1]

Optional pullup resistors in the I2C bus

Open source ESP32 Sim Wheel
