afpineda/OpenSourceSimWheelESP32/doc/pcb/ModuleBtnMatrix25sw/ModuleBtnMatrix25sw.pdf

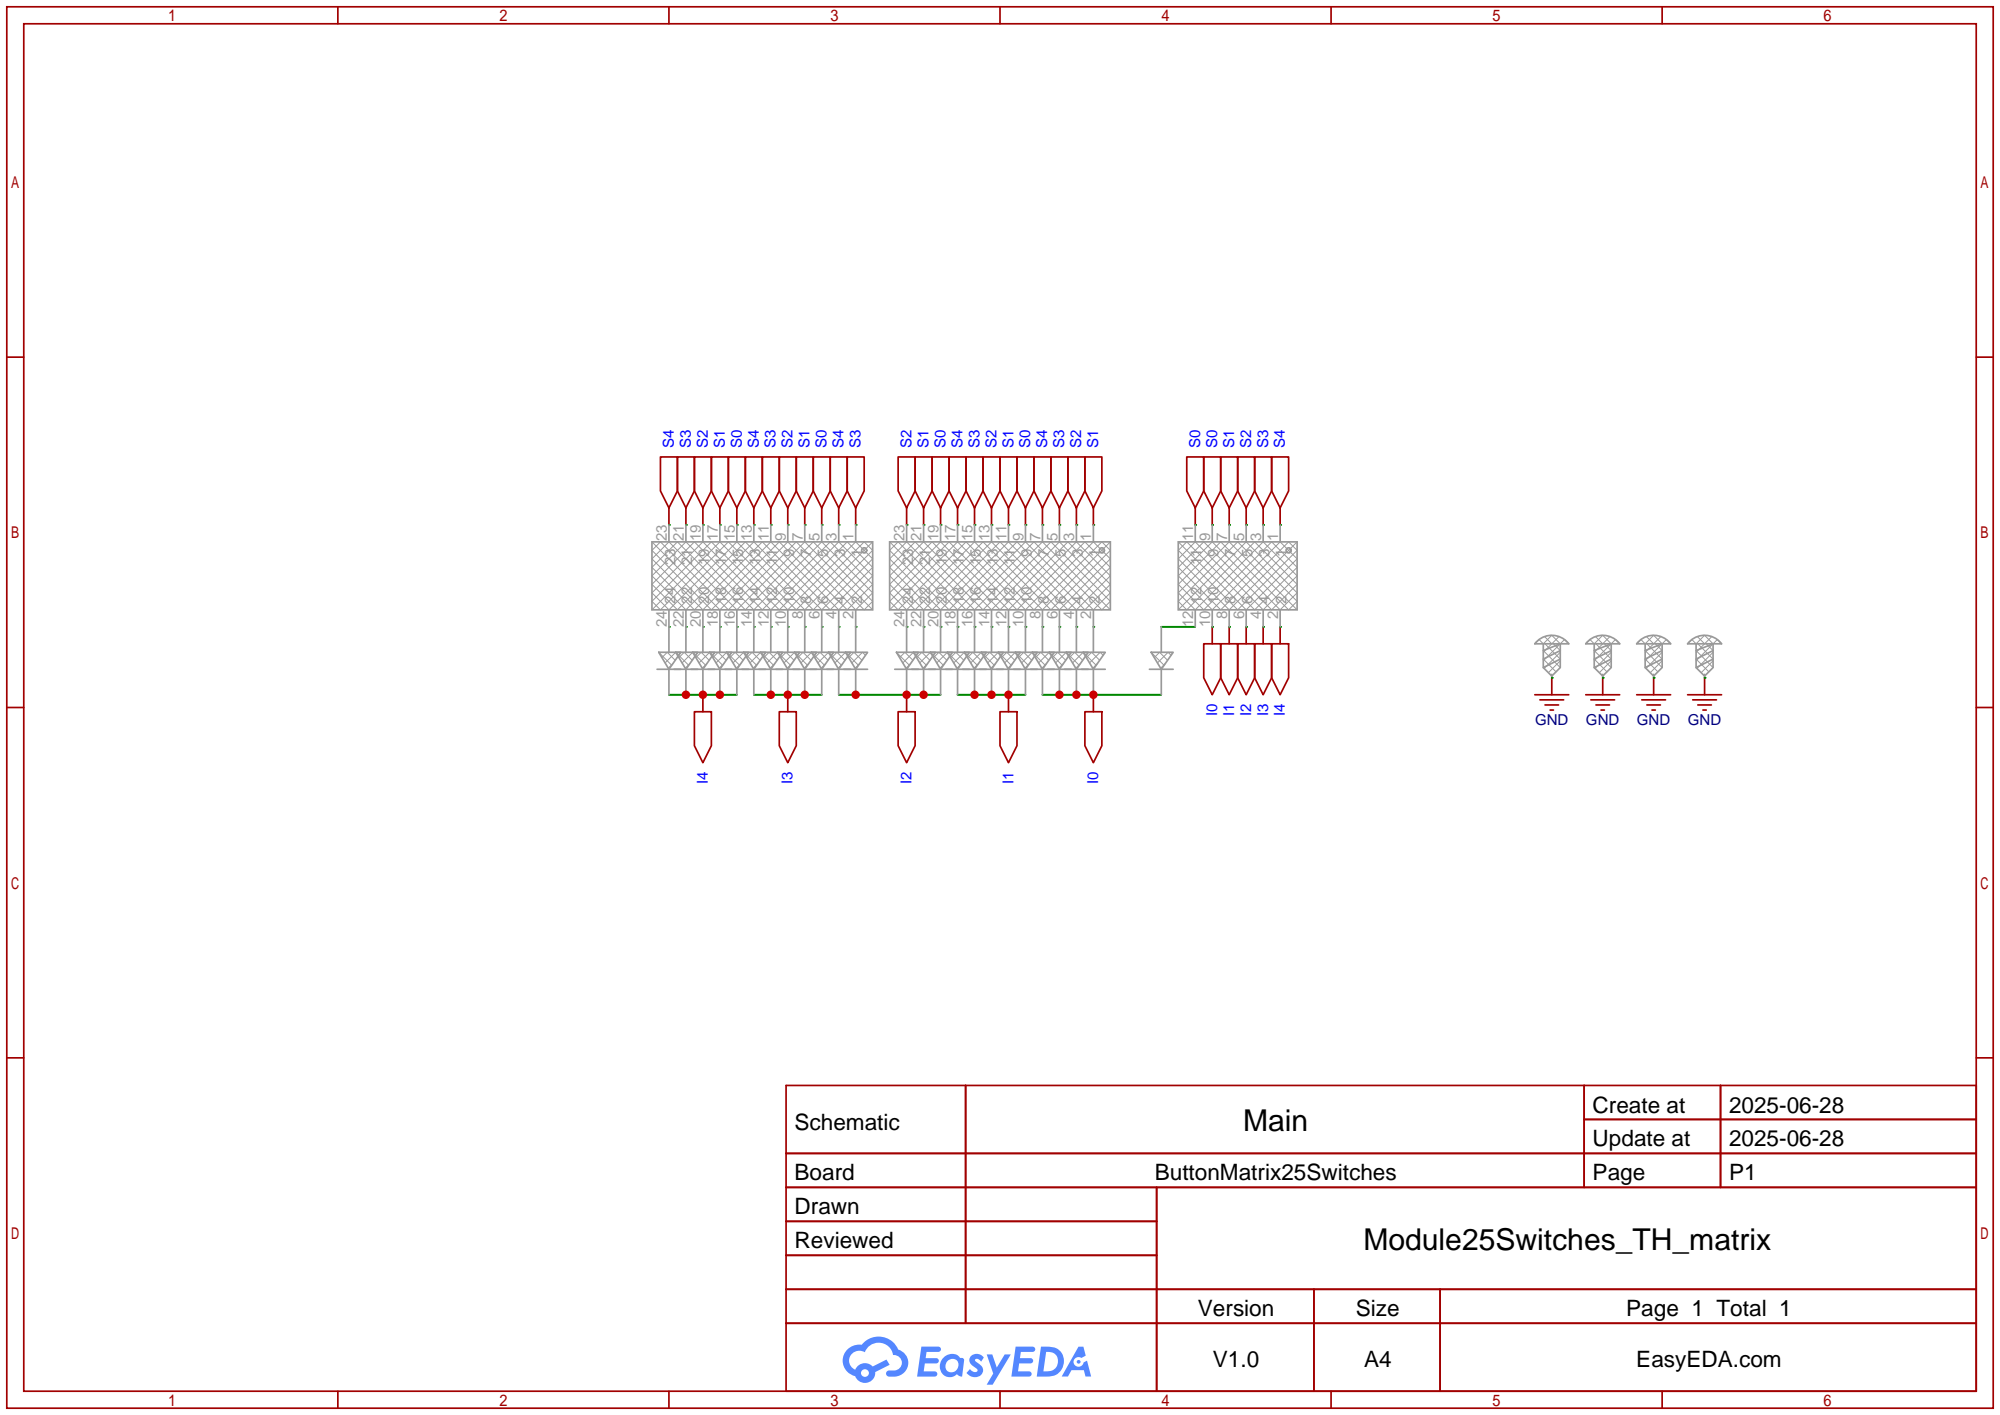
[picture p105: page 1]

GND GND

Schematic | Main | Create at | 2025-06-28

Update at | 2025-06-28

Board | ButtonMatrix25Switches | Page | P1
Drawn | | Module25Switches_TH_matrix
Reviewed

Version | Size | Page 1 Total 1
V1.0 | A4 | EasyEDA.com
