afpineda/OpenSourceSimWheelESP32/doc/pcb/Module32sw_TH/Module32Switches_TH.pdf

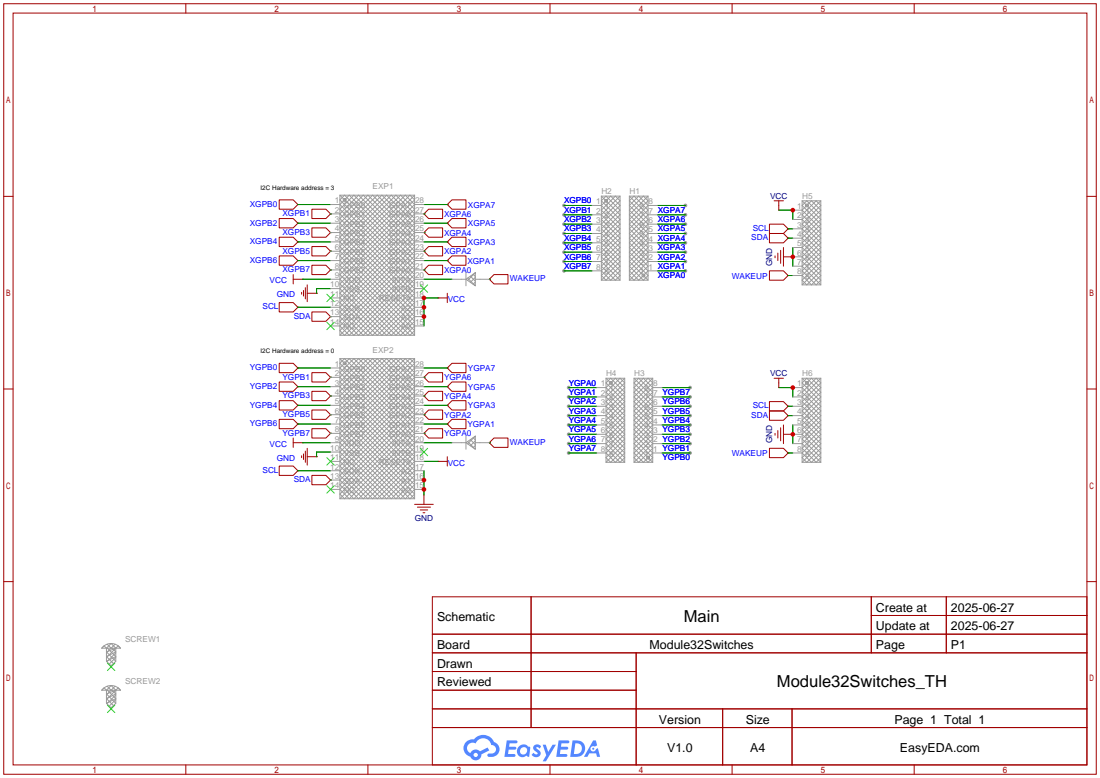
[picture p106: page 1]

Schematic | Main | Create at | 2025-06-27

Update at | 2025-06-27

Board | Module32Switches | Page | P1
Drawn | | Module32Switches_TH
Reviewed

Version | Size | Page 1 Total 1
V1.0 | A4 | EasyEDA.com
