afpineda/OpenSourceSimWheelESP32/(list of files, drawings)

Other design files:
doc/pcb/CustomDevKit/CustomDevKit.epro
doc/pcb/Module24sw_TH/Module24Switches_TH_2025.epro
doc/pcb/Module32sw_TH/Module32Switches_TH.epro
doc/pcb/ModuleBtnMatrix25sw/ModuleBtnMatrix25sw.epro
doc/pcb/ModulePlayAndCharge/ModulePlayAndCharge.epro
