afpineda/OpenSourceSimWheelESP32/src/include/InputHardware.hpp

/**
 * @file InputHardware.hpp
 *
 * @author Ángel Fernández Pineda. Madrid. Spain.
 * @date 2025-02-02
 * @brief Input hardware classes
 *
 * @copyright Licensed under the EUPL
 *
 */

#pragma once

//-------------------------------------------------------------------
// Imports
//-------------------------------------------------------------------

#include "InternalTypes.hpp" // For BitQueue
#include "InputSpecification.hpp"
#include <initializer_list>

//-------------------------------------------------------------------
// (Abstract) DigitalInput
//-------------------------------------------------------------------

/**
 * @brief Base class for all polled switches
 *
 * @note Instances of this base class are supposed to
 *       live forever.
 */
class DigitalInput
{
public:
    virtual ~DigitalInput() noexcept {}

    /**
     * @brief Read the current state of the inputs (pressed or released)
     *
     * @warning This function must not set or clear any bit outside of the
     *          input bitmask in the return value.
     *
     * @param[in,out] state At call, state of all inputs
     *                      as recorded in the previous iteration.
     *                      Whether the current state is unknown,
     *                      @p state must be kept untouched.
     *                      At return, new state of the inputs.
     */
    virtual void read(uint128_t &state) = 0;
};

//-------------------------------------------------------------------
// Single button
//-------------------------------------------------------------------

/**
 * @brief Single button
 *
 */
class DigitalButton : public DigitalInput
{
protected:
    /// @brief Configured input pin
    InputGPIO pinNumber;
    /// @brief Input bitmap
    uint8_t inputNumber;

public:
    /**
     * @brief Construct a new Digital Button object
     *
     * @param[in] pinNumber GPIO pin where the button is attached to
     * @param[in] buttonNumber Assigned number for this button
     */
    DigitalButton(InputGPIO pinNumber, InputNumber buttonNumber);

    virtual void read(uint128_t &state) override;
};

//-------------------------------------------------------------------
// Rotary encoder
//-------------------------------------------------------------------

/**
 * @brief Relative Rotary Encoder
 *
 */
class RotaryEncoderInput : public DigitalInput
{
private:
    InputGPIO clkPin, dtPin; // pins
    uint8_t code;            // State of the decoding algorithm
    uint16_t sequence;       // Last sequence of states
    uint8_t cwButton;
    uint8_t ccwButton;
    BitQueue queue;
    bool cwOrCcw;

    // duration of the current "pulse" event in polling cycles
    uint8_t currentPulseWidth;

    // a "virtual button" press event was notified at read(),
    // so a release event must be notified next
    bool pressEventNotified;

    static void isrh(void *instance);
    static void isrhAlternateEncoding(void *instance);

public:
    /**
     * @brief Pulse multiplier for rotary encoders
     *
     * @note For read only. Do not overwrite.
     *       Always greater than zero.
     */
    inline static uint8_t pulseMultiplier = 1;

    /**
     * @brief Construct a new Rotary Encoder Input object
     *
     * @param[in] clkPin GPIO pin attached to the "CLK" (or "A")
     *                   pin of the encoder.
     * @param[in] dtPin GPIO pin attached to the "DT" (or "B")
     *                  pin of the encoder.
     * @param[in] cwButtonNumber An input number for the
     *                           clockwise rotation event.
     * @param[in] ccwButtonNumber An input number for the
     *                            counter-clockwise rotation event.
     * @param[in] useAlternateEncoding Set to true in order to use the
     *                                 signal encoding of ALPS RKJX series
     *                                 of rotary encoders, and the alike.
     * @note Internal pullup resistors will be enabled when available.
     */
    RotaryEncoderInput(
        InputGPIO clkPin,
        InputGPIO dtPin,
        InputNumber cwButtonNumber,
        InputNumber ccwButtonNumber,
        bool useAlternateEncoding = false);

    /**
     * @brief Set a time multiplier for "pulse" events
     *
     * @param multiplier A time multiplier between 1 and 6.
     *                   Invalid values are ignored.
     * @return true if the multiplier has changed.
     * @return false otherwise.
     */
    static bool setPulseMultiplier(uint8_t multiplier)
    {
        if ((multiplier >= static_cast<uint8_t>(PulseWidthMultiplier::X1)) &&
            (multiplier <=
             static_cast<uint8_t>(PulseWidthMultiplier::_MAX_VALUE)) &&
            (pulseMultiplier != multiplier))
        {
            pulseMultiplier = multiplier;
            return true;
        }
        return false;
    };

    virtual void read(uint128_t &state) override;
};

//-------------------------------------------------------------------
// Button matrix
//-------------------------------------------------------------------

/**
 * @brief Button matrix hardware
 *
 */
class ButtonMatrixInput : public DigitalInput
{
private:
    // InputGPIOCollection inputPins = {};
    // OutputGPIOCollection outputPins = {};
    ButtonMatrix matrix;
    bool negativeLogic;

public:
    /**
     * @brief Construct a new Button Matrix Input object
     *
     * @param matrix Button matrix specification
     * @param negativeLogic True to use negative logic
     */
    ButtonMatrixInput(
        const ButtonMatrix &matrix,
        bool negativeLogic = false);

    virtual void read(uint128_t &state) override;
};

//-------------------------------------------------------------------
// Analog Multiplexers
//-------------------------------------------------------------------

/**
 * @brief State of switches connected to analog multiplexers
 *
 * @note Despite the use of analog multiplexers, input is digital (on/off)
 *
 */
class AnalogMultiplexerInput : public DigitalInput
{
private:
    ::std::vector<OutputGPIO> selectorPins{};
    ::std::vector<InputGPIO> inputPins{};
    ::std::vector<uint8_t> inputNumber{};

public:
    /**
     * @brief Construct a new Analog Multiplexer Input object
     *
     * @param selectorPin1 A selector pin
     * @param selectorPin2 A selector pin
     * @param selectorPin3 A selector pin
     * @param chips Group of chips
     */
    AnalogMultiplexerInput(
        OutputGPIO selectorPin1,
        OutputGPIO selectorPin2,
        OutputGPIO selectorPin3,
        const AnalogMultiplexerGroup<Mux8Pin> &chips);

    /**
     * @brief Construct a new Analog Multiplexer Input object
     *
     * @param selectorPin1 A selector pin
     * @param selectorPin2 A selector pin
     * @param selectorPin3 A selector pin
     * @param selectorPin4 A selector pin
     * @param chips Group of chips
     */
    AnalogMultiplexerInput(
        OutputGPIO selectorPin1,
        OutputGPIO selectorPin2,
        OutputGPIO selectorPin3,
        OutputGPIO selectorPin4,
        const AnalogMultiplexerGroup<Mux16Pin> &chips);

    /**
     * @brief Construct a new Analog Multiplexer Input object
     *
     * @param selectorPin1 A selector pin
     * @param selectorPin2 A selector pin
     * @param selectorPin3 A selector pin
     * @param selectorPin4 A selector pin
     * @param selectorPin5 A selector pin
     * @param chips Group of chips
     */
    AnalogMultiplexerInput(
        OutputGPIO selectorPin1,
        OutputGPIO selectorPin2,
        OutputGPIO selectorPin3,
        OutputGPIO selectorPin4,
        OutputGPIO selectorPin5,
        const AnalogMultiplexerGroup<Mux32Pin> &chips);

    virtual void read(uint128_t &state) override;

private:
    void initializeMux(
        ::std::initializer_list<OutputGPIO> selectorPins,
        const ::std::vector<InputGPIO> &inputPins);
};

//-------------------------------------------------------------------
// I2C input hardware
//-------------------------------------------------------------------

/**
 * @brief Base class for switches/buttons attached to an I2C GPIO expander
 *
 * @note All buttons must work in negative logic (pulled up)
 */
class I2CInput : public DigitalInput // : public I2CInput
{
protected:
    /// @brief Slave device in the I2C API (must be type-casted)
    void *device = nullptr;

public:
    /**
     * @brief Construct a new I2CButtonsInput object
     *
     * @param address7Bits I2C address in 7 bits format
     * @param bus Bus where the chip is attached to
     * @param max_speed_mult Bus speed multiplier in the range from 1 to 4
     */
    I2CInput(
        uint8_t address7Bits,
        I2CBus bus = I2CBus::PRIMARY,
        uint8_t max_speed_mult = 1);

    virtual ~I2CInput();
};

/**
 * @brief Class for buttons attached to a PCF8574 GPIO expander
 *
 */
class PCF8574ButtonsInput : public I2CInput
{
private:
    PCF8574Expander inputNumbers;
    bool getGPIOstate(uint8_t &state);

public:
    /**
     * @brief Construct a new PCF8574ButtonsInput object
     *
     * @param inputNumbers Specification of inputs
     * @param address7Bits I2C address in 7 bits format
     * @param bus Bus where the chip is attached to
     */
    PCF8574ButtonsInput(
        const PCF8574Expander &inputNumbers,
        uint8_t address7Bits,
        I2CBus bus = I2CBus::PRIMARY);

    virtual void read(uint128_t &state) override;
};

/**
 * @brief Class for buttons attached to a MCP23017 GPIO expander
 *
 */
class MCP23017ButtonsInput : public I2CInput
{
private:
    MCP23017Expander inputNumbers;
    bool getGPIOstate(uint16_t &state);
    void configure();

public:
    /**
     * @brief Construct a new MCP23017ButtonsInput object
     *
     * @param inputNumbers Specification of inputs
     * @param address7Bits I2C address in 7 bits format
     * @param bus Bus where the chip is attached to
     */
    MCP23017ButtonsInput(
        const MCP23017Expander &inputNumbers,
        uint8_t address7Bits,
        I2CBus bus = I2CBus::PRIMARY);

    virtual void read(uint128_t &state) override;
};

//-------------------------------------------------------------------
// Shift registers
//-------------------------------------------------------------------

/**
 * @brief State of switches connected to PISO shift registers
 *
 */
class ShiftRegistersInput : public DigitalInput
{
private:
    size_t switchCount;
    InputGPIO serialPin;
    OutputGPIO loadPin;
    OutputGPIO nextPin;
    ::std::vector<uint8_t> inputNumber{};
    bool loadHighOrLow;
    bool nextHighToLowOrLowToHigh;
    bool negativeLogic;

public:
    /**
     * @brief Construct a new Shift Registers Input object
     *
     * @param loadPin GPIO number of the load pin
     * @param nextPin GPIO number of the next/clock pin
     * @param inputPin GPIO number of the serial output pin
     * @param chain Chain of PISO shift registers
     * @param SER_inputNumber Input number assigned to the SER pin
     *                        in the last chip of the chain.
     * @param loadHighOrLow If true, parallel inputs are loaded
     *                      when `loadPin`is HIGH.
     *                      If false, parallel inputs are loaded
     *                      when `loadPin`is LOW.
     * @param nextHighToLowOrLowToHigh If true, next bit is selected when
     *                                 an high-to-low pulse is detected
     *                                 at `nextPin`. If false, next bit
     *                                 is selected when a low-to-high pulse
     *                                 is detected.
     * @param negativeLogic If true, all switches must be
     *                      pulled down (the default),
     *                      If false, all switches must be
     *                      pulled up (positive logic).
     */
    ShiftRegistersInput(
        OutputGPIO loadPin,
        OutputGPIO nextPin,
        InputGPIO inputPin,
        const ShiftRegisterChain &chain,
        InputNumber SER_inputNumber = UNSPECIFIED::VALUE,
        const bool loadHighOrLow = false,
        const bool nextHighToLowOrLowToHigh = false,
        const bool negativeLogic = true);

    virtual void read(uint128_t &state) override;
};

//-------------------------------------------------------------------
// Potentiometers
//-------------------------------------------------------------------

/**
 * @brief Class for all polled analog inputs (axis)
 *
 */
class AnalogInput
{
public:
    /**
     * @brief Get auto-calibration data. Required for persistent storage.
     *
     * @param[out] minReading Minimum adc reading
     * @param[out] maxReading Maximum adc reading
     */
    virtual void getCalibrationData(int &minReading, int &maxReading) = 0;

    /**
     * @brief Set auto-calibration data (loaded from persistent storage).
     *
     * @param[out] minReading Minimum adc reading
     * @param[out] maxReading Maximum adc reading
     */
    virtual void setCalibrationData(int minReading, int maxReading) = 0;

    /**
     * @brief Force auto-calibration.
     *
     */
    virtual void resetCalibrationData() = 0;

    /**
     * @brief Read current axis position.
     *        The axis must go from one end to the other
     *        for auto- calibration.
     *
     * @param[out] value Current axis position.
     * @param[out] autoCalibrated True if this axis has been auto-calibrated.
     */
    virtual void read(uint8_t &value, bool &autoCalibrated) = 0;

    virtual ~AnalogInput() noexcept {}
};

/**
 * @brief Class for analog clutch paddles
 *
 */
class AnalogClutchInput : public AnalogInput
{
protected:
    /// @brief Configured ADC pin
    ADC_GPIO pinNumber;
    /// @brief Minimum ADC reading for auto-calibration
    int minADCReading;
    /// @brief Maximum ADC reading for auto-calibration
    int maxADCReading;
    /// @brief Last ADC reading
    int lastADCReading;
    /// @brief Last axis position
    uint8_t lastValue;

public:
    /**
     * @brief Construct a new Analog Clutch Input object
     *
     * @param pinNumber ADC-capable pin number
     */
    AnalogClutchInput(ADC_GPIO pinNumber);

    void resetCalibrationData() override;

    void getCalibrationData(int &minReading, int &maxReading) override;

    void setCalibrationData(int minReading, int maxReading) override;

    void read(uint8_t &value, bool &autoCalibrated) override;
};

/**
 * @brief Analog joystick as directional input
 *
 * @note Despite using an analog device, input is reported as digital
 *
 */
class AnalogJoystickInput : public DigitalInput
{
protected:
    ADC_GPIO xAxisPin;
    ADC_GPIO yAxisPin;
    uint8_t up;
    uint8_t down;
    uint8_t left;
    uint8_t right;
    int upAdcReading;
    int downAdcReading;
    int leftAdcReading;
    int rightAdcReading;
    bool xAxisReverse;
    bool AxisReverse;

public:
    /**
     * @brief Construct a new Analog Joystick Input object
     *
     * @param xAxisPin ADC-capable pin for the horizontal axis
     * @param yAxisPin ADC-capable pin for the vertical axis
     * @param up Input number assigned to the "up" direction
     * @param down Input number assigned to the "down" direction
     * @param left Input number assigned to the "left" direction
     * @param right Input number assigned to the "right" direction
     * @param xCenter Center position of the horizontal axis in the
     *                [0,255] range
     * @param yCenter Center position of the vertical axis in the
     *                [0,255] range
     * @param xDeadZone A dead zone in the range [0,127]
     *                  for the horizontal axis.
     *                  Extreme values will not work properly.
     *                  Out of range values will be trimmed to 127.
     * @param yDeadZone A dead zone in the range [0,127]
     *                  for the vertical axis.
     *                  Extreme values will not work properly.
     *                  Out of range values will be trimmed to 127.
     * @param xAxisReverse If true, the lower reading means pushed right
     *                     If false, the lower reading means pushed left
     * @param yAxisReverse If true, the lower reading means pushed down
     *                     If false, the lower reading means pushed up
     */
    AnalogJoystickInput(
        ADC_GPIO xAxisPin,
        ADC_GPIO yAxisPin,
        InputNumber up,
        InputNumber down,
        InputNumber left,
        InputNumber right,
        uint8_t xCenter = 127,
        uint8_t yCenter = 127,
        uint8_t xDeadZone = 63,
        uint8_t yDeadZone = 63,
        bool xAxisReverse = false,
        bool yAxisReverse = false);

    virtual void read(uint128_t &state) override;
};

//-------------------------------------------------------------------
// Fake input hardware for testing
//-------------------------------------------------------------------

/**
 * @brief Fake digital input for testing
 *
 */
class FakeDigitalInput : public DigitalInput
{
private:
    FakeInput *_instance;

public:
    /**
     * @brief Construct a new Fake Digital Input object
     *
     * @param instance Fake input specification
     */
    FakeDigitalInput(FakeInput *instance) { _instance = instance; }

    virtual void read(uint128_t &state) override
    {
        // for (uint8_t i = 0; i < 128; i++)
        //     if (!_instance.mask.bit(i))
        //         state.set_bit(i, _instance.bit(i));
        state = (state & (_instance->mask)) |
                (_instance->state & ~(_instance->mask));
    }
};

/**
 * @brief Fake analog input for testing
 *
 */
class FakeAxis : public AnalogInput
{
private:
    FakeInput *_instance;
    bool _leftOrRight;

public:
    /**
     * @brief Construct a new Fake Digital Input object
     *
     * @param instance Fake input specification
     * @param leftOrRight True for the left axis,
     *                    false for the right axis
     */
    FakeAxis(FakeInput *instance, bool leftOrRight)
    {
        _leftOrRight = leftOrRight;
        _instance = instance;
    }

    void resetCalibrationData() override
    {
        _instance->recalibrationRequestCount++;
    };

    void getCalibrationData(int &minReading, int &maxReading) override
    {
        minReading = 0;
        maxReading = 254;
    }

    void setCalibrationData(int minReading, int maxReading) override {};

    void read(uint8_t &value, bool &autoCalibrated)
    {
        autoCalibrated = false;
        if (_leftOrRight)
            value = _instance->leftAxis;
        else
            value = _instance->rightAxis;
    };
};
