afpineda/OpenSourceSimWheelESP32/(commit log)

2022-05-05 Initial commit
    Previous development is located at another private repo. Preparing for publishing.
    [BatteryCalibrationTestData.ods, LiPoBatteryCharacterization.ods]
2022-05-05 Squashed commit of the following:
    commit b3e0c7b93667e79cc6dd2173de9e3cb0ecee2aeb
    Author: afpineda <74291754+afpineda@users.noreply.github.com>
    Date: Thu May 5 18:14:11 2022 +0200
    Initial commit
    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
    [BatteryCalibrationTestData.ods, LiPoBatteryCharacterization.ods]
2022-10-21 Renamed some attributes at ButtonMatrixInput
2022-10-21 Squashed commit of the following:
    commit 66df28f07eee8ab2c85f317fc92e366278cc9849
    Date: Fri Oct 21 13:54:06 2022 +0200
    Renamed some attributes at ButtonMatrixInput
    commit d95ce34706f442f3cb549a3283421840ece588a9
    Merge: fafda9e ed28590
    Date: Thu May 5 18:34:41 2022 +0200
    Merge branch 'Development'
    commit fafda9eecb047c905a592563a57f8e3aecd7abb7
    Date: Thu May 5 18:15:26 2022 +0200
    Squashed commit of the following:
    Author: afpineda <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
2022-10-22 ALPS funky switch now working
    Docs also updated. Q test OK.
2022-10-24 Squashed commit of the following:
    commit 7f94c680ffe6e1c30b840e302aee53fc3740fb47
    Date: Sun Oct 23 14:24:48 2022 +0200
    Update SimWheel.h
    commit 2bd390dd7c2f214d00817f22d4e55ef13502ef36
    Date: Sun Oct 23 14:15:17 2022 +0200
    Update changelog.md
    commit ad009d11762fc4cdf5ae1906bf296f062052fd0f
    Date: Sun Oct 23 14:06:12 2022 +0200
    more doc fixes
    commit c03136908aa9440acc7e85efe3c448a5194cc758
    Date: Sun Oct 23 13:54:14 2022 +0200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
    [ButtonMatrixTest.ino, RotaryEncoderTest.ino]
2022-10-25 Squashed commit of the following:
    commit 504af783489240b3d87a86021978e744a01467de
    Date: Mon Oct 24 08:37:51 2022 +0200
    Author: afpineda <74291754+afpineda@users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
    [BatteryCalibrationTestData.ods, LiPoBatteryCharacterization.ods]
2022-12-14 Fix issue #1
    Added common GND rail and fixed misleading tag
2022-12-14 Squashed commit of the following:
    commit ae2e36423585e6fd1755d886376dd4e48d1947db
    Date: Wed Dec 14 13:58:16 2022 +0100
    Fix issue #1
    commit 4bf3201692e489a321e4d46885374b420bd4b5bb
    Merge: ac6b5bf 1e4f3f5
    Date: Wed Dec 14 11:02:11 2022 +0100
    Merge branch 'main' into BugFix
    commit ac6b5bfc9959d64b6201cdbc61da3d3b1403b2b0
    Date: Wed Nov 2 14:27:56 2022 +0100
    commit 9acdd53f28531727b636b2c20e9a7bb78a995114
    Author: afpine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
2022-12-25 Added generic frame server
    Added a generic frames server and the corresponding test unit.
2022-12-27 rework on unitary QA test
    [AnalogAxisTest.ino, ButtonMatrixTest.ino, DeepSleepTest.ino, DigitalInputsTest.ino, PowerLatchTest.ino, RotaryEncoderTest.ino, power.cpp]
2022-12-28 Rework on InputHubTest. Passed.
    [InputHubTest.ino]
2023-01-02 Doc on simple voltage divider for the battery monitor
2023-01-17 Squashed commit of the following:
    commit 080404ffd578f4615ce4ce86b074b1be2bfd4e75
    Date: Tue Jan 17 12:28:15 2023 +0100
    Ready for release
    commit 06ec6a39dc4af58020f365b39ded356c7ec3edb0
    Date: Mon Jan 16 13:25:08 2023 +0100
    wip
    commit 69fb2bdb3b2c6527e342286a8307289d24cd7dd6
    Date: Sun Jan 15 09:41:58 2023 +0100
    work on documentation
    commit b0a84ae2a82bddcdfd88c4bbb4cb0e08398e49b1
    Date: Fri Jan 13 16:32:12 2023 +0100
    Set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
    [LiPoBatteryCharacterization.ods]
2023-01-18 Squashed commit of the following:
    commit 06621899b06633f8b4d58f264faa4e7dd209a714
    Date: Tue Jan 17 12:28:58 2023 +0100
    Author: afpineda <74291754+afpineda@users.noreply.github.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
    [LiPoBatteryCharacterization.ods]
2023-02-09 Test for LilyGO T-QT devkit board
    Added a basic big bang test for T-QT devkit
2023-02-18 Squashed commit of the following:
    commit e296895c52fb1e7fe8544dc7c01ed812487ebf53
    Date: Sat Feb 18 11:29:46 2023 +0100
    Added the "teabox" design
    commit bb4fb2871227b9e818d88fae068af5b34115e5ba
    Merge: 95c0788 5f4af21
    Date: Fri Feb 17 23:07:33 2023 +0100
    Merge branch 'BugFix' into Development
    commit 95c07886c783c342e8704eda8a6b9e4b5346f32b
    Merge: 17f75d7 f1c25ef
    Date: Fri Feb 17 23:06:46 2023 +0100
    Merge branch 'main' into Development
    commit 5f4af215628fd0b7389ecdd7d14c23e3275d1861
    Autho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
    [Teabox.ino]
2023-03-01 Added a few notes about HE sensors
2023-09-25 Compile-time workaround for issue #2
    Note: Not tested. Don't have an ESP32C3 board.
    [power.cpp]
2023-09-28 Update BatteryMonitor_en.md
    Added "Limitations"
2023-09-28 Squashed commit of the following:
    commit a9daf676091b1844587b43ee74552d6b382aa461
    Date: Tue Sep 26 08:40:49 2023 +0200
    commit 41a8830be1005a44b82f30358d15e3acfe290f7b
    Date: Tue Sep 26 08:33:26 2023 +0200
    Added known issue and doc fix
    commit a8452ae07a604faedcb29c1e15ab464587fd8458
    Date: Mon Sep 25 13:14:52 2023 +0200
    Compile-time workaround for issue #2
    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
    [power.cpp]
2023-10-01 Added test unit for deep sleep on ESP32C3
2023-11-01 ESP32-Arduino native BLE implementation
2023-11-01 NimBLE implementation improved
    To match ESP-Arduino implementation
2023-12-22 Funky switches advices (issue #4)
    Explicit advice is given about the wiring of funky switches
2024-01-09 Rework on rotary encoders
    [RotaryEncoderTest.ino]
2024-01-10 Rework in progress
    NimBLE unit test also passed
    [BatteryMonitorTest.ino, ButtonMatrixTest.ino, DeepSleepTest.ino, PowerLatchTest.ino, RotaryEncoderTest.ino, ShiftRegistersTest.ino]
2024-01-11 rotary encoder test passed
2024-01-12 User-defined buttons map is working
2024-01-13 Sketches updated to new API
    And minor errata fixes or doc improvements
    [BatteryCalibration.ino, CustomSetup.ino, InputHubTest.ino, RestoreBatteryCalibration.ino, Setup2.ino, Setup3.ino, Setup4.ino, Setup5.ino]
2024-02-22 Notes on I2C input hardware
2024-02-23 Notes on input circuitry for rotary encoders
2024-03-02 Input from I2C GPIO expanders (test unit)
2024-03-02 Added I2C address auto-detection
2024-03-05 Support for custom I2C pins
2024-03-07 Fixed mistake in funky switch terminals
2024-03-07 Fixed Setup 9 schematics
2024-03-08 Fixed mistake about I2C availability
2024-03-13 Work on button matrix input number specs
2024-03-14 I2C wake-up test
2024-06-01 Remove generic references to ESP32-WROOM-32
2024-06-02 Better explanation of power sources
2024-06-12 In sync with ESP-Arduino v3.0.1
2024-06-15 Fix wrong input numbers in setup9
    [Setup9.ino]
2024-06-15 Bug fix in Setup9
    [Setup9.ino]
2024-07-07 Updated comparison of input circuitry
2024-07-12 Fix bug in Setup3.ino and remove deprecated call
    [Setup3.ino]
2024-07-28 Encoded button matrices
2024-07-31 Custom PID in BLE implementation
2024-08-08 Fix compilation error in battery tools
    [BatteryCalibration.ino]
2024-08-16 Redesign of some modules
    [power.cpp]
2024-08-16 Added I2C auxiliary module
2024-08-16 Add BatteryMonitor module
2024-08-18 Load battery calibration data just when needed
2024-08-19 Rework on I2C devices
    [I2C_probe.ino, i2c.cpp]
2024-08-19 Add doc on battery monitors
2024-08-24 Fix minor bug in I2C probe
    [I2C_probe.ino]
2024-08-24 Doc on ESP32S3
2024-08-25 Replace ESP32 for ESP32S3 in test procedures
    [Proto1.ino]
2024-08-26 Update I2cExpanderTest
2024-08-26 Fix i2cTools for ESP32C3 boards
2024-08-26 Fix deep sleep not enabling internal pull resistor
    Now using EXT0
    [power.cpp]
2024-08-26 Fix battery monitor in TestBoard1
2024-08-27 Fix compilation error and some errata
    [CustomSetup.ino, Setup1.ino]
2024-09-18 Rework on notifications interface
    [BatteryMonitorTest.ino, DeepSleepTest.ino, FuelGaugeTest.ino, InputHubTest.ino, PowerLatchTest.ino, Proto1.ino, power.cpp]
2024-09-20 Implement telemetry in the frame server
2024-09-21 Rework HID reports 2 and 6
    [hidTestHelper.cpp]
2024-09-21 Rework the notify module
    [Proto1.ino]
2024-09-21 Implement save/load current UI page
2024-09-22 Add frame time to serveSingleFrame()
2024-10-05 Update powertrain reports
2024-10-06 Bug fix in batteryMonitor::setPeriod()
2024-10-13 Document power for LEDs
2024-10-18 Work on LED strips (in progress)
2024-10-24 work on LED strips
2024-10-24 Update LED strips doc
2024-10-24 Reallocate code for LED strips
2024-10-24 Model LED strip segments for telemetry display
2024-10-24 Add shift light LED segment
2024-10-25 Update LEDStripTest
2024-10-25 Document LED strips
2024-10-26 Detect some error conditions
    [SimWheelUI.cpp]
2024-10-26 Test single-pixel LED segments
2024-10-26 Fix to compile with C++20 (Arduino IDE 2.3.2)
2024-10-27 Modify I2C_probe.ino to discover devices in the secondary bus
2024-10-29 Test battery monitor
2024-10-29 Improve I2C probe
2024-10-30 Fix minor bug in BatteryCalibration.ino
    [BatteryCalibration.ino]
2024-11-02 Clarify WS2812 LED driver family
2024-11-02 Clarify LED strip brightness
2024-11-02 Support more WorldSemi's pixel drivers
2024-11-02 Remove WS2816 family of LED drivers
    those are 16-bits per color channel
2024-11-02 Support SK6812 and UCS1903 LED drivers
2024-11-04 Clarify LED strips and 3.3V power sources
2024-11-04 Bug fix in LedStrip.cpp
    [LEDStripTest.ino]
2024-11-13 Fix compilation errors and warnings
    [AnalogAxisTest.ino, BatteryMonitorTest.ino, I2C_probe.ino, TelemetryIntegrationTest.ino]
2024-11-16 Fixed issue when using i2cTools
2024-12-16 Working with NimBLE-Arduino 2.1.0 (unit test passed)
    Some workarounds were needed
2024-12-19 Enhance de LED Strip low level implementation
2024-12-20 Remove unwanted log traces
2024-12-20 Add missing mocks to test units
    [DeepSleepTest.ino, PowerLatchTest.ino]
2025-01-03 Fix compiler error for pure ESP32 boards in the ESP-Arduino HID implementation
2025-01-10 Check usage of PSRAM pins in pure ESP32 boards
2025-01-12 Fix Windows notifications not being sent on reconnection (NimBLE)
    See https://github.com/lemmingDev/ESP32-BLE-Gamepad/pull/257/files
2025-01-13 Clarify I2C address format
2025-01-14 Add circuit design for 16-channel multiplexers
2025-01-14 Update Setup4 schematics
2025-01-14 Update Setup5 schematics
2025-01-18 Update to NimBLE-Arduino version 2.2.0
2025-01-18 Update to Arduino-ESP32 core version 3.1.1
2025-01-20 Fix wrong pin for testing
2025-01-24 Implement adjustable pulse width in rotary encoders
2025-01-24 Implement "pulse width" commands for rotary encoders
2025-01-24 Improve rotary encoder "pulses"
2025-01-26 Advice on LED strips to avoid burn out
2025-01-28 Advice on battery capacity
2025-01-28 Reduce size of BatteryShieldSpecs.png
2025-01-31 Fix compiler error on ESP32-C3 boards
2025-03-15 Version 7
    [BatteryCalibrationTestData.ods]
2025-03-16 BatteryMonitorTest updated and passed
2025-03-18 Update power latch test procedure
2025-03-19 Add missing protected methods to PixelControlNotification
    [SimWheelTypes.hpp, pixels.cpp]
2025-03-19 Fix wrong filename (part 2)
    [inputs.cpp]
2025-03-19 Fix wrong filenames (part 2)
    [batteryCalibration.cpp, batteryMonitor.cpp]
2025-03-19 Fix wrong optimize pragma (gcc)
    [InputHardware.cpp]
2025-03-20 Fix errata in Switches_en.md
2025-03-21 Fix wrong Arduino core URL
2025-03-24 Bug fixes on "ready-to-deploy" designs (ESP32)
    [Setup1.ino, Setup2.ino, Setup3.ino, Setup6.ino, SimWheelTypes.hpp]
2025-03-24 Bug fixes on "ready-to-deploy" designs (ESP32S3)
    [Setup5.ino, Setup7.ino]
2025-04-14 Remove context switching in LEDStrip::show()
2025-04-16 Rework on active wait
    [HAL.cpp, HAL.hpp, InputHardware.cpp, OutputHardware.cpp]
2025-04-24 Bug fix in reserved VID/PID check
    [hidCommon.cpp]
2025-04-26 Fix incomplete button matrix examples
2025-05-07 Prevent short circuits in BM without diodes
    [InputHardware.cpp]
2025-05-21 Fix compiler warnings when using ESP core version 3.2.0
    [HAL.cpp, OutputHardware.cpp, power.cpp]
2025-05-21 Fix minor bug and errata in the HID test units
    [hidCommon.cpp]
2025-05-29 Info on coded rotary switches
2025-05-29 Implement rotary coded switches
2025-05-29 Add a unit test for rotary coded switches
2025-05-29 Fix some doxygen commentaries
    [HAL.hpp, InputHardware.hpp]
2025-06-15 Fix bug in add74HC165NChain()
    [inputs.cpp]
2025-06-26 Add PCB module 24 switches
    [Module24Switches_TH_2025.epro]
2025-06-27 Add ground planes to PCB
    [Module24Switches_TH_2025.epro]
2025-06-27 Add PCB module for 24 switches (SM)
    [Module32Switches_SM.epro, Module32Switches_SM_BOM.csv, Module32Switches_SM_PickAndPlace.csv]
2025-06-27 Add PCB module for 32 switches (TH)
    [Module32Switches_TH.epro, Module32Switches_TH_BOM.csv, Module32Switches_TH_PickAndPlace.csv]
2025-06-27 Add pinout to PCB documentation
2025-06-28 Add overview of PCBs
2025-06-28 Add button matrix PCB
    [ModuleBtnMatrix25sw.epro, ModuleBtnMatrix25sw_BOM.csv, ModuleBtnMatrix25sw_PickAndPlace.csv]
2025-06-29 Update PCB
    [ModuleBtnMatrix25sw.epro]
2025-06-30 Add generic binary coded switches
2025-06-30 Document generic coded switches
2025-07-01 Rework the handling of OnStart events in pixel control notifications
    [InternalServices.hpp, PixelControlTest.ino, SimWheelTypes.hpp, batteryMonitor.cpp, pixels.cpp]
2025-07-02 Rework notifications in telemetry displays
    [SimWheelUI.cpp]
2025-07-08 Add serial number to NimBLE device info
2025-07-08 Add serial number to ESPBLE device info
2025-07-10 Add warning about power pins in PCB designs
2025-07-13 Fix bug with recursive timed mutex in pixelcontrol
    [pixels.cpp]
2025-07-17 Fine-tune the brightness workaround
    [LEDStripTest.ino]
2025-07-18 Remove the 32 sw module / SM PCB
    [Module32Switches_SM.epro, Module32Switches_SM_BOM.csv, Module32Switches_SM_PickAndPlace.csv]
2025-07-18 Create play and charge PCB
    [ModulePlayAndCharge.epro, ModulePlayAndCharge_BOM.csv, ModulePlayAndCharge_PickAndPlace.csv]
2025-07-18 Fix inconsistent handling of pixel control notifications on startup
    [InternalServices.hpp, PixelControlTest.ino, SimWheelTypes.hpp, TelemetryIntegrationTest.ino, batteryMonitor.cpp, pixels.cpp]
2025-07-18 Rework UIUnitTest to detect untriggered events
    [UIUnitTest.ino]
2025-07-18 Fix pixel control notifications on startup
    [SimWheelTypes.hpp, pixels.cpp, storage.cpp]
2025-07-24 Add missing implementation of `inputs::initializeI2C()` and additional parameter
    [HAL.cpp, HAL.hpp, SimWheel.hpp, inputs.cpp]
2025-08-03 Add Aisler to the PCB manufacturer list
2025-08-19 Fix missing device capability flag
    [inputs.cpp]
2025-08-19 Print firmware errors on USB CDC aswell
    [firmware.cpp]
2025-08-19 Add custom PCB firmware
2025-08-20 Prevent disconnection due to user inactivity
    [inputs.cpp]
2025-08-20 Fix USBSerial printing
2025-08-20 Disable shutdown on low battery by default
2025-08-23 Rework battery monitor hardware
    [BatteryMonitorHardware.hpp, InternalServices.hpp, InternalTypes.hpp, SimWheelTypes.hpp, batteryMonitor.cpp]
2025-08-23 Update CDCI: BatteryMonitorTest
2025-08-23 Rename CDCI test: VoltageDividerMonitor
2025-08-23 Enhance CDCI Test: VoltageDividerMonitorTest
2025-08-24 Rework BatteryMonitorTest
2025-08-24 Fix filename lower case (part 1)
2025-08-24 Fix filename lower case (part 2)
    [BatteryMonitorHardware.cpp]
2025-08-24 Fix wrong data type
    [BatteryMonitorHardware.cpp]
2025-08-26 Update module24Switches
    [Module24Switches_TH_2025-BOM.csv, Module24Switches_TH_2025-PickAndPlace.csv, Module24Switches_TH_2025.epro]
2025-08-26 Update PCB ModuleBtn25sw
2025-08-27 Update doc on PCB modules
2025-09-01 Minor tweaks to LEDStrip for performance
2025-09-03 Custom devkit documentation and firmware
    [CustomDevKit.epro, CustomDevKit_BOM.csv, CustomDevKit_PickAndPlace.csv]
2025-09-03 Update to NimBLE-Arduino 2.3.5
2025-09-25 Fix bug when DMA is not available (pure ESP32 boards)
    [OutputHardware.cpp]
2025-09-25 Fix the stack size for the (input) polling task
    [inputs.cpp]
2025-09-25 Improve error handling at ADC readings
    [HAL.cpp]
2025-09-25 Rework getADCreading()
    Fixes adc_oneshot_read() returning ESP_ERR_TIMEOUT at random (only on "pure" ESP32 boards and ADC2). ADC initialization now takes place only once.
    [HAL.cpp]
2025-09-26 Reset the watchdog timer on each event callback
    [InternalTypes.hpp]
2025-09-26 Fix test button matrix input numbers
    [Testing.hpp]
2025-09-26 Fix bug when pairing and having pixel control notifications.
    [pixels.cpp]
2025-09-27 Fix wrong ADC channel initialization
    [HAL.cpp]
2025-10-09 Rework battery calibration sketch
    [BatteryCalibration.ino]
2025-10-09 Update battery calibration procedure
2025-10-09 Update battery calibration doc
2025-10-16 Enhance battery calibration
2025-10-30 Fix hidServiceProvider and add regression test
    [GPIOTest.cpp, ServiceMocks.hpp, hidCommon.cpp]
2026-02-28 Rework I2C input hardware due to deprecated API
    [HAL.cpp, HAL.hpp, HAL_dummy.cpp, I2CExpanderTest.ino, I2C_probe.ino, InputHardware.cpp, InputHardware.hpp]
2026-03-01 Rework battery monitor hardware due to deprecated I2C API
    [BatteryMonitorHardware.cpp, BatteryMonitorHardware.hpp, BatteryMonitorTest.ino, FuelGaugeTest.ino]
2026-03-01 Rework I2C output hardware due to deprecated API
    [OutputHardware.cpp, OutputHardware.hpp, Testing.hpp]
2026-03-01 Update VoltageDividerMonitorTest to avoid timing errors
    [BatteryMonitorHardware.cpp, BatteryMonitorHardware.hpp, VoltageDividerMonitorTest.cpp]
2026-03-01 Update battery monitor
2026-03-01 Fix wrong battery status in fuel gauges
    [BatteryMonitorHardware.cpp]
2026-03-10 Fix compilation errors in OLED telemetry
    [OutputHardware.hpp, SimWheelUI.hpp, SimWheelUI_gfx.cpp, TelemetryIntegrationTest.ino]
2026-03-10 Try VoltageDividerMonitorTest fix on Linux
    [VoltageDividerMonitorTest.cpp]
2026-03-11 Bug fixes to OLED
    [OutputHardware.cpp, OutputHardware.hpp]
2026-03-11 Bug fix in i2c probe
    [HAL.cpp]
2026-03-11 Fix insufficient stack size in OLED telemetry UI
    [SimWheelUI.hpp]
2026-03-11 Replace semaphore for latch in UI shutdown
    [ui.cpp]
2026-03-11 Fix printf in OLED telemetry
    [SimWheelUI_gfx.cpp]
2026-03-16 Rework setup8 due to connectivity
    [Setup8.ino]
2026-03-19 Add missing code commentaries
    [SimWheelTypes.hpp, SimWheelUI.hpp]
2026-03-20 Add another automated test for coded switches
2026-03-21 Rework event routing API and fix tests
    [GenericCodedSwitchTest.ino, InputHubTest.ino, Proto1.ino, SimWheel.hpp, inputHub.cpp]
2026-03-21 Add routed input to show battery level in OLED displays
2026-03-22 Rework dependency injection (continued)
    [BatteryCalibration.ino, DeepSleepTest.ino, InputHubTest.ino, PowerLatchTest.ino, Proto1.ino, RestoreBatteryCalibration.ino, StorageTest.ino]
2026-03-25 Rework pixel control (work in progress)
    [HAL.hpp, HAL_dummy.cpp, InternalTypes.hpp, LEDStripTest.ino, OutputHardware.cpp, OutputHardware.hpp, SimWheel.hpp, SimWheelInternals.hpp]
2026-03-26 Fix pixel vector sizes in notifications
    [SimWheelTypes.hpp, pixels.cpp]
2026-03-26 Fix bug in pixels_clear()
    [hidCommon.cpp]
2026-03-27 Fix OnSettingsSaved not triggering
    [storage.cpp]
2026-04-05 Support for APA106 pixel drivers
2026-04-18 Wheels telemetry specification
2026-04-18 Enable wheel telemetry data in user interfaces
2026-04-19 Bug fix in CustomDevKitFirmware.ino
    [CustomDevKitFirmware.ino]
2026-06-08 Fix bug in AnalogJoystickInput constructor
    [InputHardware.cpp]
2026-10-15 Prevent Arduino-ESP32 from freeing BLE memory
2026-10-17 Add guards for ESP32S2 boards (when BLE is not available)
2026-10-21 Improve GAP handling and debug traces
2026-11-13 Remove wrong circuit design
